zedward856-spec/minideck/README.md

# Minideck

A pocket clamshell cyberdeck. It's fully parametric (Python + [build123d](https://github.com/gumyr/build123d)) and printed on a Bambu printer.

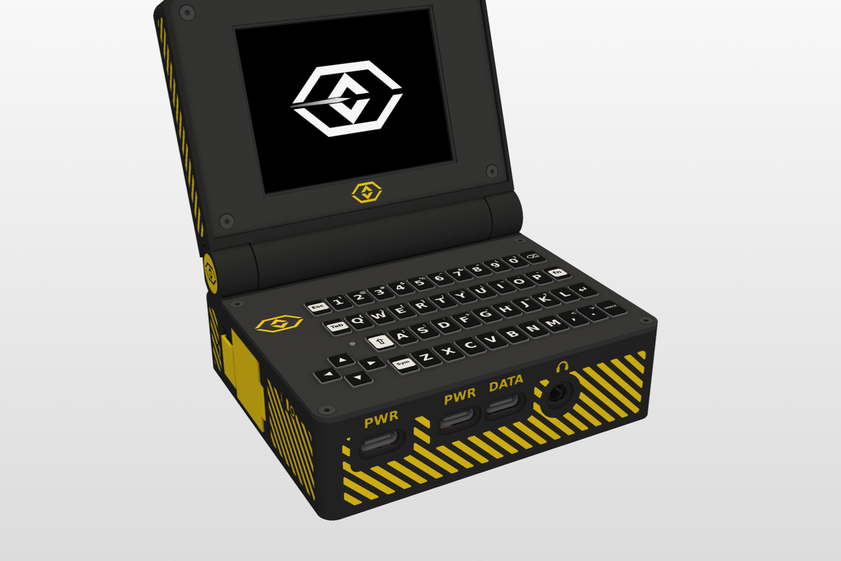
[picture p1: docs/img/palette1_front.png]
Minideck, Cyber yellow


**[Print files →](print/)** · **[Build guide →](BUILD.md)** · [Wiring](WIRING.md) · Promo site: https://zedward856-spec.github.io/minideck-site/ (its own repo: [minideck-site](https://github.com/zedward856-spec/minideck-site)) · [3D viewer / AR](https://zedward856-spec.github.io/minideck-site/viewer/) · [Wiring](https://zedward856-spec.github.io/minideck-site/wiring/) · [Thermal lab](https://zedward856-spec.github.io/minideck-site/thermal/)

Reports: [fit checks](reports/fit_report.md) · [assembly check](reports/assembly_report.md) · [thermal](reports/thermal_report.md) · [printability](reports/printability_report.md) · **[print simulation](docs/print-sim/README.md)** (every part sliced: layers, time, filament)

- **Size:** 93.7 × 81.5 × 39.5 mm (closed).
- **Lid:** opens to 180° on a hidden torque hinge with a hollow axle for the cables.
- **Battery:** one protected 18650 behind a hinged door, held shut by a C-clip lock.
- **Power switch:** a flush slide switch in the left wall; its printed fin sits level with the case so it can't get bumped in a pocket.
- **Power:** Pololu U3V40F5 5 V boost (~2.6 A).

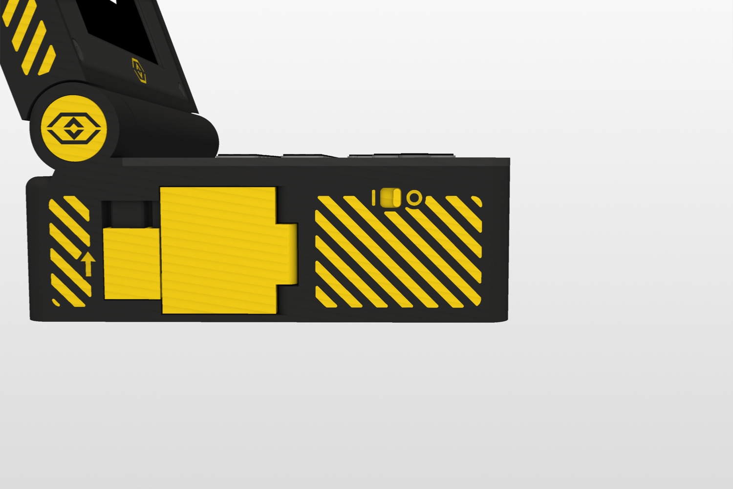
[picture p2: docs/img/left_switch.png]
Left side: battery door and the flush power switch


---

## Colour palettes

Press keys **1–6** in the viewer to switch palettes live. Palette 1 is the one being printed.

| # | Palette | Front | Back |
|---|---|---|---|
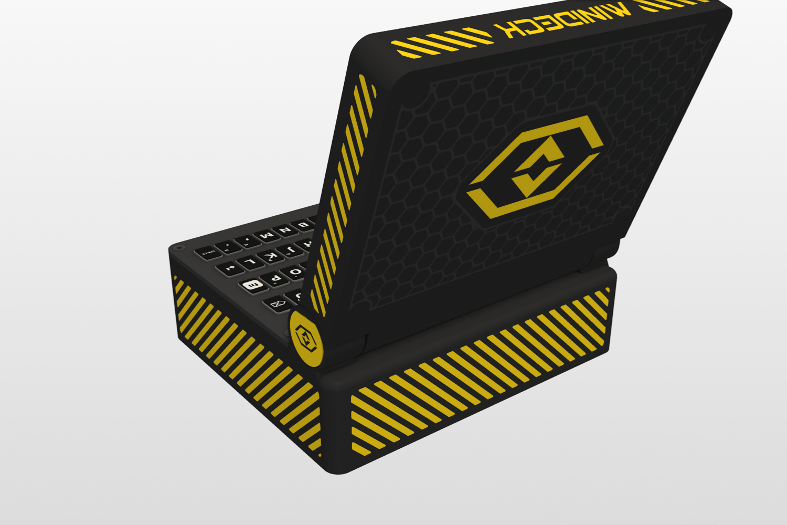
[picture p3: docs/img/palette1_back.png]
| 1 | **Cyber yellow** (print colours) |  |  |
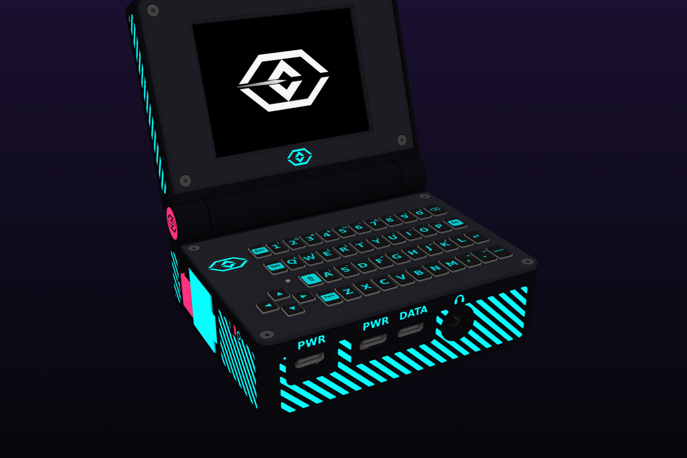
[picture p4: docs/img/palette2_front.png]
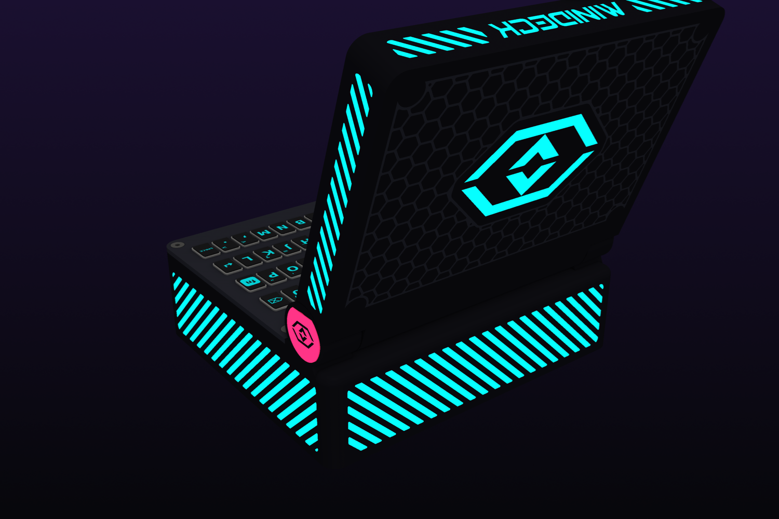
[picture p5: docs/img/palette2_back.png]
| 2 | **Neon night** |  |  |
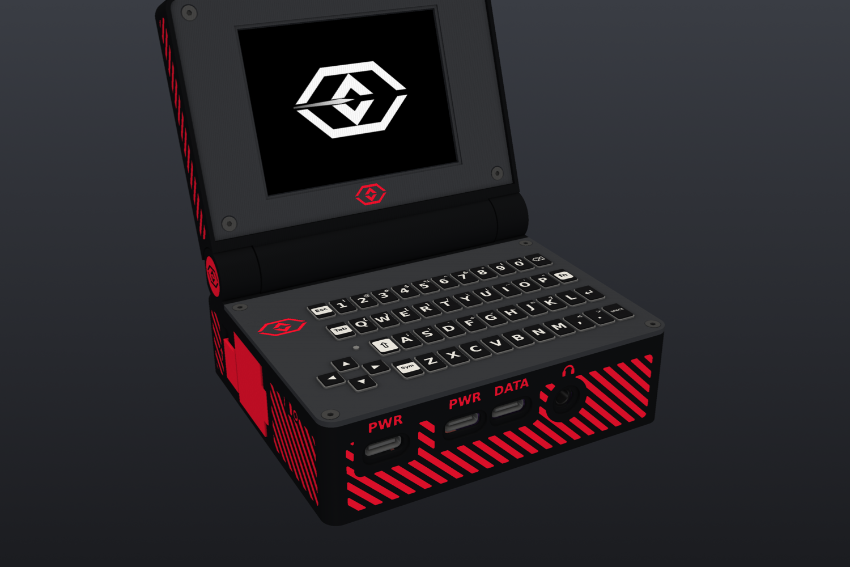
[picture p6: docs/img/palette3_front.png]
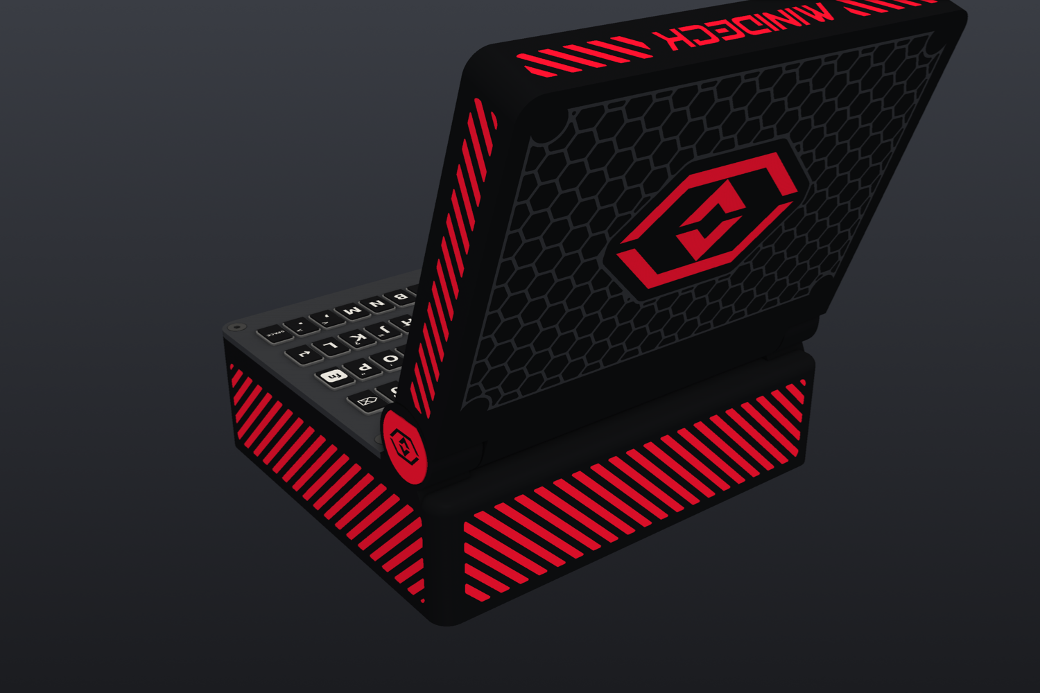
[picture p7: docs/img/palette3_back.png]
| 3 | **Arasaka** |  |  |
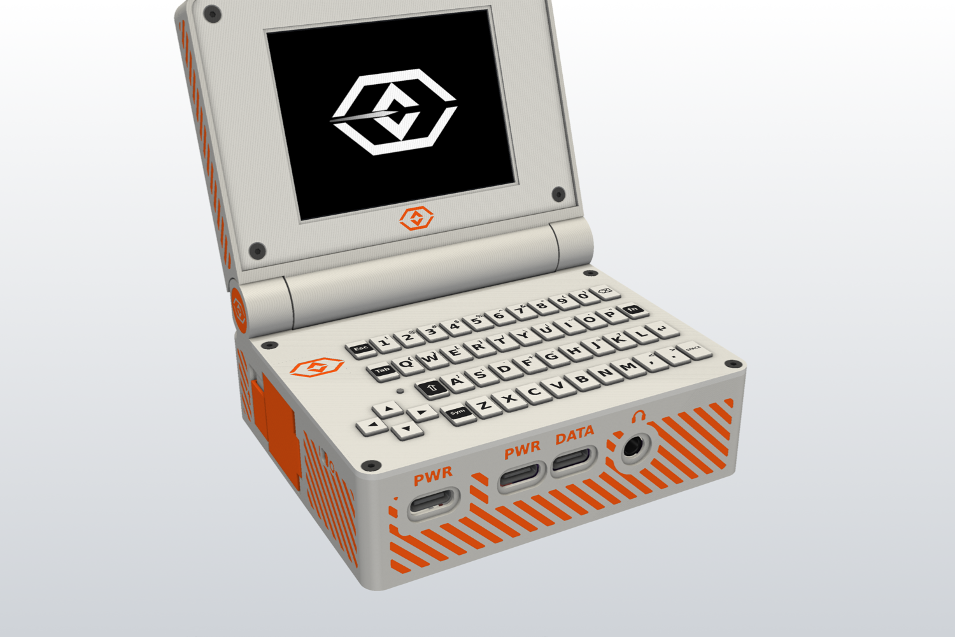
[picture p8: docs/img/palette4_front.png]
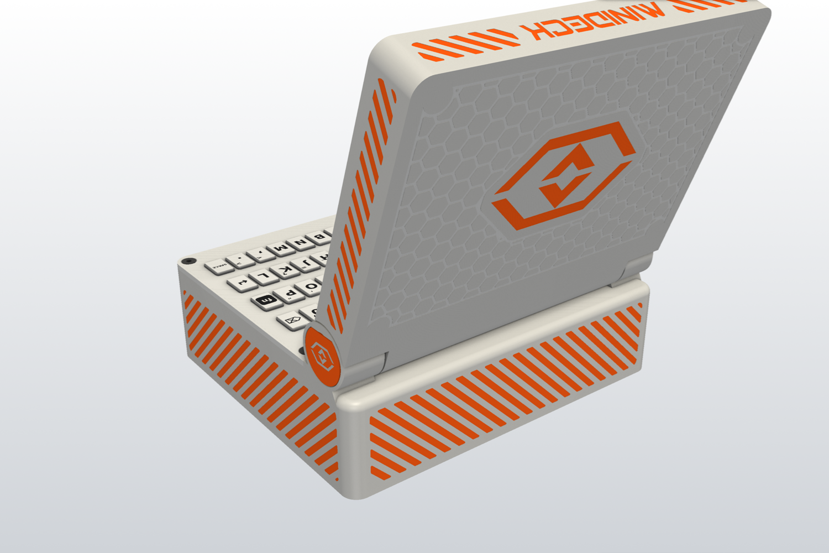
[picture p9: docs/img/palette4_back.png]
| 4 | **Snow** |  |  |
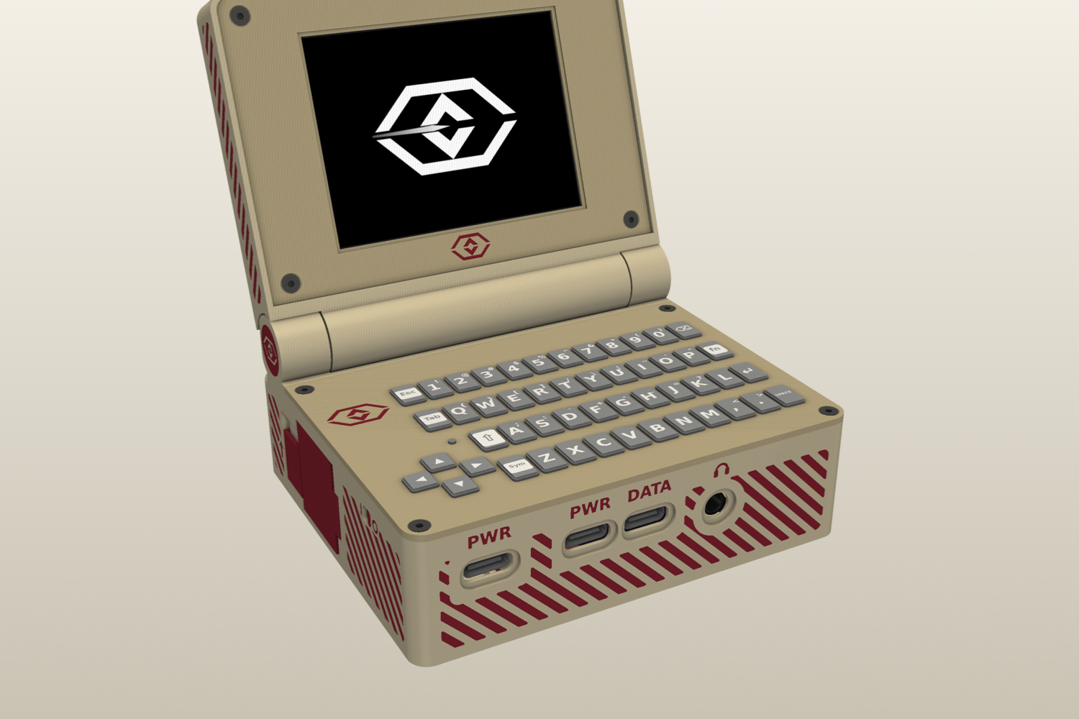
[picture p10: docs/img/palette5_front.png]
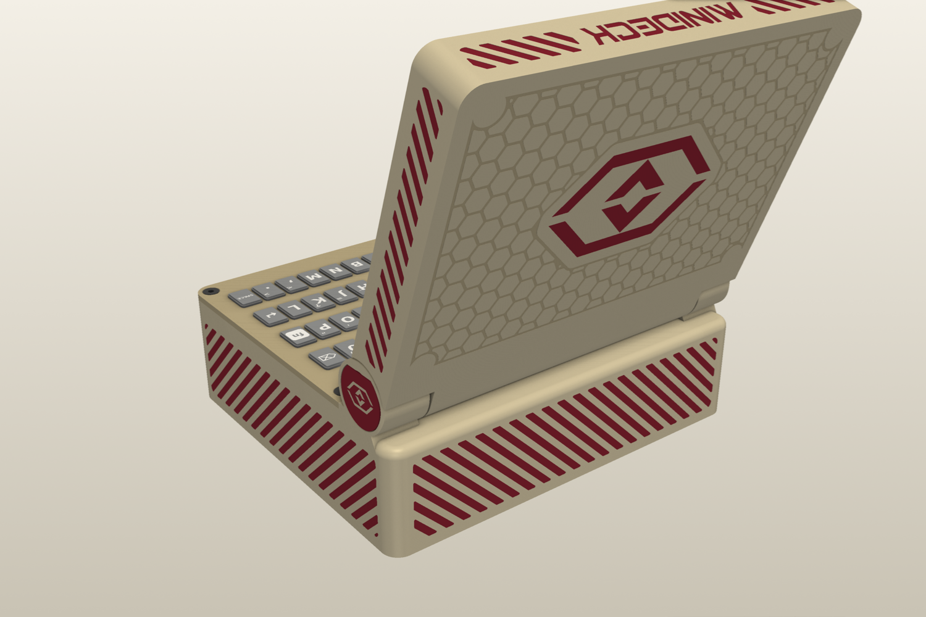
[picture p11: docs/img/palette5_back.png]
| 5 | **Retro beige** |  |  |
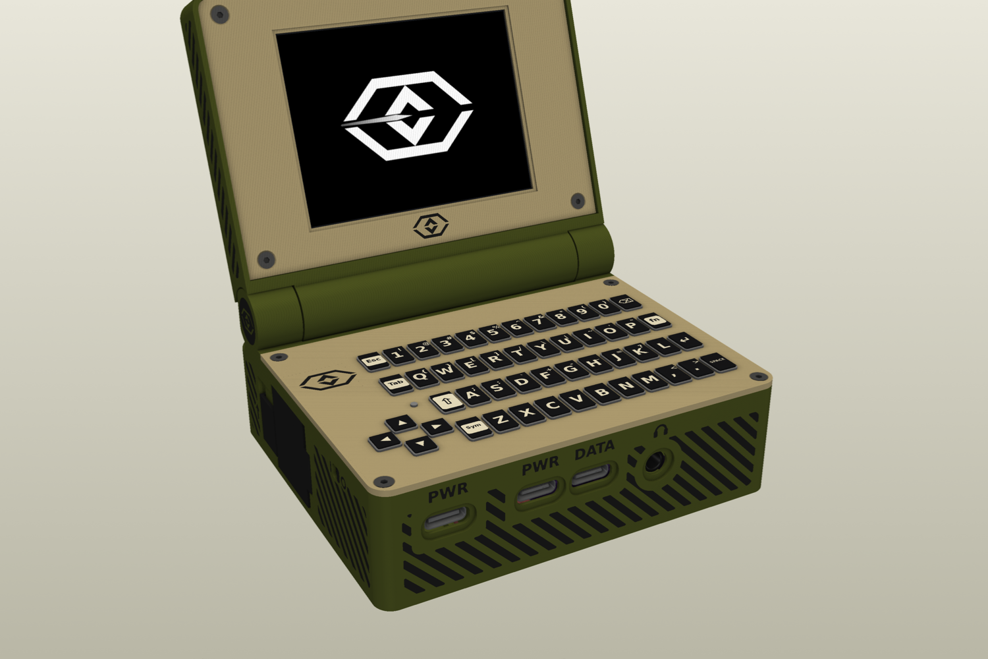
[picture p12: docs/img/palette6_front.png]
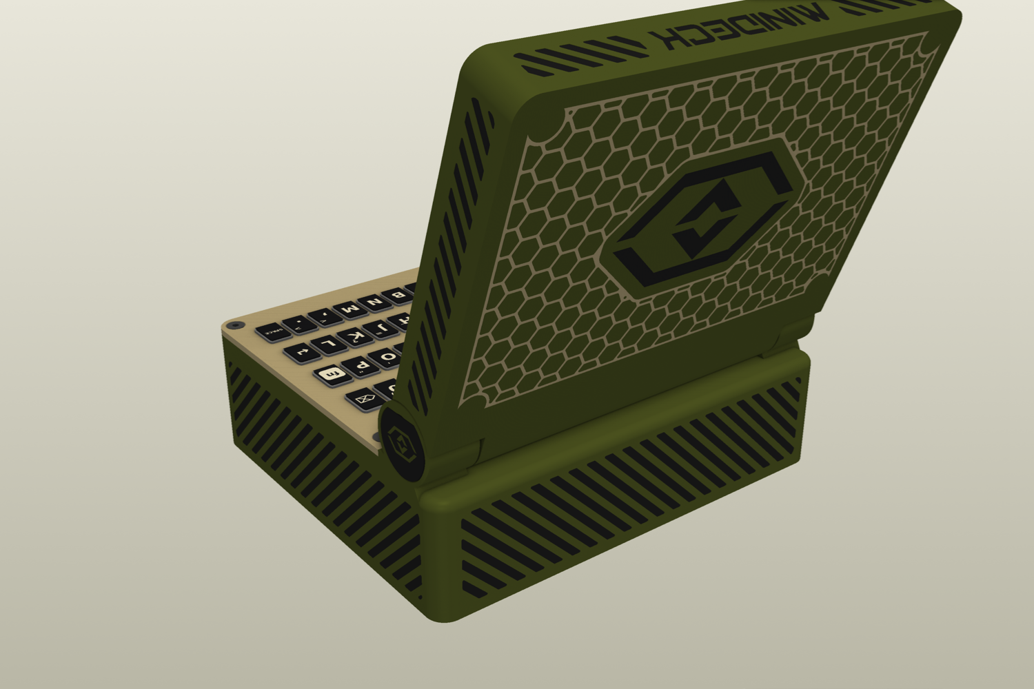
[picture p13: docs/img/palette6_back.png]
| 6 | **Field olive** |  |  |

| # | Body | Plate / bezel | Accent | Keys / legends |
|---|---|---|---|---|
| 1 | `#2D2D2D` charcoal | `#3D3D3D` dark grey | `#F7D116` cyber yellow | black / white |
| 2 | `#0D0D12` | `#22232C` | `#05D9E8` cyan + `#FF2A6D` magenta | black / cyan |
| 3 | `#111214` | `#3B3D42` | `#E0102A` red | black / white |
| 4 | `#E7E6E1` | `#F6F6F3` | `#FF5A10` orange | white / black |
| 5 | `#D6C9A8` | `#BFB08C` | `#7A1F2B` maroon | grey / white |
| 6 | `#4B5320` olive | `#B8A77C` tan | `#1A1A1A` black | black / cream |

The logos, MINIDECK text, side stripes and the NFC mark on the underside are engraved 0.3–0.6 mm deep.

**Underside:** an NFC mark right under the PN532 (board outline, antenna coil, NFC, 13.56 MHz, ISO 14443 A/B, TAP HERE).

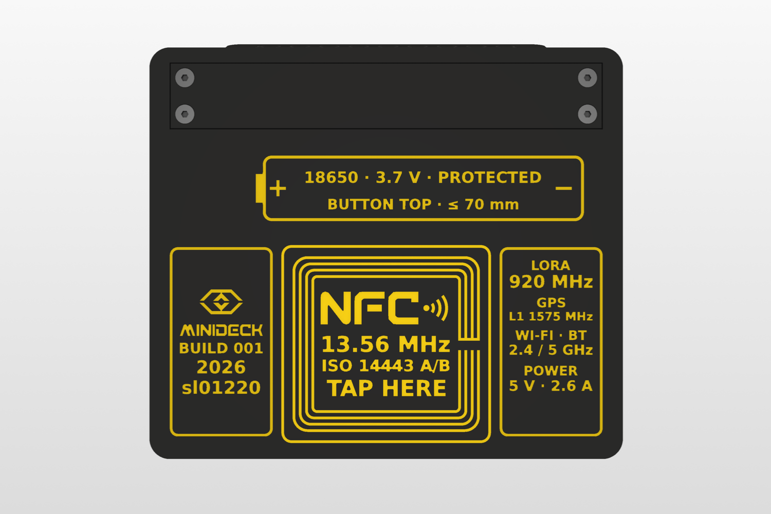
[picture p14: docs/img/underside_nfc.png]
Underside NFC mark

 The renders show them paint-filled: fill them with a paint marker and wipe the surface with IPA. No multi-colour printer needed.

---

## Parts list

### Printed parts

Ready-to-print files are in **[`print/`](print/)**: one folder per filament colour, already in print orientation. Their source files are below, in `out/`.

| File | Part | Colour (palette 1) | Notes |
|---|---|---|---|
| `bottom.stl` | Case bottom: battery chamber, hinge box, ports | Charcoal `#2D2D2D` | Main body; M2 heat-set inserts |
| `keyboard_top.stl` | Keyboard plate | Dark grey `#3D3D3D` | 4 × M2 × 4 screws; 0.12 mm layers recommended (0.42 mm webs) |
| `screen_back.stl` | Lid shell | Charcoal `#2D2D2D` | Lid-back logo, MINIDECK text, stripes |
| `screen_front.stl` | Screen bezel | Dark grey `#3D3D3D` | 4 × M2 screws into lid inserts |
| `box_hatch.stl` | Hinge-box floor hatch | Charcoal `#2D2D2D` | 4 × M2 screws |
| `battery_door.stl` | 18650 battery door | Cyber yellow `#F7D116` | **Print upright, with a brim** |
| `battery_lock_slider.stl` | Battery door C-clip lock | Cyber yellow `#F7D116` | Slides on a rail; no screw |
| `hinge_cap.stl` | Torque hinge end cap | Cyber yellow `#F7D116` | Logo engraved |
| `hinge_axle.stl` | Hollow hinge axle (cable bore) | Cyber yellow `#F7D116` | Logo on the flange |
| `battery_strip_test.stl` | Battery door / lock test strip | any | Optional fit test |

Suggested filament: Bambu PLA Matte Charcoal, PLA Basic Dark Gray and PLA Basic Sunflower Yellow.
`printability_report.md` has the full print audit.

### Electronics

| Part | Role |
|---|---|
| Radxa ZERO 3W | Main computer (mounted upside down, wires soldered to the header pads) |
| EP28060S 2.8″ non-touch IPS panel | Display (in the lid) |
| EHD-40P-V3 HDMI driver board | Display driver (in the lid) |
| M5Stack CardKB + HarukiToreda silicone cover | Keyboard (I²C) |
| PN532 | NFC reader (I²C, chained with the CardKB) |
| PCM5102 I²S DAC | Audio out, 3.5 mm jack |
| Ebyte E22-900T22S | LoRa radio (UART4) |
| GPS module (ATGM336H-class) + 18 × 18 mm ceramic patch | GPS (UART3); patch antenna in the lid |
| NooElec NESDR Nano 2+ | SDR, wired to header pins 27/28 (USB2 HOST2) – no hub |
| Molex 211140 / 146153 FPC antennas | LoRa, Wi-Fi/BT and SDR antennas |
| TP4056 (USB-C) | 18650 charger |
| Pololu U3V40F5 | 5 V boost, ~2.6 A (fed past the charger's protection) |
| Protected high-drain 18650 (button top, ≤ 70 mm) | Battery |

### Hardware

| Qty | Part |
|---|---|
| 12 | M2 × 4 countersunk screws (plate 4, hatch 4, bezel 4) |
| 8 | M2 heat-set inserts, Ø3.5 × 3 mm (hole Ø3.2): 4 hatch, 4 bezel (the plate screws go into printed pilots) |
| 1 | Friction torque hinge (pocket in the left hinge cheek) |
| – | Silicone wire: 22/24 AWG for power, 28–30 AWG for signals; 1.13 mm u.FL coax for the antennas |

Every wire, pin and splice is in **[WIRING.md](WIRING.md)**. The same wiring as Obsidian canvases (open the folder as a vault, or drop the files into one): [every wire](wiring/minideck-wiring-all.canvas) (47) · [power only](wiring/minideck-wiring-power.canvas) (25).

---

## Thermal

A 3D thermal simulation of the base (`cad/thermal_sim.py`: every part on a 1 mm grid, heat from the SoC, SDR, boost, charger and
cell, conduction inside, convection + radiation outside) compares the current sealed design with vents, PETG, an aluminium
heat path, a micro blower and software limits. **[Interactive thermal lab →](https://zedward856-spec.github.io/minideck-site/thermal/)**:
pick a load and a cooling option, slice through the deck, hover for temperatures, or see everything above a threshold in 3D.
Full table: [thermal_report.md](reports/thermal_report.md).

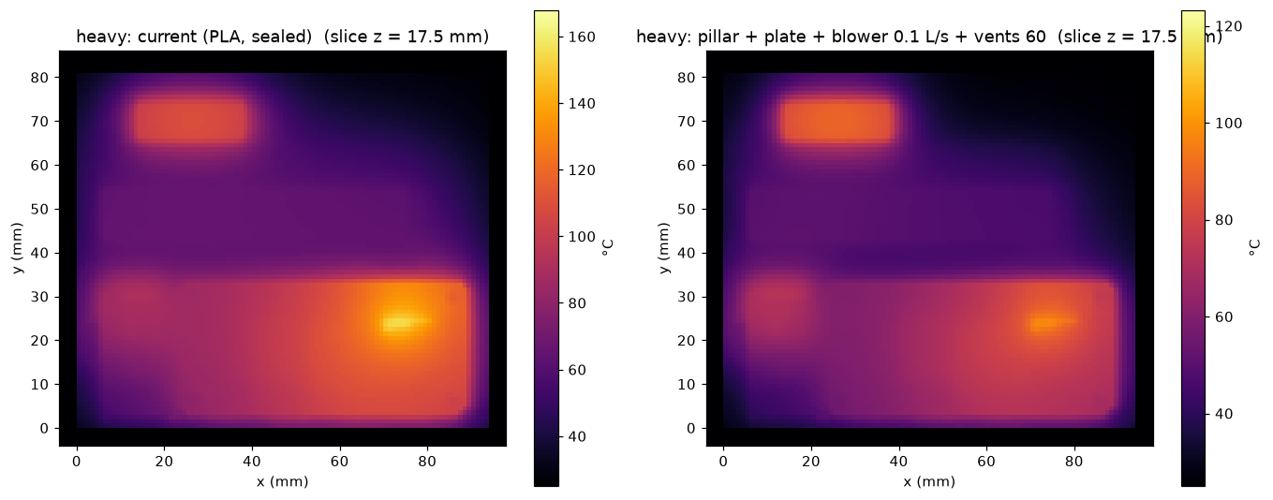
[picture p15: previews/thermal_compare.png]
Thermal: heavy load, current vs best option


| Heavy use (SDR + Wi-Fi + CPU) | SoC | Battery | SDR |
|---|---|---|---|
| current (PLA, sealed) | 168 °C | 68 °C | 114 °C |
| vents 150 mm² | 163 | 65 | 110 |
| Al pillar SoC → Al floor plate | 129 | 67 | 113 |
| micro blower 0.2 L/s + vents | 131 | 46 | 84 |
| pillar + plate + blower + vents | **105** | **53** | **94** |
| SDR switched off | 166 | 59 | 38 |
| CPU capped at 1.2 W | 119 | 65 | 112 |

Typical use, sealed: SoC ~81 °C, battery ~40 °C. Vents barely help (the deck is only ~15 mm tall inside); the aluminium path is
the biggest win for the CPU, a blower for the battery and SDR. Sustained heavy load is shown un-throttled: the real SoC slows
itself down around 85–95 °C. Estimates for comparing options, not lab measurements.

## Repository layout

```
README.md  BUILD.md  WIRING.md    start here: overview, build guide, every wire
print/      the print files, one folder per filament colour
wiring/     Obsidian canvases of the wiring (every wire / power only)
reports/    fit checks, assembly simulation, thermal simulation, printability
cad/        the parametric CAD + check / simulation / export scripts (Python, build123d)
app/        the offline Android viewer app (com.zedward.minideck)
models/     source models, fonts, logo, component models
out/        raw CAD output (STL, STEP, meshes in place)
docs/img/   README renders        previews/   check / thermal preview images
```

Scripts run from anywhere (they switch to the repo root themselves), e.g. `python3 cad/base.py`.

| Path | What |
|---|---|
| `cad/params.py` | Every dimension and option (logos, stripes, text, inserts, radios) |
| `cad/layout.py` | Places the parts from the reference layout `models/minideck.stl` |
| `cad/base.py`, `cad/lid.py`, `cad/battery_test.py` | Case bottom, plate, hatch, hinge / lid shell and bezel / battery chamber, door and lock |
| `cad/stripes.py`, `cad/logo.py`, `cad/fills.py` | Hazard stripes, Optic logo engraving, paint-fill preview meshes |
| `cad/marks.py`, `cad/nfc_mark.py` | Engraved labels: PWR / PWR / DATA + headphones over the ports, &#124; / O by the power switch, open arrow by the battery lock, underside battery outline + ID and radio plates, NFC mark, lid hex texture (each clipped so ≥ 0.45 mm of wall stays) |
| `cad/wiring.py` | Wiring plan + 3D wire routes (`WIRING.md`) |
| `cad/keycaps.py`, `cad/screws.py` | Viewer-only silicone keycaps and screws |
| `cad/check.py` | Fit / clearance requirements (`reports/fit_report.md`) |
| `cad/assembly_check.py` | Simulates the whole build part by part: can every part get in? (`reports/assembly_report.md`) |
| `cad/thermal_sim.py`, `cad/thermal_export.py` | 3D thermal simulation (`reports/thermal_report.md`) and its export for the interactive thermal lab |
| `cad/printability.py` | Print audit → `reports/printability_report.md` |
| `cad/viewer.py` | Interactive 3D viewer |
| `print/` | **The print files**, one folder per colour (`python3 cad/export_print.py` rebuilds it) |
| `out/` | Raw CAD output: STLs, STEP assemblies, `parts_in_place/` meshes for the viewer |
| `models/` | Source models, Corpta font, logo SVG, Radxa downloads and schematic; `models/components/` real part models (sources in [BUILD.md](BUILD.md#component-models)), `models/coloured/` their real-colour versions |
| `docs/img/` | README renders |
| `app/` | Offline Android viewer: `app/build.sh install` bundles the site's model and installs it (see [app/README.md](app/README.md)) |
| `cad/print_sim.py` | Slices every print file with PrusaSlicer and renders the layers, times and filament → `docs/print-sim/` |
| `cad/site_wiring.py` | Data for the site's wiring page (pin map, every wire, notes, canvases) |
| `wiring/` | `minideck-wiring-all.canvas` (47 wires), `minideck-wiring-power.canvas` (25), made by `cad/wiring_canvas.py` |

## Promo site

Live at https://zedward856-spec.github.io/minideck-site/ (repo `minideck-site`). Re-export the web model with `python3 cad/site_export.py && python3 cad/plan_explode.py` (writes into `../minideck-site/assets/`; the second plans the collision-free teardown).

## Build and view

```bash
pip install build123d trimesh manifold3d shapely pyvista pillow
python3 cad/battery_test.py && python3 cad/base.py && python3 cad/lid.py && python3 cad/wiring.py && python3 cad/fills.py && python3 cad/check.py
python3 cad/viewer.py            # 1-6 palettes · g stripe fill · scroll the part list · sliders for lid angle / transparency
```

Re-render the README images (product shots with no UI):

```bash
MINIDECK_CLEAN=1 MINIDECK_PALETTE=1 python3 cad/viewer.py --shot docs/img/palette1_front.png
MINIDECK_CLEAN=1 MINIDECK_PALETTE=1 MINIDECK_CAM="[(190,230,140),(47,42,25),(0,0,1)]" python3 cad/viewer.py --shot docs/img/palette1_back.png
```

---

© zedward. The Corpta font is a demo licence, the Radxa models and schematic are © Radxa, and the logo is the author's own.
