zedward856-spec/minideck/docs/img/palettes_grid.png

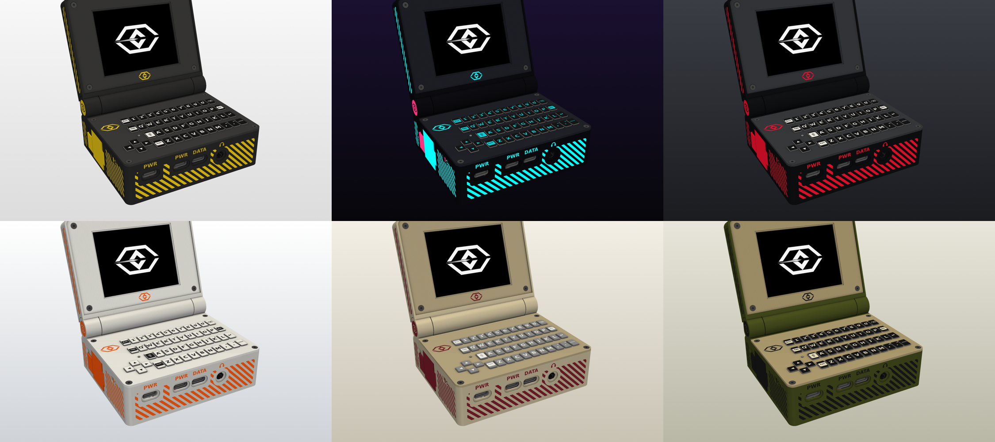
docs/img/palettes_grid.png
