zedward856-spec/minideck/models/nzxt_reference.jpg

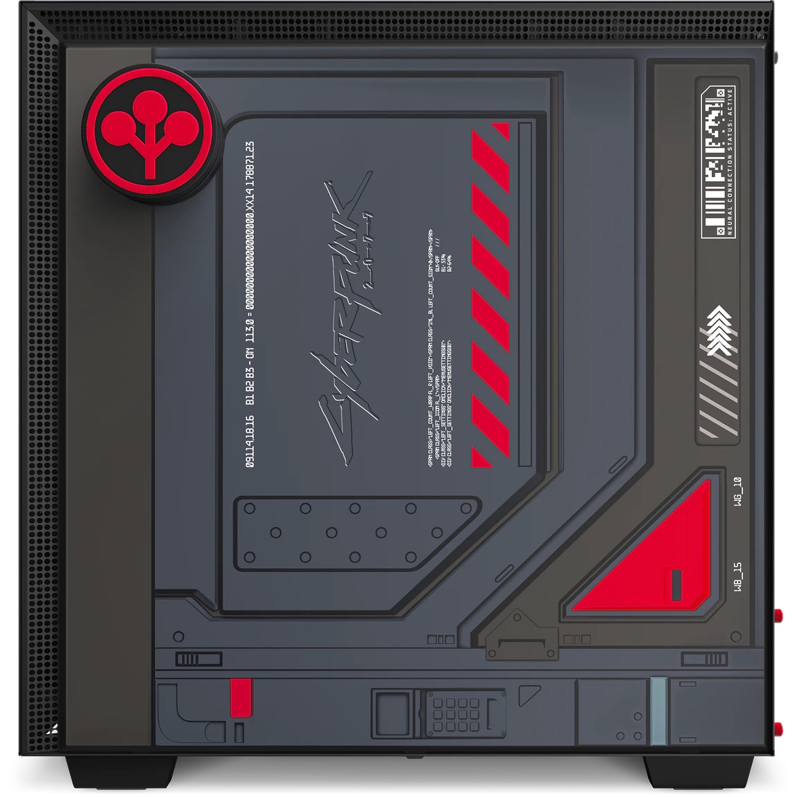
models/nzxt_reference.jpg
