zedward856-spec/minideck/models/optic-loading.gif

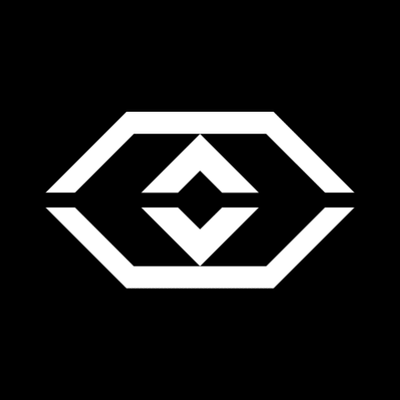
models/optic-loading.gif
