zedward856-spec/minideck/previews/1_front.png

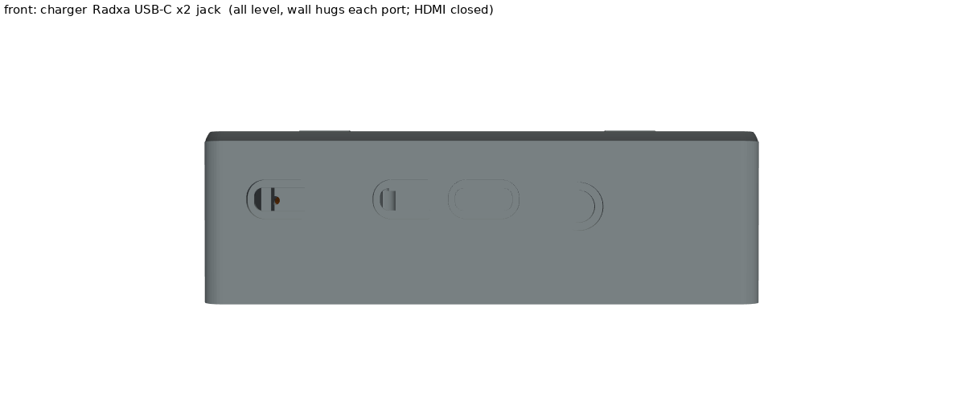
previews/1_front.png
