zedward856-spec/minideck/previews/2_back.png

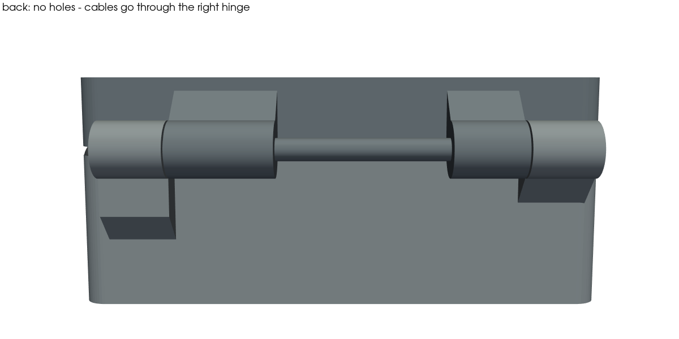
previews/2_back.png
