zedward856-spec/minideck/previews/4_open.png

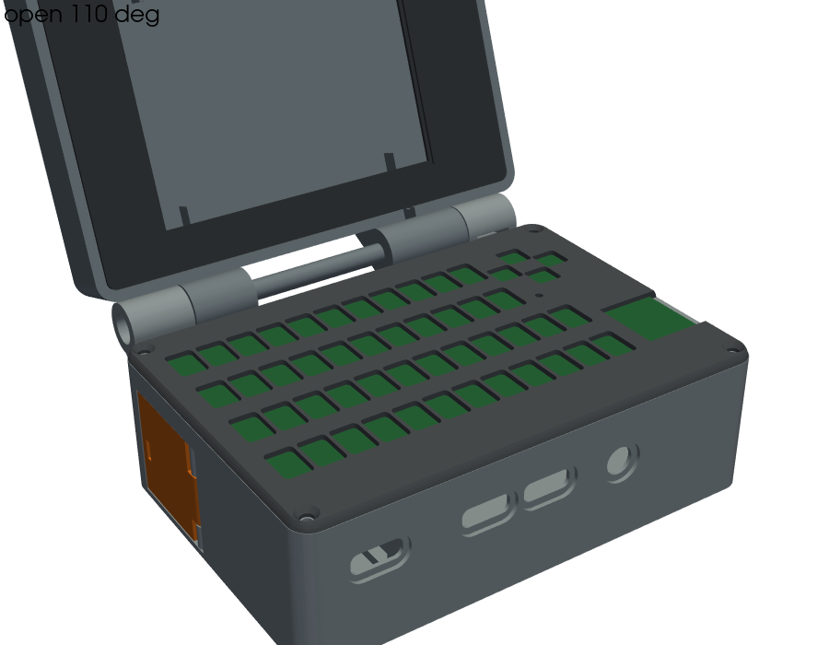
previews/4_open.png
