zedward856-spec/minideck/previews/battery_door_lock.png

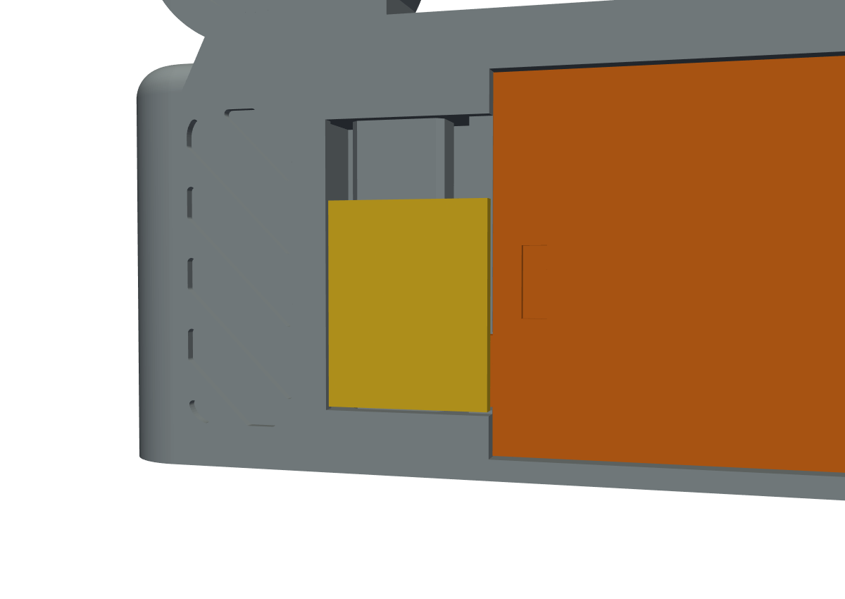
previews/battery_door_lock.png
