zedward856-spec/minideck/previews/bezel_seam.png

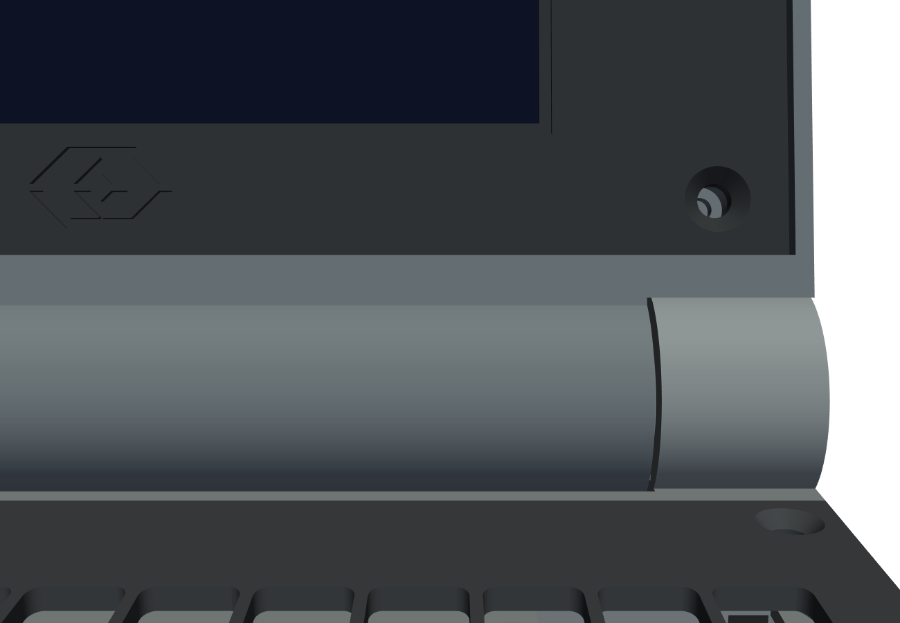
previews/bezel_seam.png
