zedward856-spec/minideck/previews/bezel_text.png

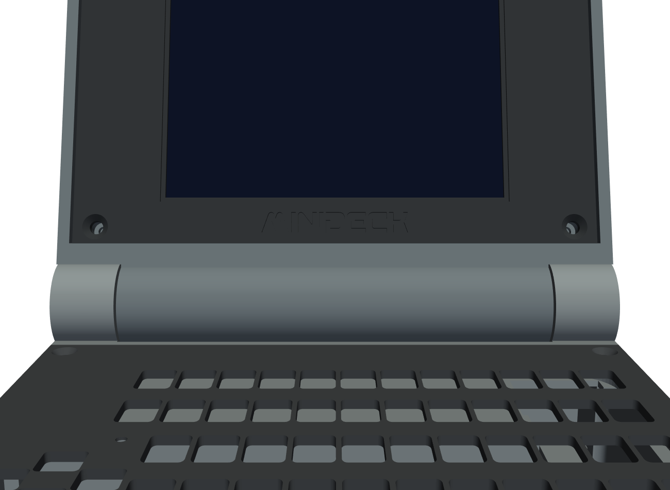
previews/bezel_text.png
