zedward856-spec/minideck/previews/box_closed_back.png

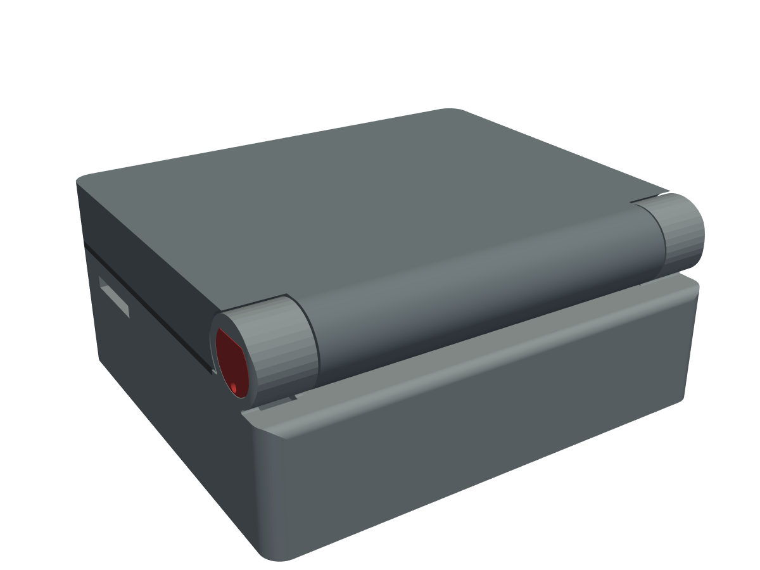
previews/box_closed_back.png
