zedward856-spec/minideck/previews/box_closed_side.png

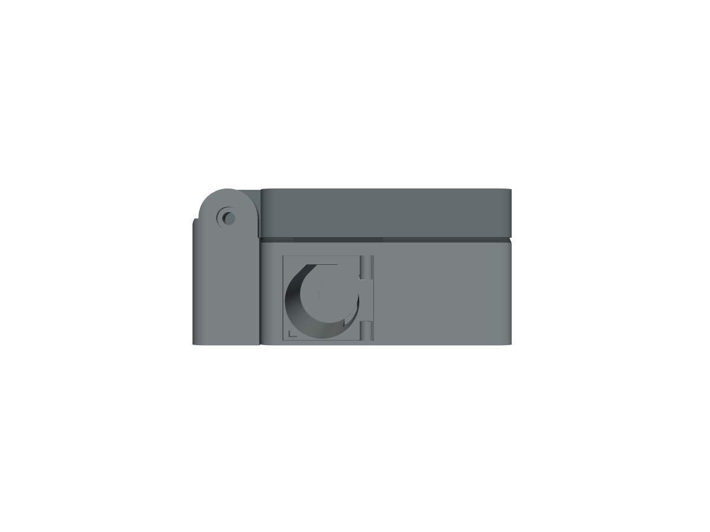
previews/box_closed_side.png
