zedward856-spec/minideck/previews/box_corner_left.png

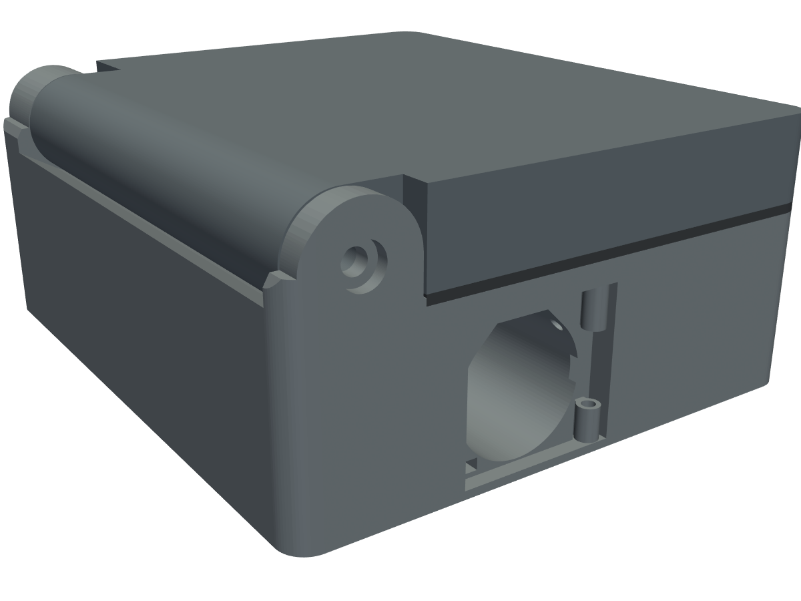
previews/box_corner_left.png
