zedward856-spec/minideck/previews/box_open_110.png

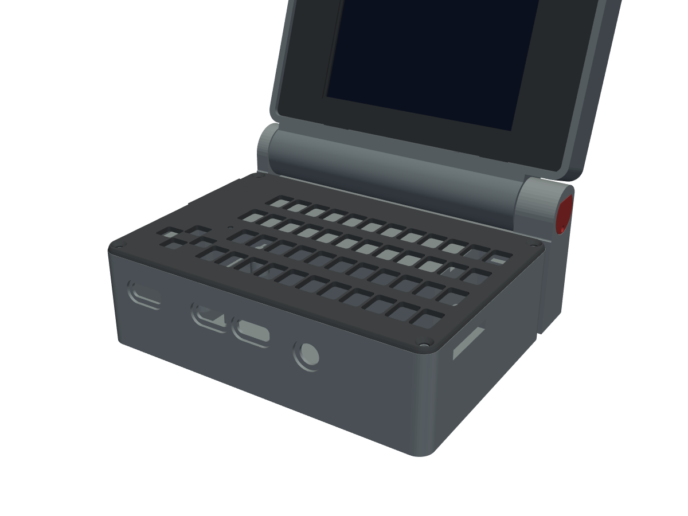
previews/box_open_110.png
