zedward856-spec/minideck/previews/box_open_150_side.png

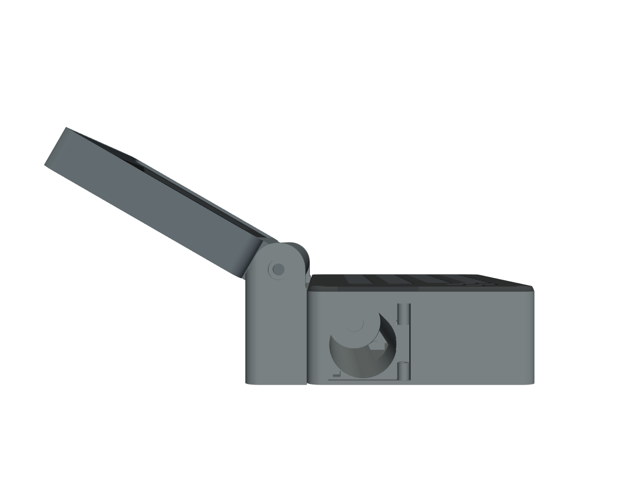
previews/box_open_150_side.png
