zedward856-spec/minideck/previews/box_section_cable.png

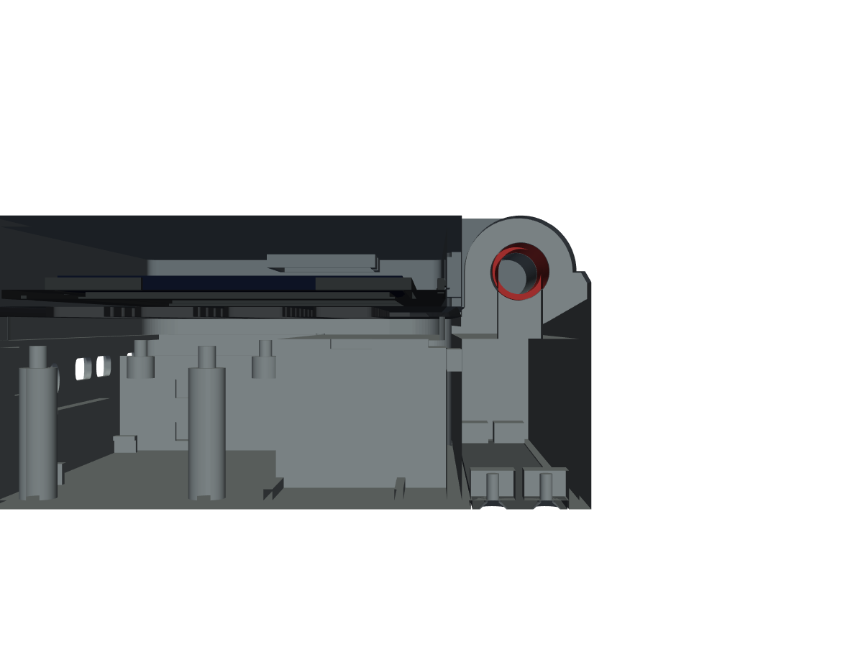
previews/box_section_cable.png
