zedward856-spec/minideck/previews/cheek_back_L.png

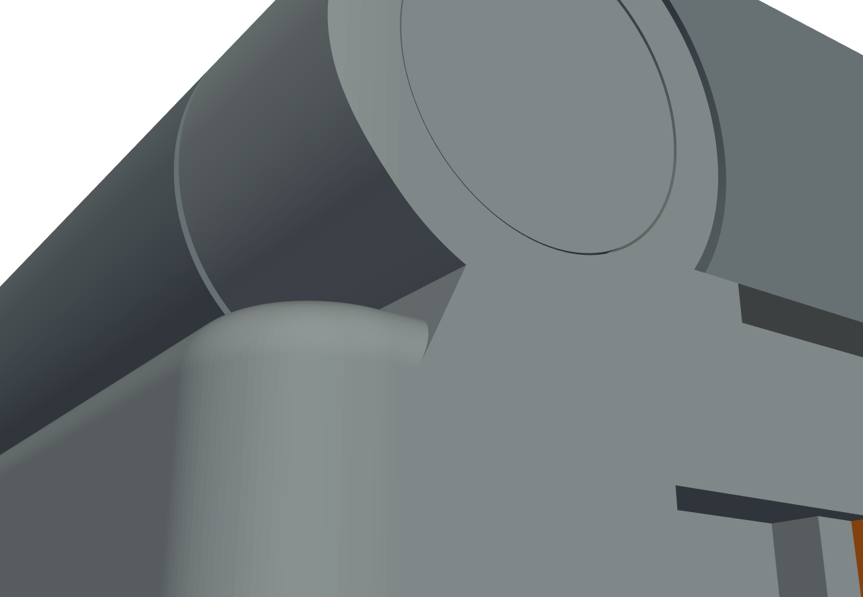
previews/cheek_back_L.png
