zedward856-spec/minideck/previews/cheek_back_R.png

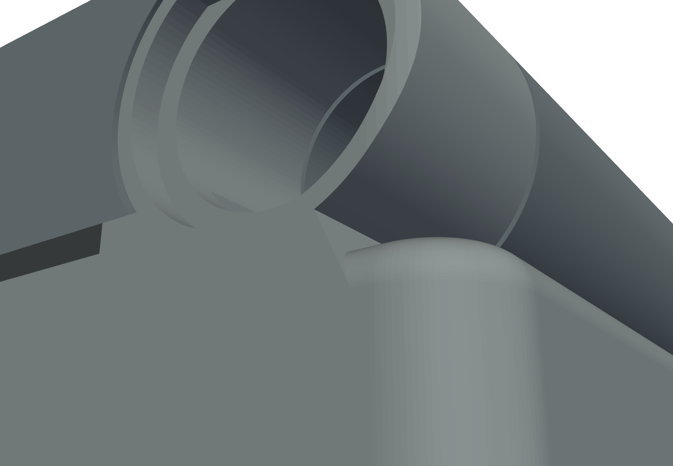
previews/cheek_back_R.png
