zedward856-spec/minideck/previews/corner_L.png

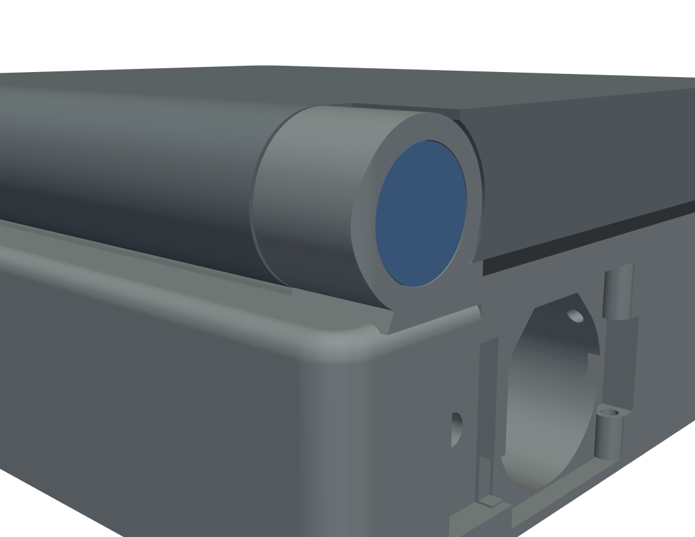
previews/corner_L.png
