zedward856-spec/minideck/previews/corner_R.png

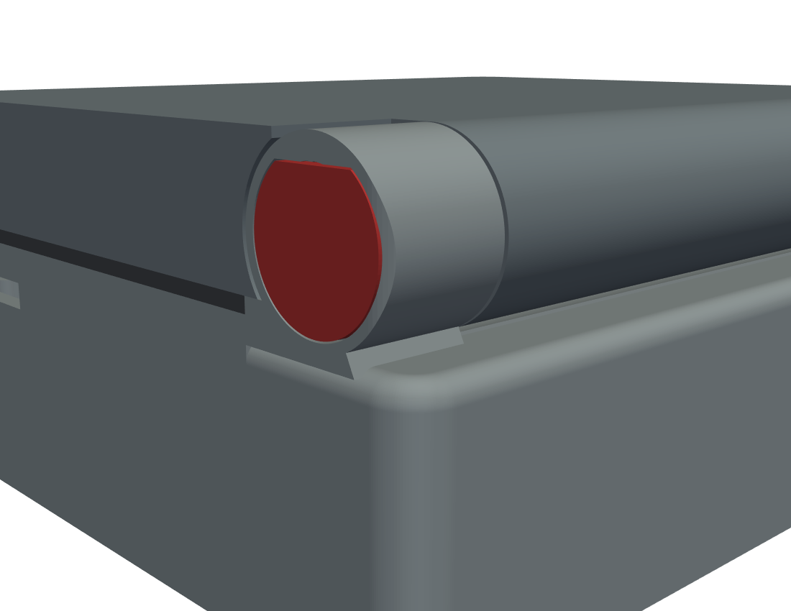
previews/corner_R.png
