zedward856-spec/minideck/previews/fill/back_0.png

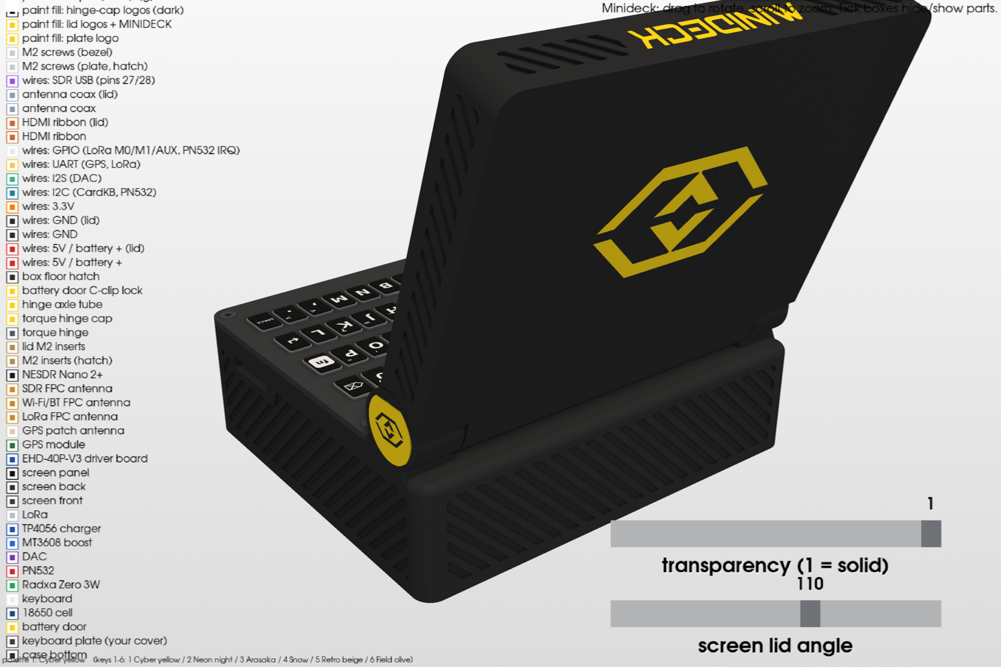
previews/fill/back_0.png
