zedward856-spec/minideck/previews/fill/front_0.png

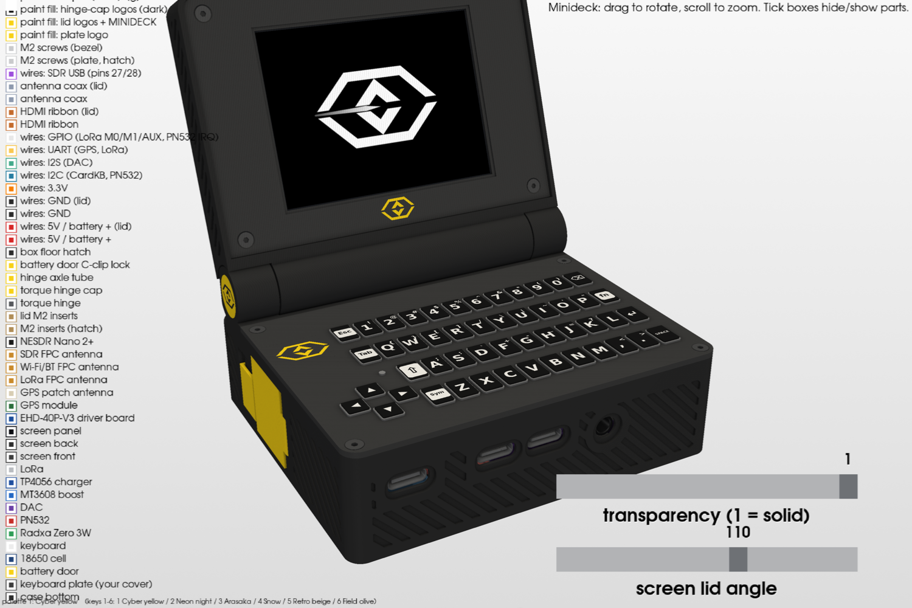
previews/fill/front_0.png
