zedward856-spec/minideck/previews/fill_compare.png

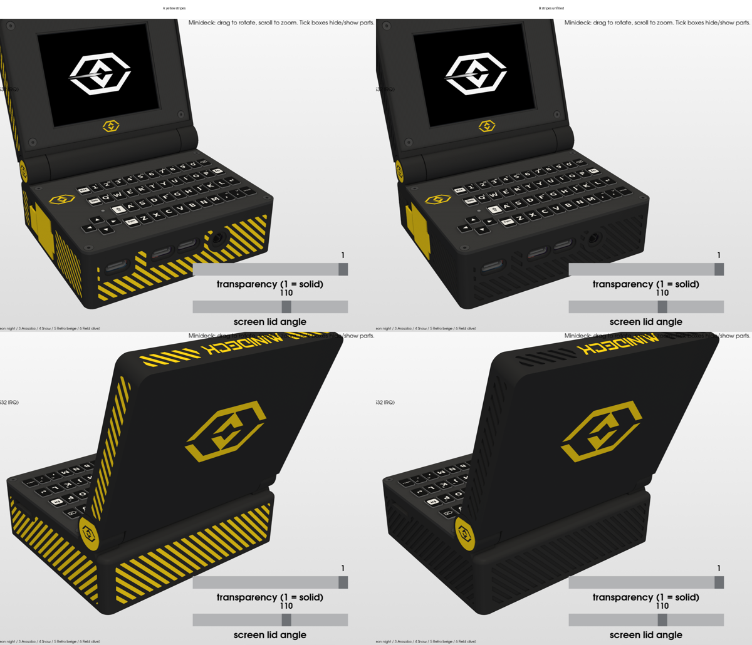
previews/fill_compare.png
