zedward856-spec/minideck/previews/gps_module_bay.png

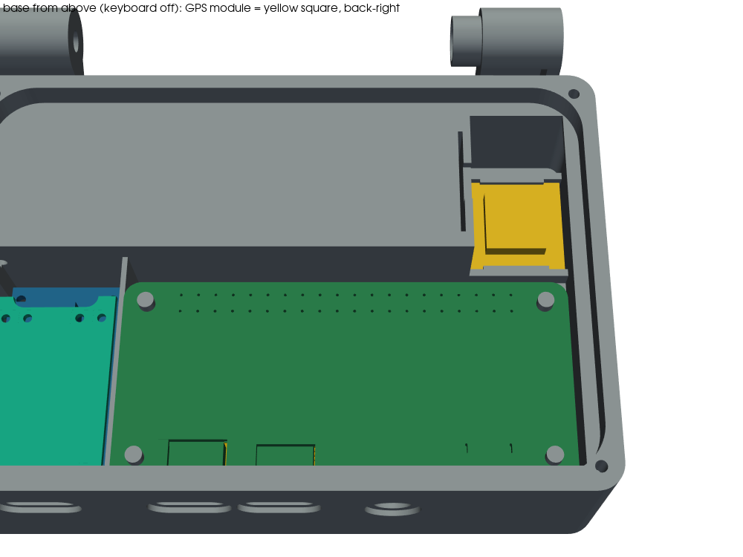
previews/gps_module_bay.png
