zedward856-spec/minideck/previews/gps_patch_lid.png

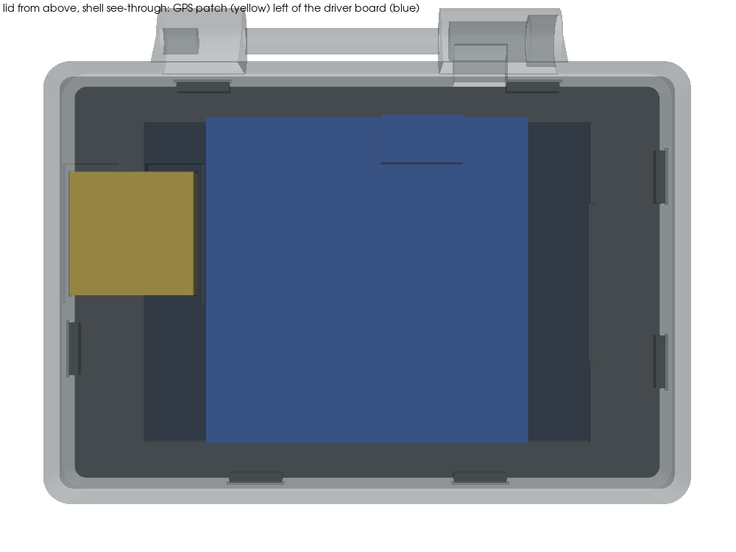
previews/gps_patch_lid.png
