zedward856-spec/minideck/previews/hinge_left_outside.png

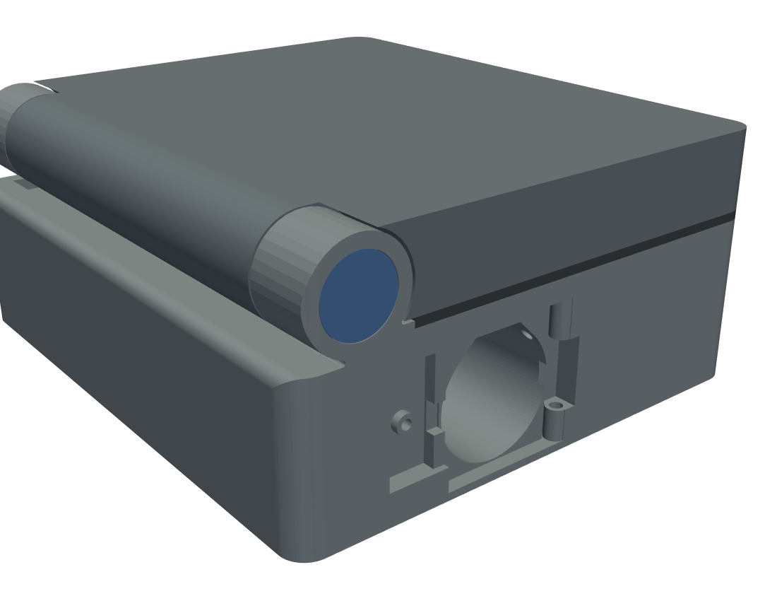
previews/hinge_left_outside.png
