zedward856-spec/minideck/previews/hinge_section.png

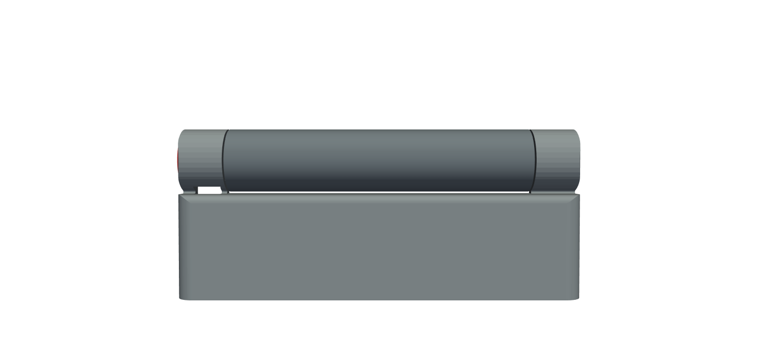
previews/hinge_section.png
