zedward856-spec/minideck/previews/keyboard_top_no_grove.png

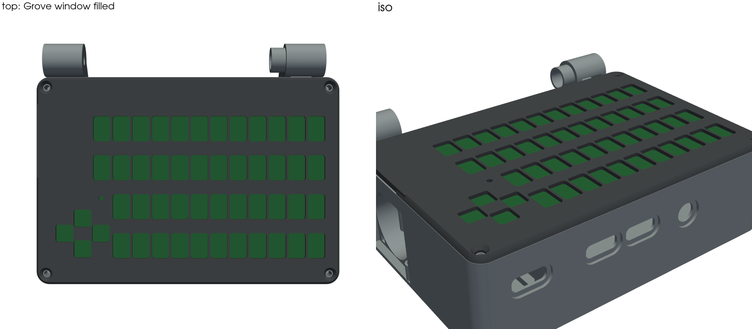
previews/keyboard_top_no_grove.png
