zedward856-spec/minideck/previews/keyboard_turned.png

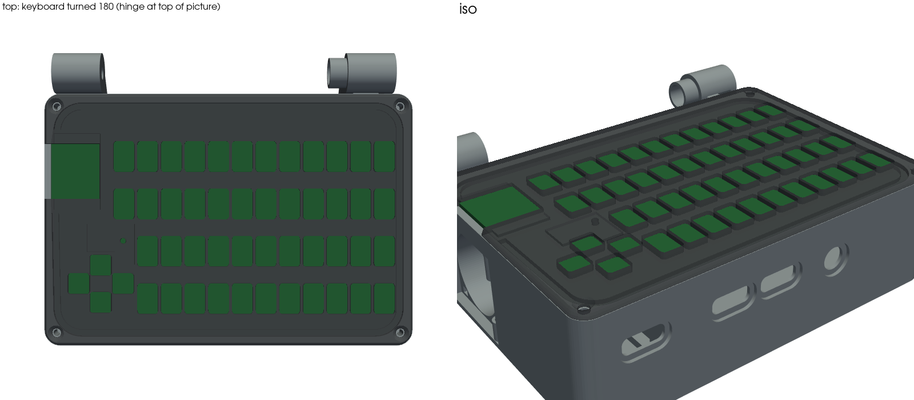
previews/keyboard_turned.png
