zedward856-spec/minideck/previews/left_hinge_side_fixed.png

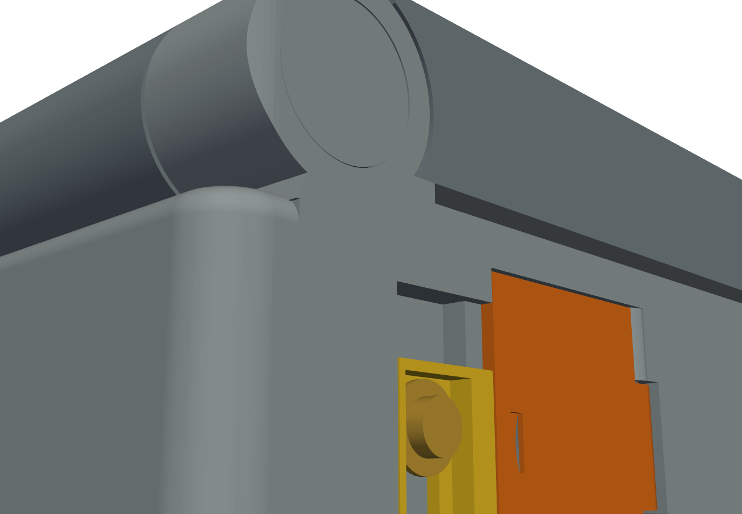
previews/left_hinge_side_fixed.png
