zedward856-spec/minideck/previews/lid_180_flat.png

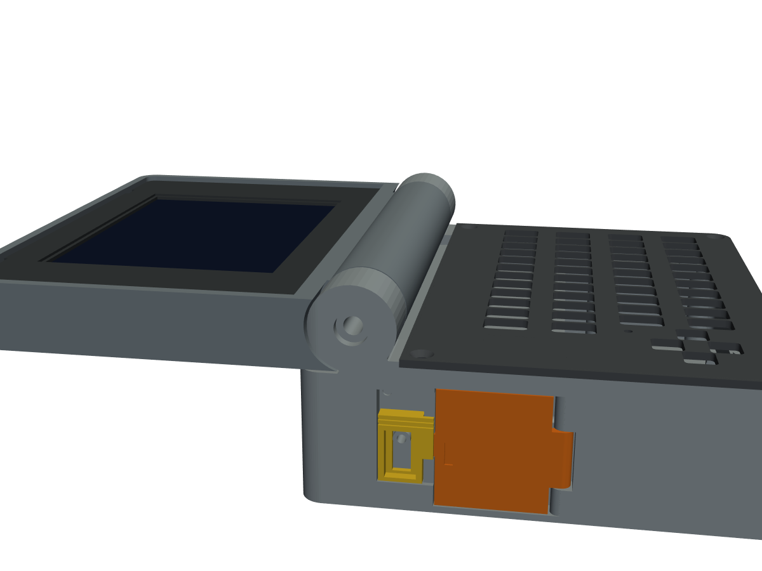
previews/lid_180_flat.png
