zedward856-spec/minideck/previews/lid_180_side.png

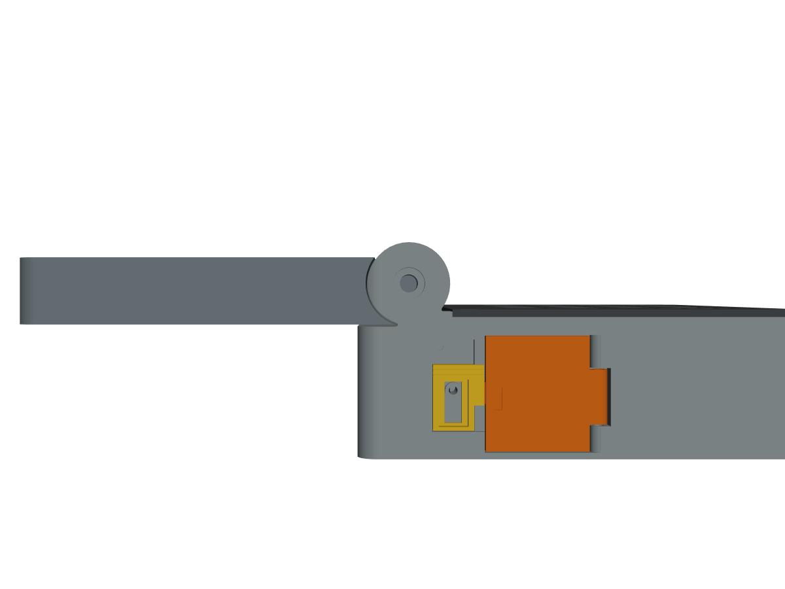
previews/lid_180_side.png
