zedward856-spec/minideck/previews/lid_text_front.png

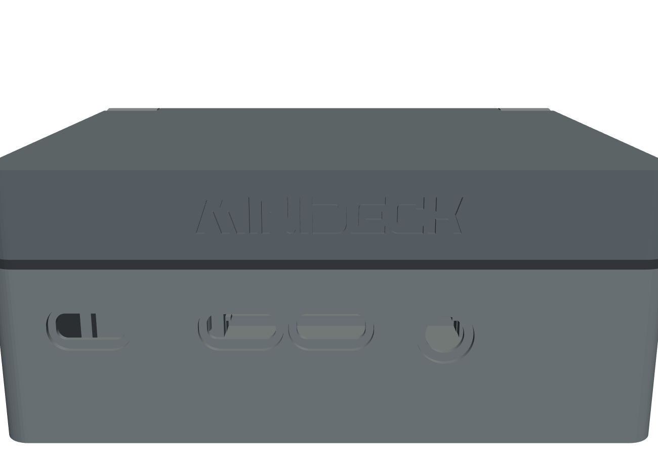
previews/lid_text_front.png
