zedward856-spec/minideck/previews/lid_text_top.png

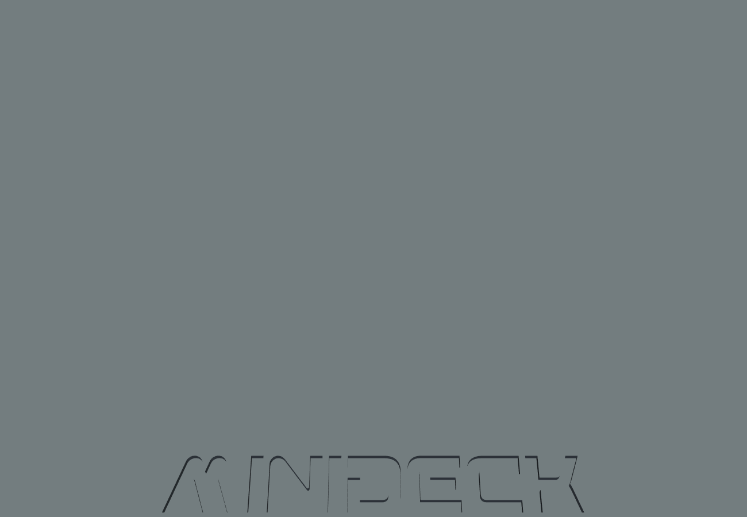
previews/lid_text_top.png
