zedward856-spec/minideck/previews/lock_clip_section.png

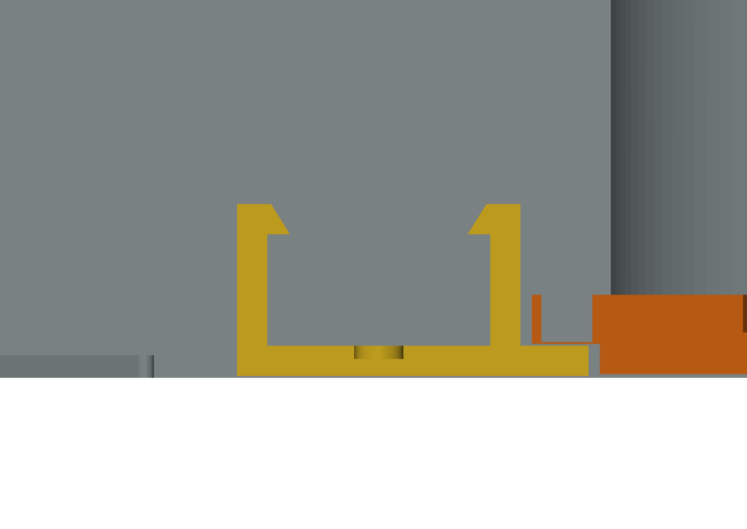
previews/lock_clip_section.png
