zedward856-spec/minideck/previews/marks_left.png

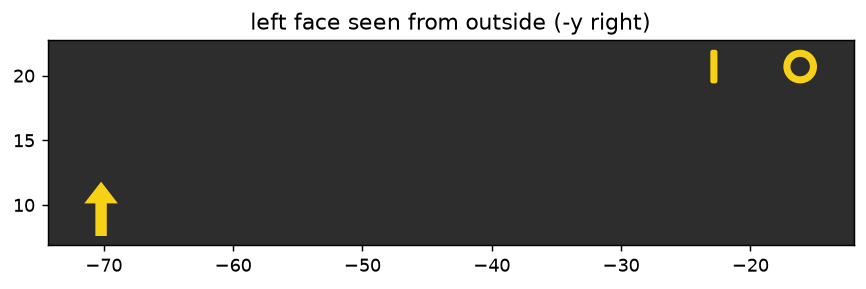
previews/marks_left.png
