zedward856-spec/minideck/previews/marks_lid.png

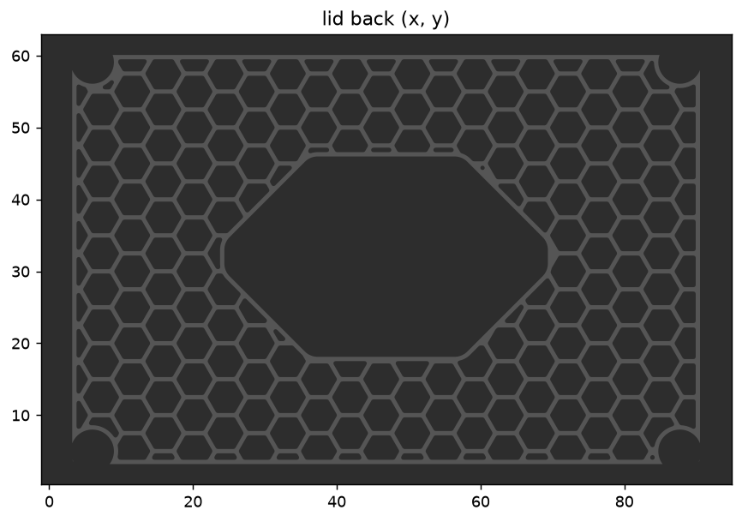
previews/marks_lid.png
