zedward856-spec/minideck/previews/marks_under.png

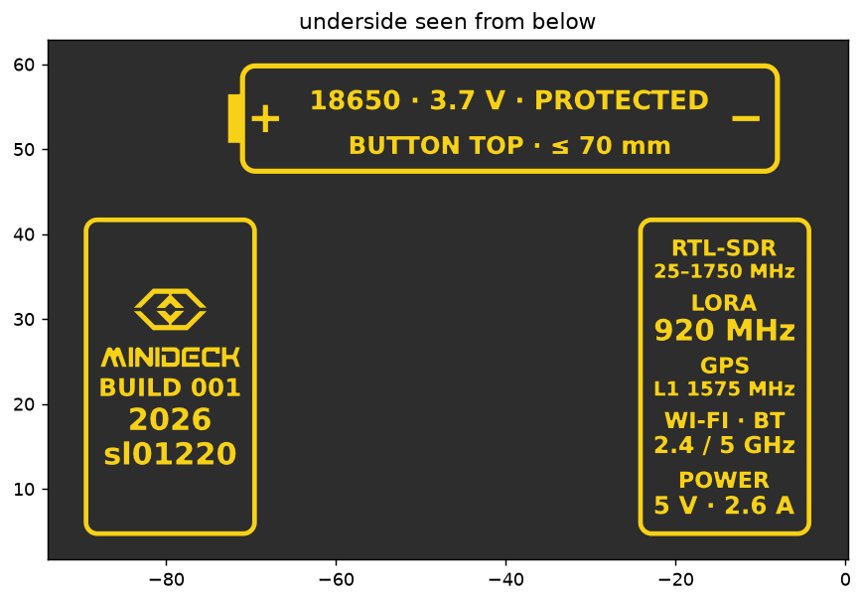
previews/marks_under.png
