zedward856-spec/minideck/previews/nfc_mark.png

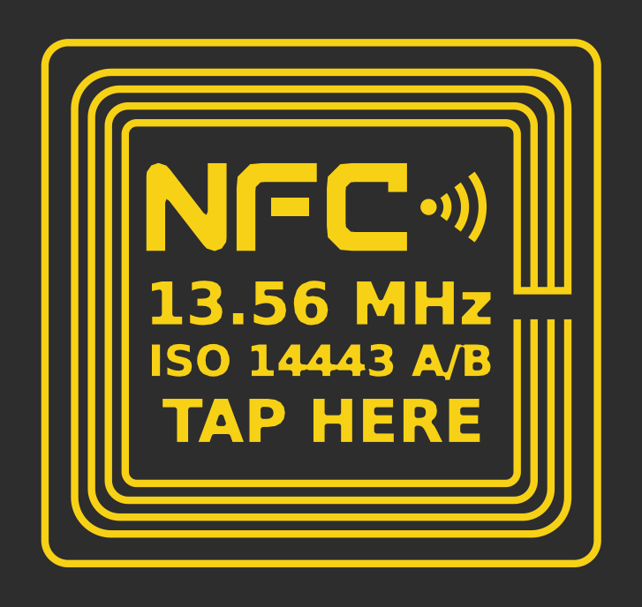
previews/nfc_mark.png
