zedward856-spec/minideck/previews/palettes.png

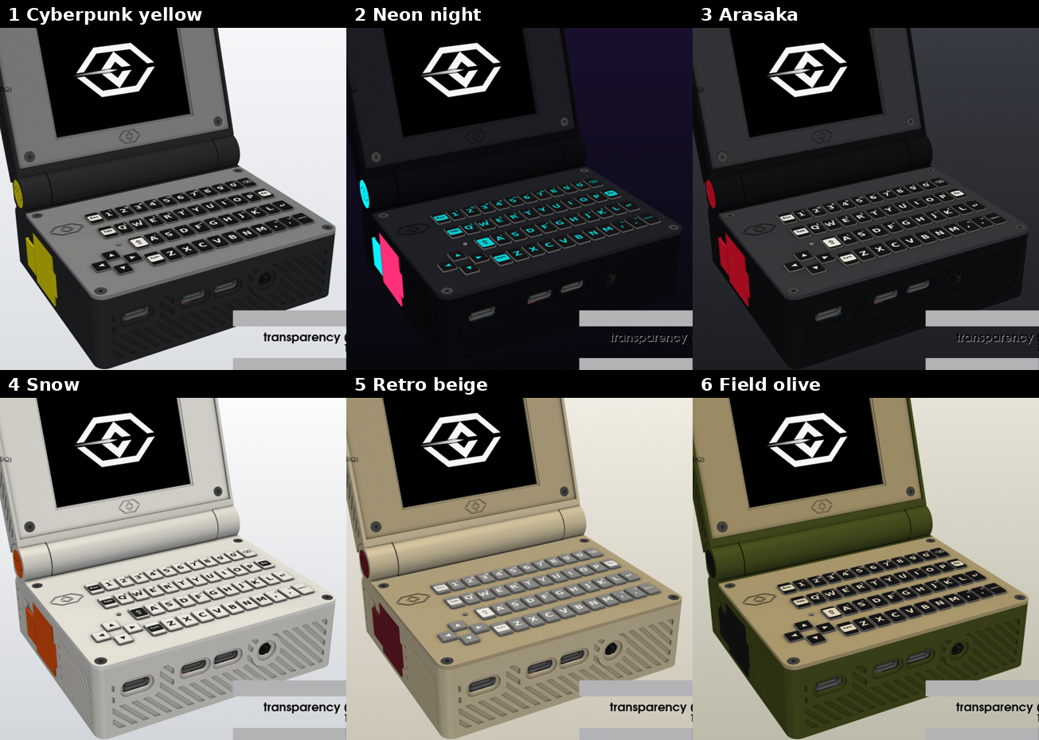
previews/palettes.png
