zedward856-spec/minideck/previews/radios_in_box.png

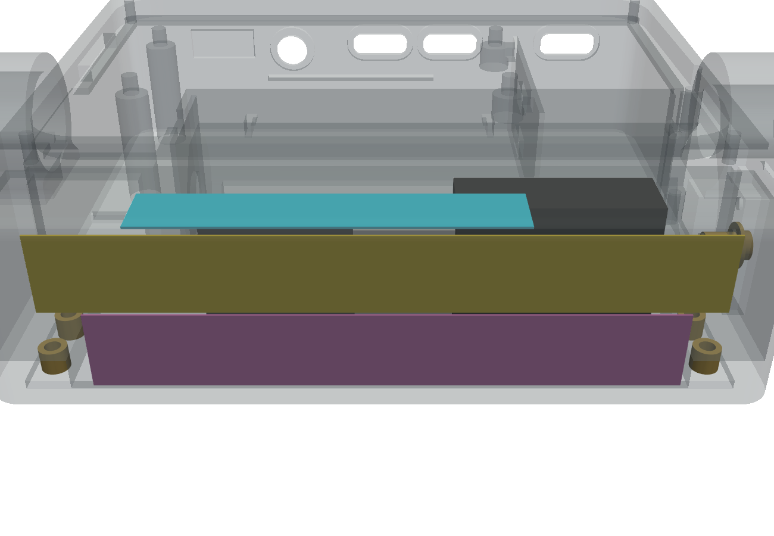
previews/radios_in_box.png
