zedward856-spec/minideck/previews/screen_bezel_screws.png

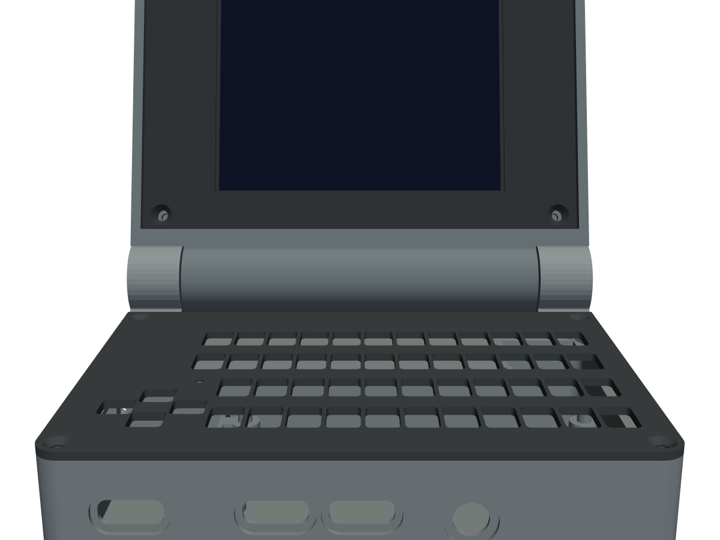
previews/screen_bezel_screws.png
