zedward856-spec/minideck/previews/stripes_back_right.png

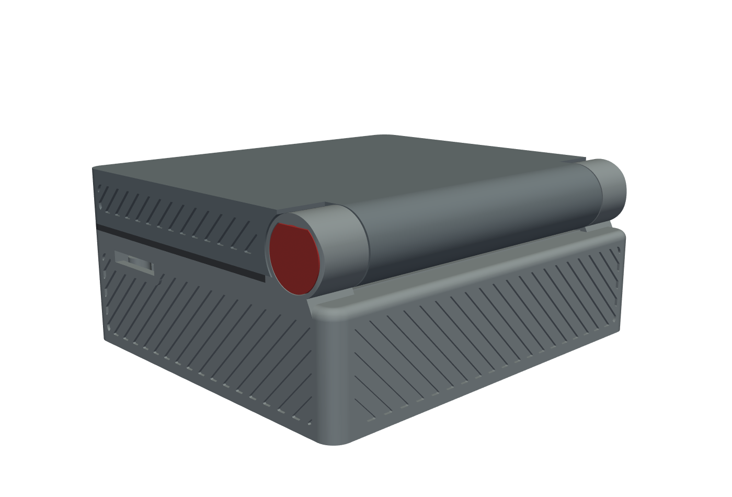
previews/stripes_back_right.png
