zedward856-spec/minideck/previews/stripes_front.png

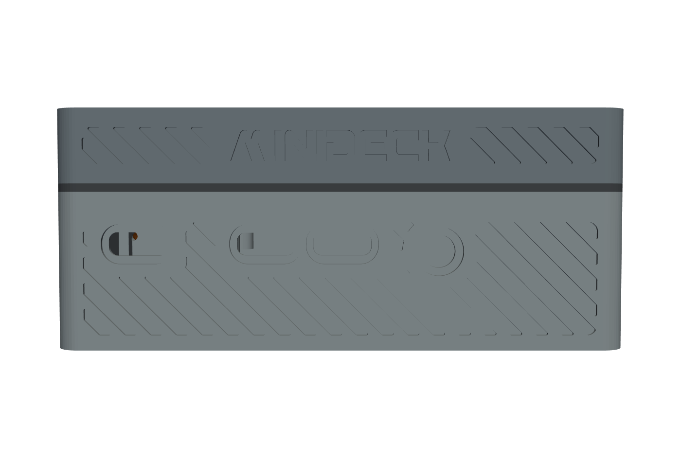
previews/stripes_front.png
