zedward856-spec/minideck/previews/stripes_front_left.png

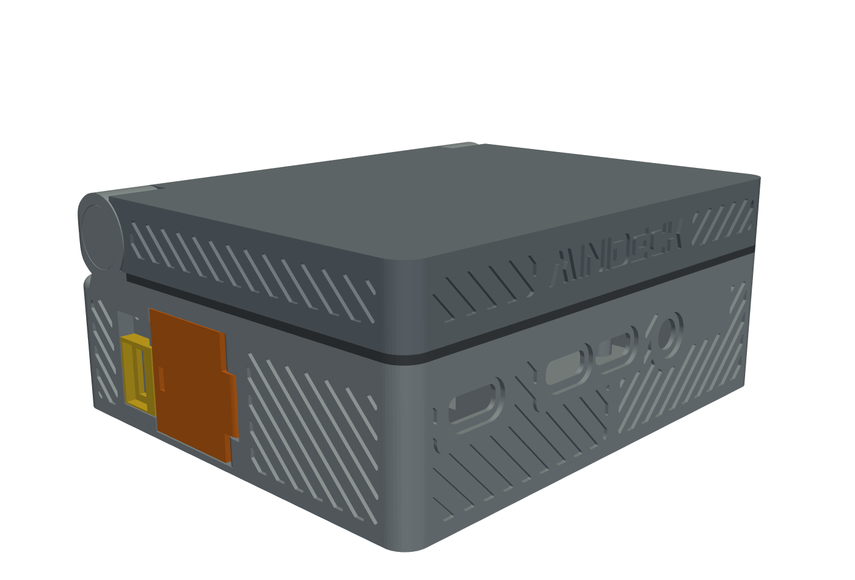
previews/stripes_front_left.png
