zedward856-spec/minideck/previews/stripes_left.png

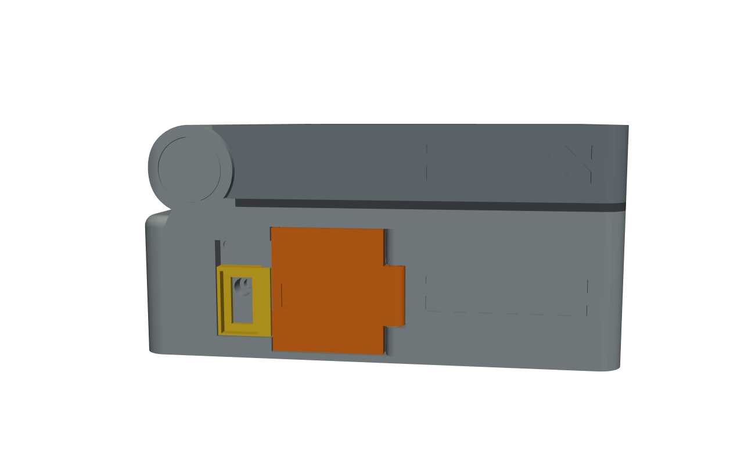
previews/stripes_left.png
