zedward856-spec/minideck/previews/stripes_right.png

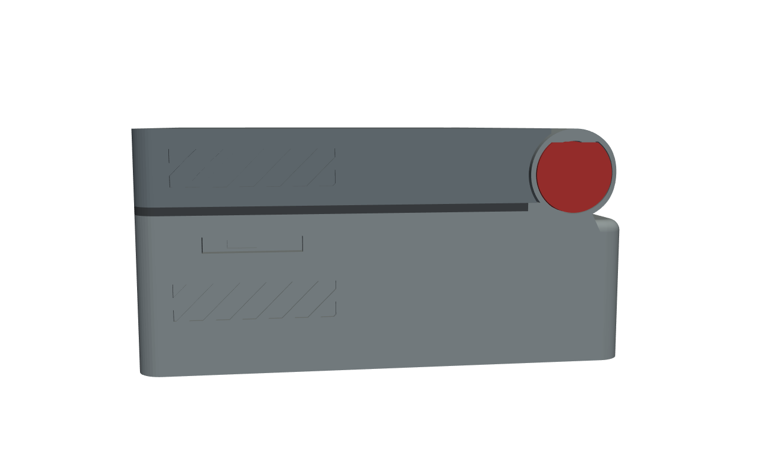
previews/stripes_right.png
