zedward856-spec/minideck/previews/thermal_best.png

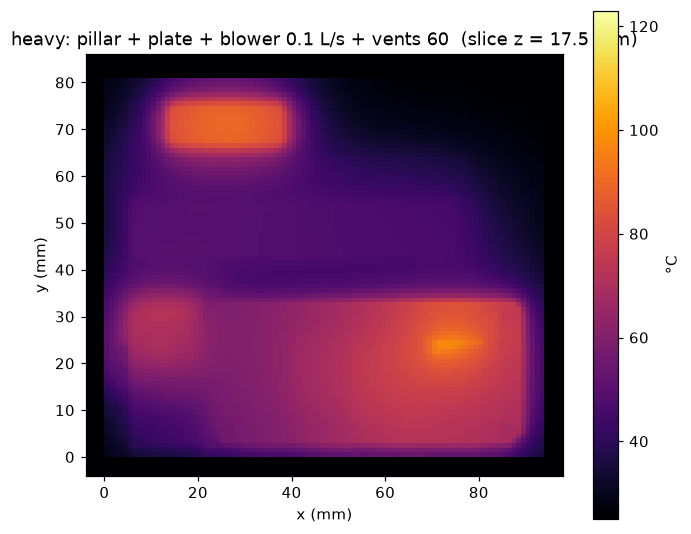
previews/thermal_best.png
