zedward856-spec/minideck/previews/thermal_current.png

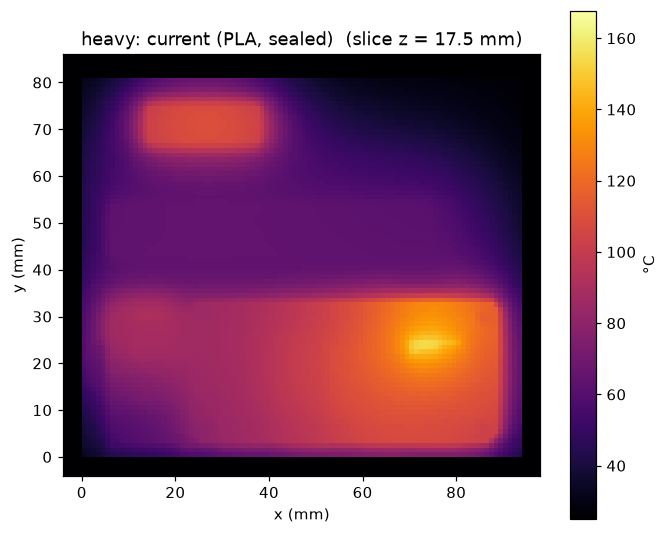
previews/thermal_current.png
