zedward856-spec/minideck/previews/yellow_options.png

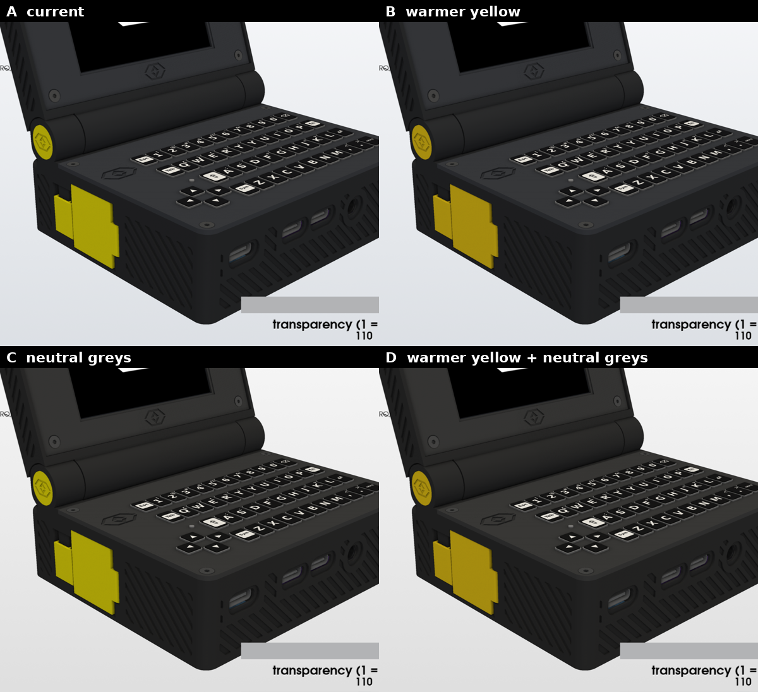
previews/yellow_options.png
