zedward856-spec/minideck/previews/your_screenshot_grid.png

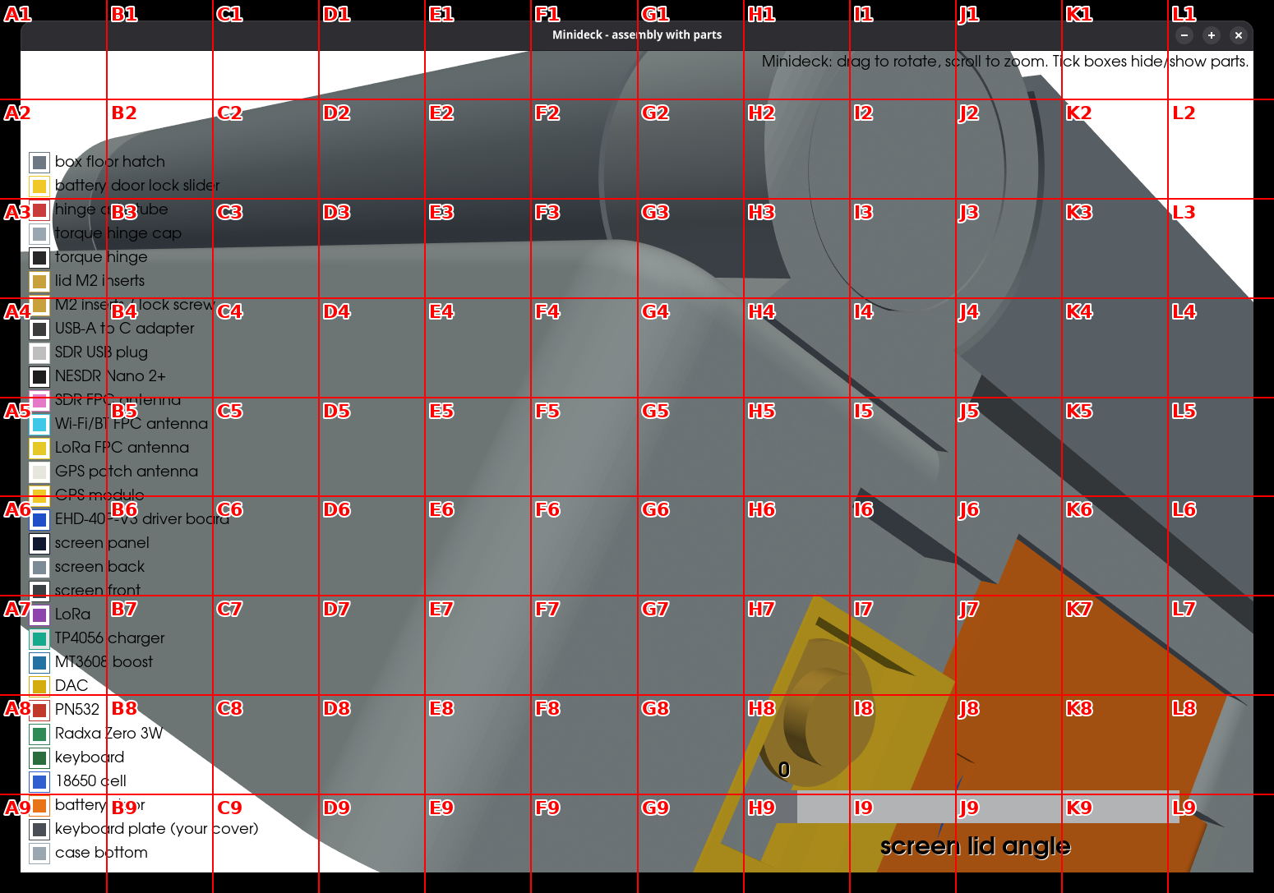
previews/your_screenshot_grid.png
