zedward856-spec/minideck/site/assets/legends.png

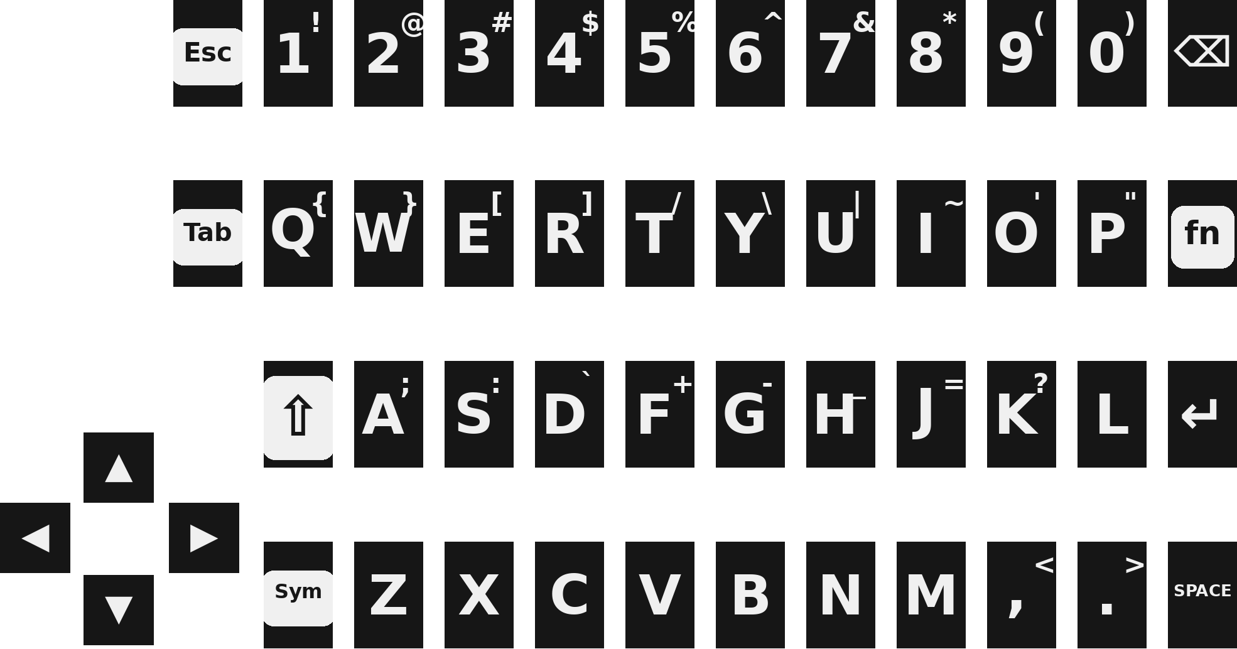
site/assets/legends.png
