zedward856-spec/minideck/site/assets/og.png

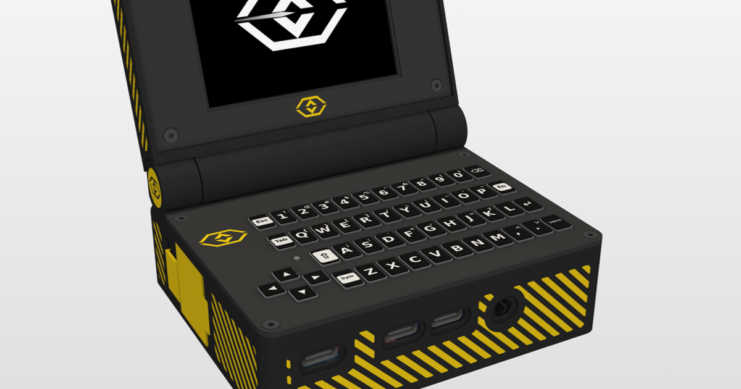
site/assets/og.png
