zedward856-spec/minideck/out/assembly_with_parts.3mf

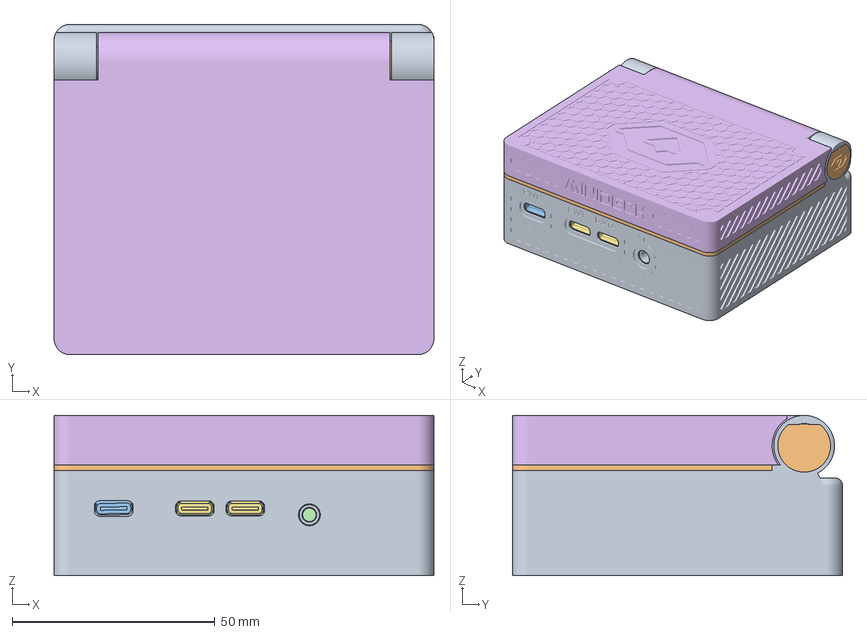
[picture p68: CAD file, 2026-10-05]
out/assembly_with_parts.3mf
93.7 x 81.5 x 39.5 mm
bottom
keyboard_top
battery_door
gps_module
keyboard
radxa
pn532
dac
mt3608
tp4056
lora
screen_front
screen_back
screen_panel
driver_board
gps_patch_antenna
m2_hardware
antenna_lora
antenna_sdr
antenna_wifi
sdr_dongle
lid_inserts
torque_hinge
hinge_cap
hinge_axle
box_hatch
door_lock
