zedward856-spec/minideck/out/lid_assembly.step

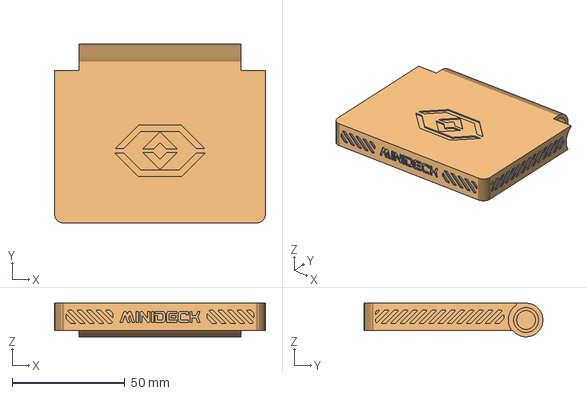
[picture p69: CAD file, 2026-10-04]
out/lid_assembly.step
93.7 x 79.5 x 15.0 mm
