zedward856-spec/minideck/out/battery_test_assembly.step

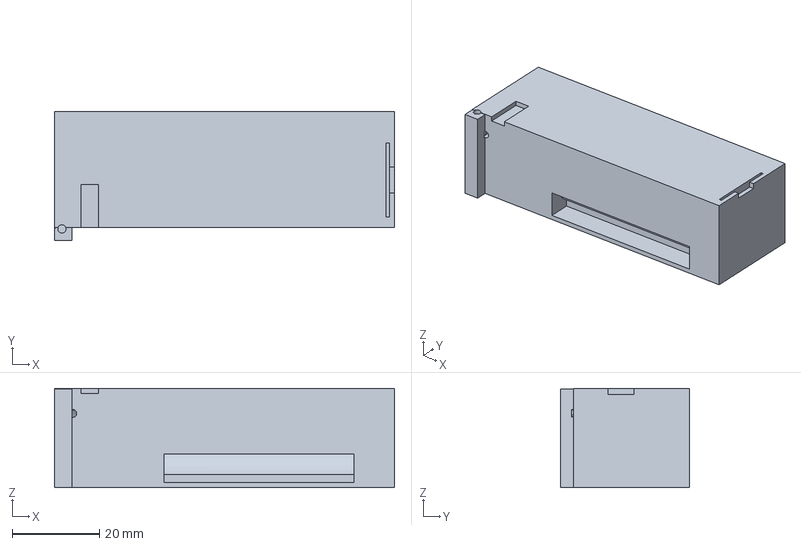
[picture p70: CAD file, 2026-10-04]
out/battery_test_assembly.step
77.9 x 29.6 x 22.7 mm
