zedward856-spec/minideck/models/components/ebyte_e22_900t22s/E22-xxxT22S(3D).step

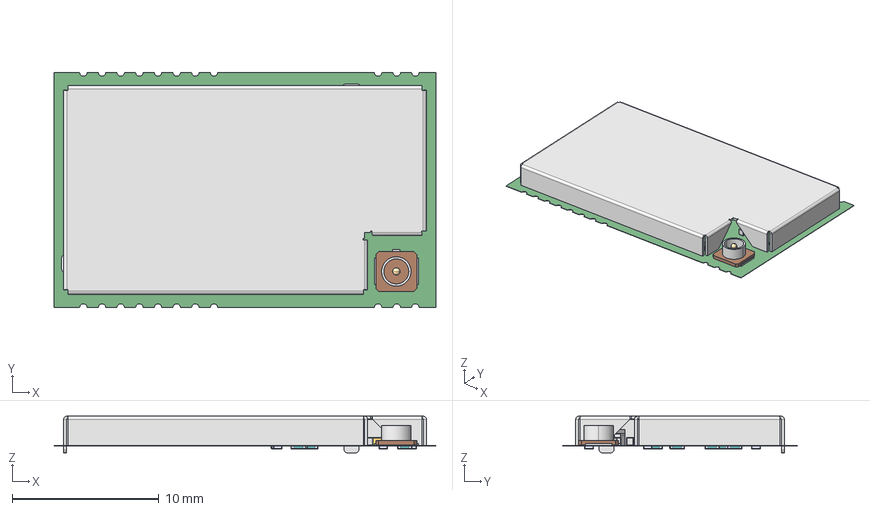
[picture p71: CAD file, 2026-10-03]
models/components/ebyte_e22_900t22s/E22-xxxT22S(3D).step
26.0 x 16.0 x 2.50 mm
Board
CAPC1005X56N_EIA_0402 x 35
User_Library-RESC0603X___ x 7
R0402 x 7
User_Library-SOT23-5_SOT23-5_Connector_Default x 10
User_Library-SOT23-5_SOT23-5_Body_Default x 2
User_Library-GeyerElectronics_KX7
User_Library-Chip_InductorINDC1005X60N x 8
INDC2012X105N_EIA_0805
CAPC1608X92N_EIA_0603 x 2
ANT-IPEX-1
PBZ-43
