zedward856-spec/minideck/models/components/gps_patch_antenna_18x18/DSGP184B_Web.STEP

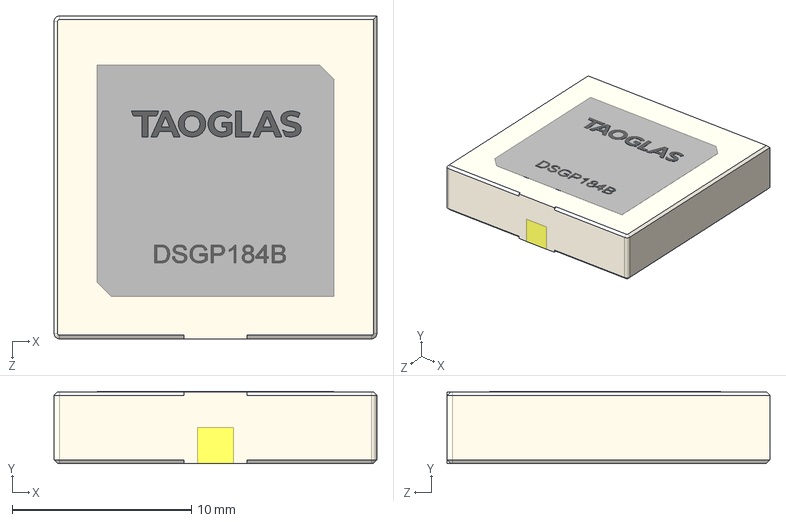
[picture p72: CAD file, 2026-10-03]
models/components/gps_patch_antenna_18x18/DSGP184B_Web.STEP
18.0 x 4.04 x 18.0 mm
