zedward856-spec/minideck/models/components/heatset_insert_m2/cnckitchen_M2_Short.step

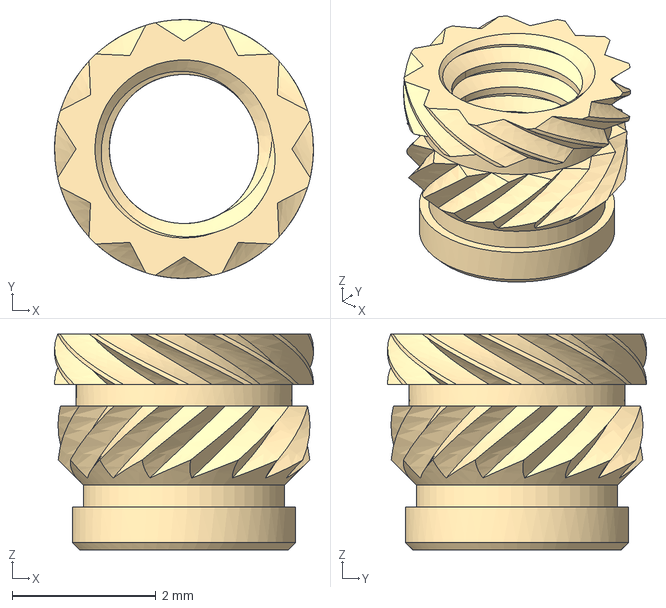
[picture p73: CAD file, 2026-10-03]
models/components/heatset_insert_m2/cnckitchen_M2_Short.step
3.60 x 3.60 x 3.00 mm
