zedward856-spec/minideck/models/components/lcd_2p8_hdmi/eg_TFT_2.8_240x320_MIT.step

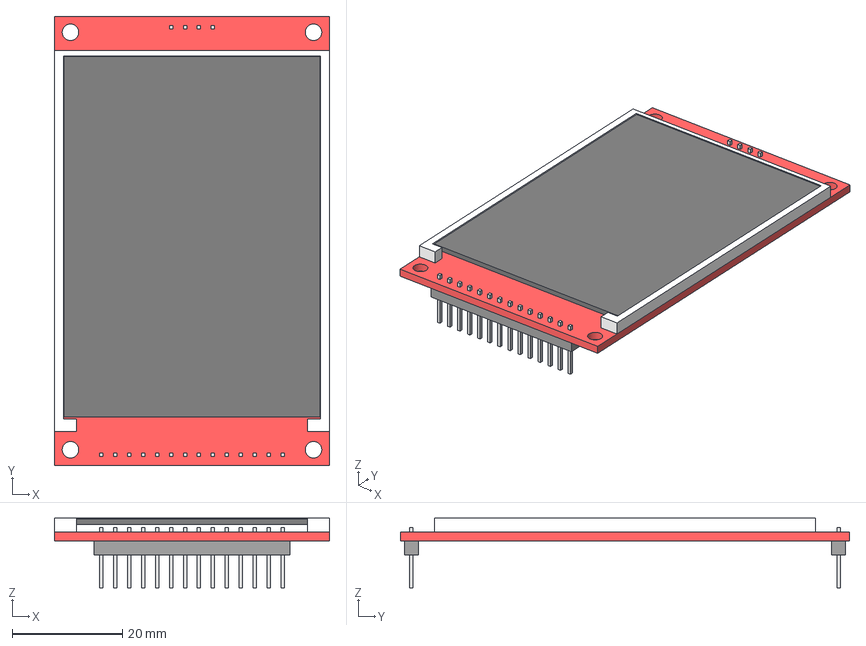
[picture p74: CAD file, 2026-10-03]
models/components/lcd_2p8_hdmi/eg_TFT_2.8_240x320_MIT.step
50.0 x 81.7 x 12.7 mm
LCD
PCB
Pins Top
Pins Bottom
Frame
