zedward856-spec/minideck/models/components/m5stack_cardkb/printables_793686_cardkb.step

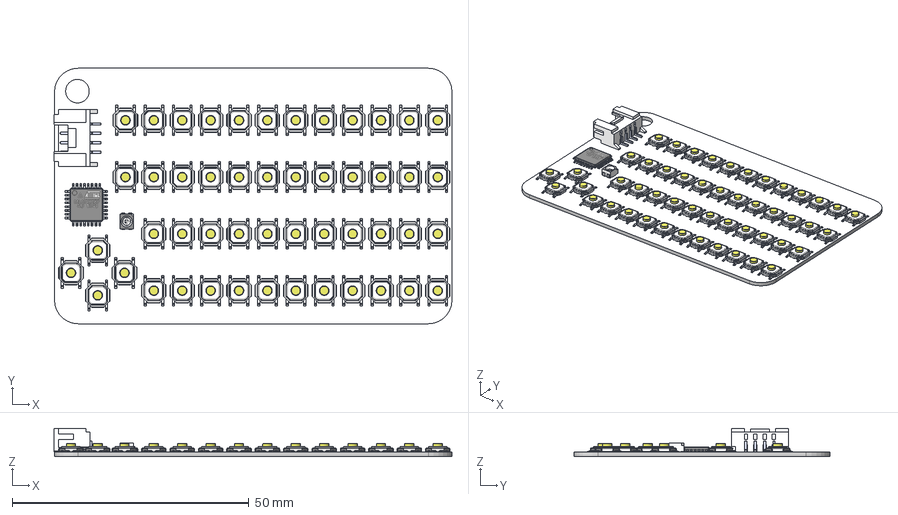
[picture p75: CAD file, 2026-10-03]
models/components/m5stack_cardkb/printables_793686_cardkb.step
84.1 x 54.0 x 6.00 mm
ATmega_AP214
LED-3528-rgb
Grove Connector (flat)
smd-button-1-8mm-height v1 (4) x 46
smd-button-1-8mm-height v1
smd-button-1-8mm-height v1 (1)
smd-button-1-8mm-height v1 (2)
smd-button-1-8mm-height v1 (3)
PCB
