zedward856-spec/minideck/models/components/mt3608_boost/mt3608_WillyCcV19_NO-LICENCE_reference-only.step

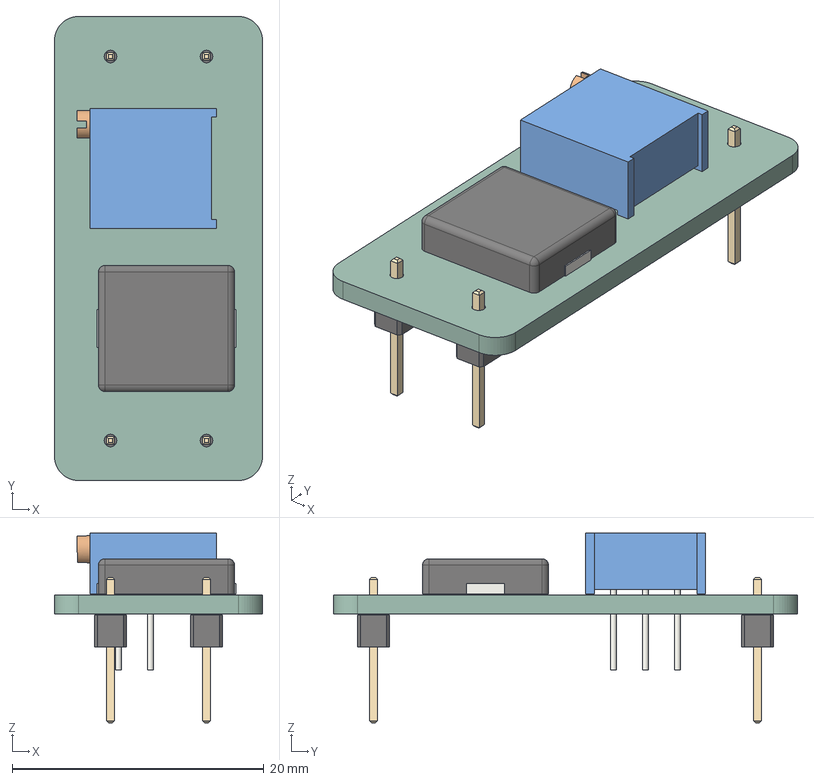
[picture p76: CAD file, 2026-10-03]
models/components/mt3608_boost/mt3608_WillyCcV19_NO-LICENCE_reference-only.step
16.5 x 36.8 x 15.1 mm
Potentiometer_Bourns_3296P_Horizontal
L_APV_APH1030
PinHeader_1x01_P254mm_Vertical x 4
MT3608_PCB
