zedward856-spec/minideck/models/components/pcm5102a/printables_1765314_pcm5102a.stl

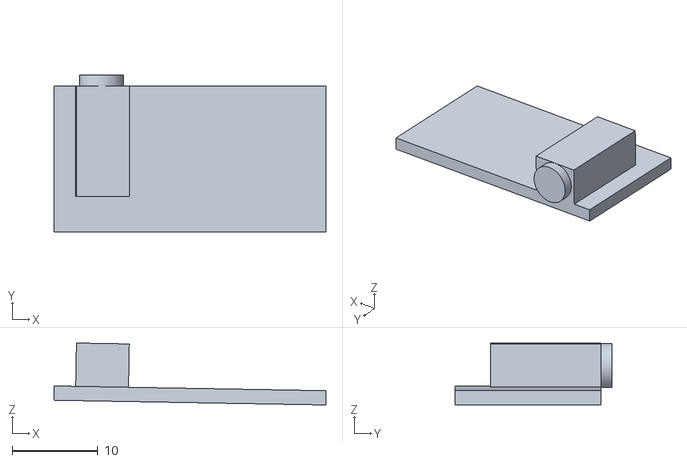
[picture p77: CAD file, 2026-10-03]
models/components/pcm5102a/printables_1765314_pcm5102a.stl
31.8 x 18.4 x 7.24
