zedward856-spec/minideck/models/components/pn532_elechouse/3D_NFC_EASY_SHIELD_V4.1_2025-12-13.step

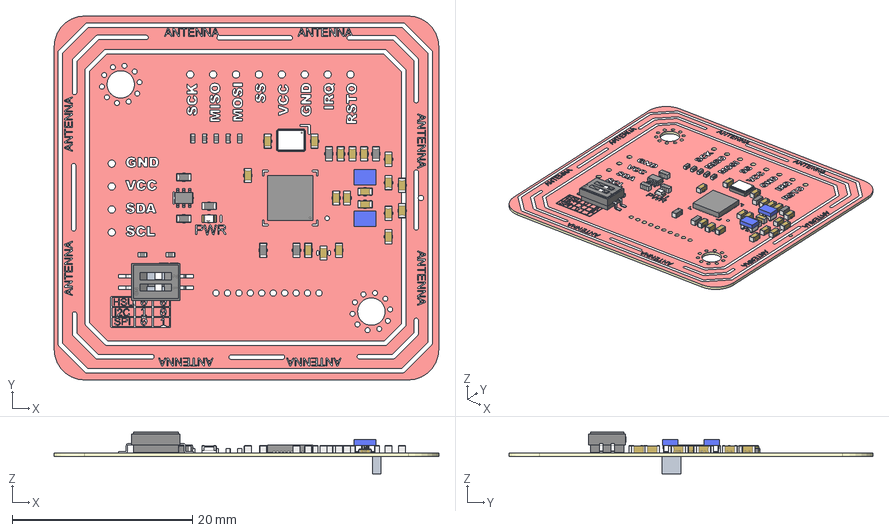
[picture p78: CAD file, 2026-10-03]
models/components/pn532_elechouse/3D_NFC_EASY_SHIELD_V4.1_2025-12-13.step
42.7 x 40.4 x 4.61 mm
Board~KiIk
TopCopper~KiIk
BottomCopper~KiIk
TopSilkscreen~KiIk
BottomSilkscreen~KiIk
TopFpcStiffener~KiIk
BottomFpcStiffener~KiIk
CE认证~default_model~KiIk
焊接跳线2~default_model~KiIk x 2
