zedward856-spec/minideck/models/components/tp4056_usbc/tp4056_usbc_printables415657_CC0.stl

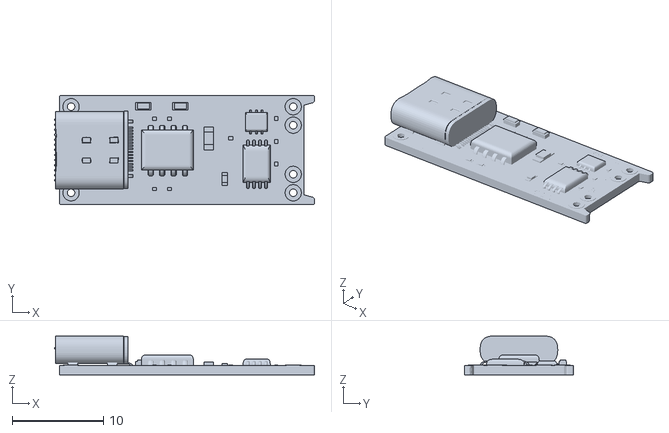
[picture p79: CAD file, 2026-10-03]
models/components/tp4056_usbc/tp4056_usbc_printables415657_CC0.stl
28.5 x 12.0 x 4.28
