zedward856-spec/minideck/models/radxa_zero3w_official_placed.stl

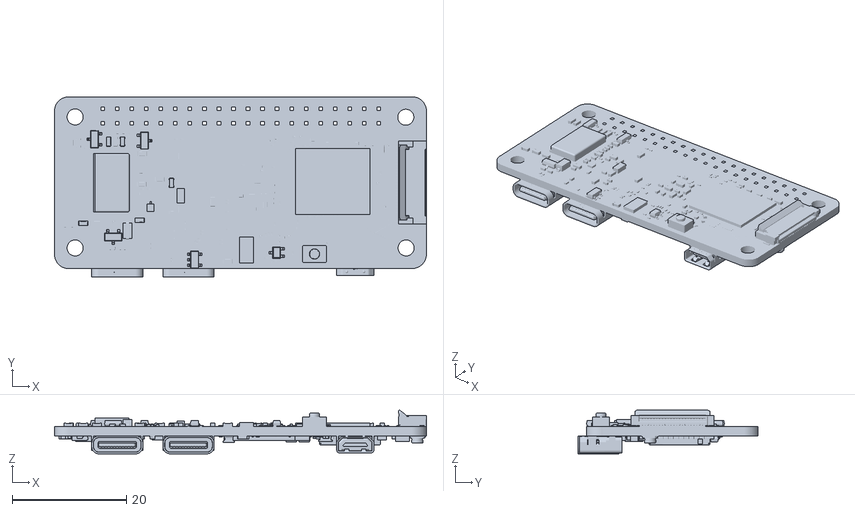
[picture p80: CAD file, 2026-10-03]
models/radxa_zero3w_official_placed.stl
65.0 x 31.5 x 7.64
