zedward856-spec/minideck/out/box_hatch.stl

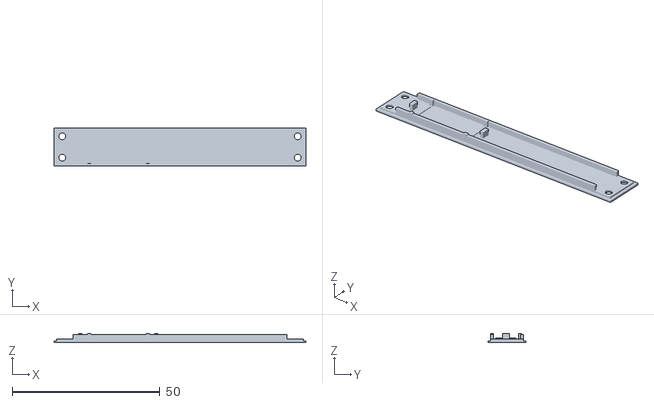
[picture p81: CAD file, 2026-10-05]
out/box_hatch.stl
85.3 x 12.8 x 3.20
