zedward856-spec/minideck/out/parts_in_place/power_switch.stl

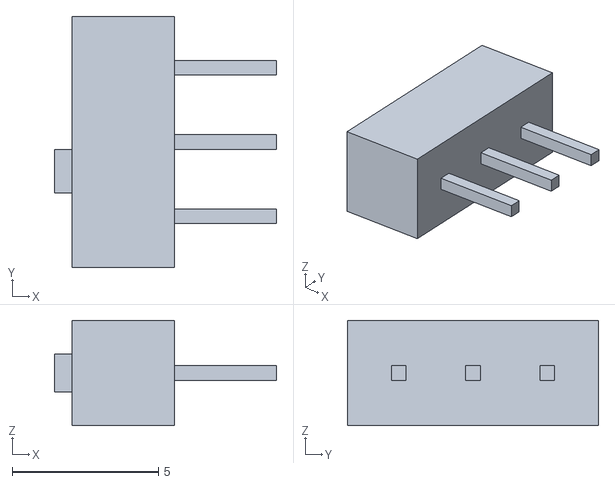
[picture p82: CAD file, 2026-10-05]
out/parts_in_place/power_switch.stl
7.60 x 8.60 x 3.60
