zedward856-spec/minideck/print/dark-grey/keyboard_plate.stl

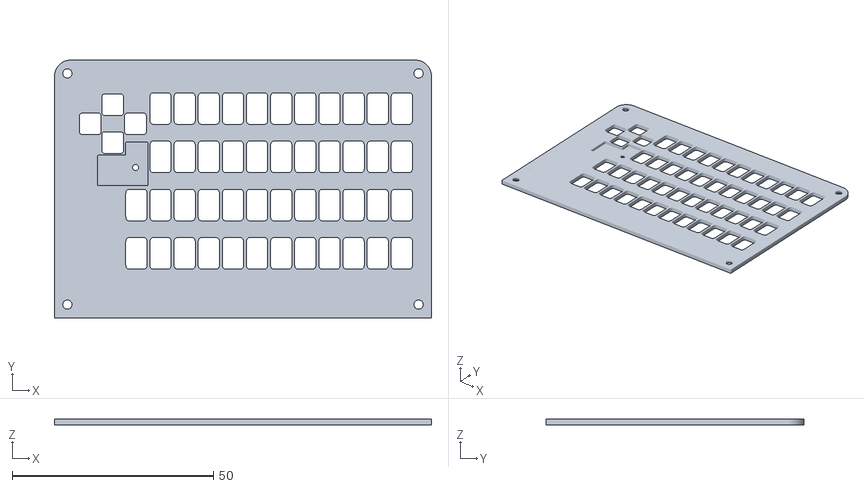
[picture p83: CAD file, 2026-10-04]
print/dark-grey/keyboard_plate.stl
93.7 x 64.1 x 1.38
