zedward856-spec/minideck/print/tests/battery_door_fit_test.stl

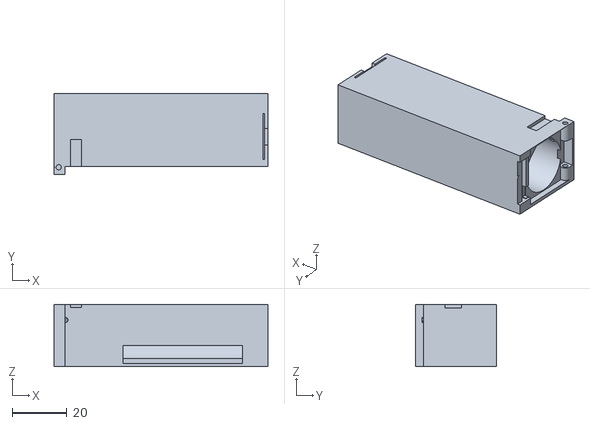
[picture p84: CAD file, 2026-10-04]
print/tests/battery_door_fit_test.stl
77.9 x 29.6 x 22.7
