zedward856-spec/minideck/print/yellow/switch_knob.stl

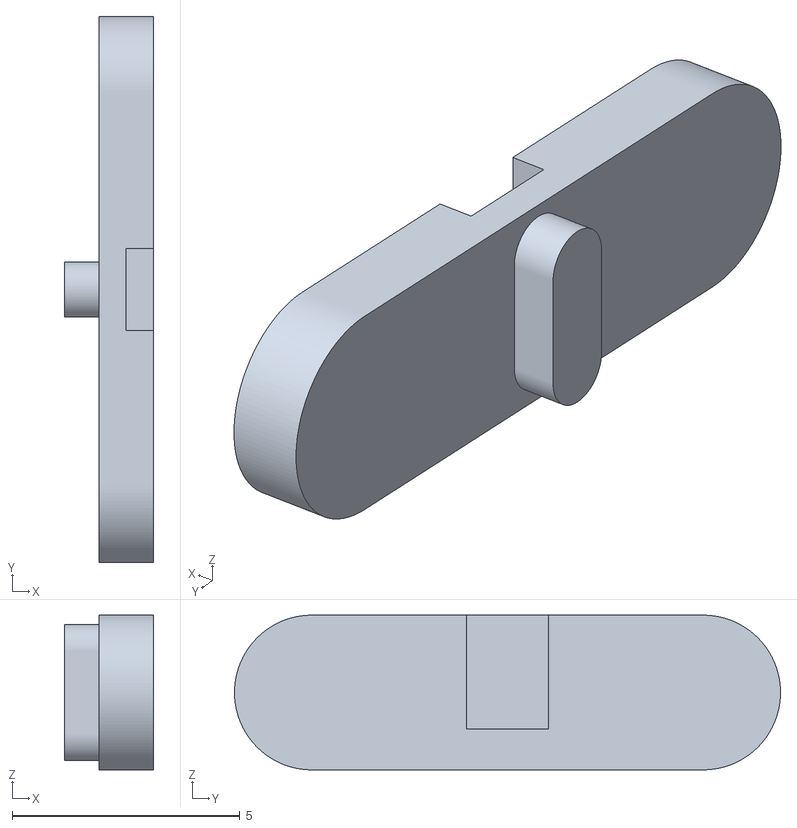
[picture p85: CAD file, 2026-10-05]
print/yellow/switch_knob.stl
1.95 x 12.0 x 3.40
