zedward856-spec/minideck/models/components/lcd_2p8_hdmi/waveshare_2.8inch_HDMI_LCD_H.stp

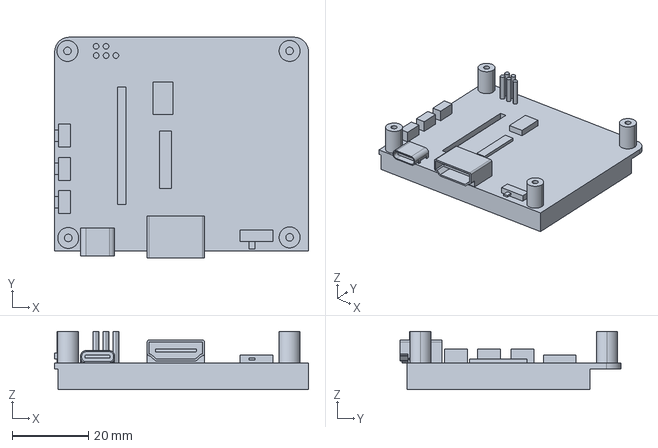
[picture p86: CAD file, 2026-10-03]
models/components/lcd_2p8_hdmi/waveshare_2.8inch_HDMI_LCD_H.stp
66.5 x 57.8 x 15.2 mm
