zedward856-spec/minideck/models/components/tp4056_usbc/tp4056_usbc_printables553096_CC-BY-SA.stl

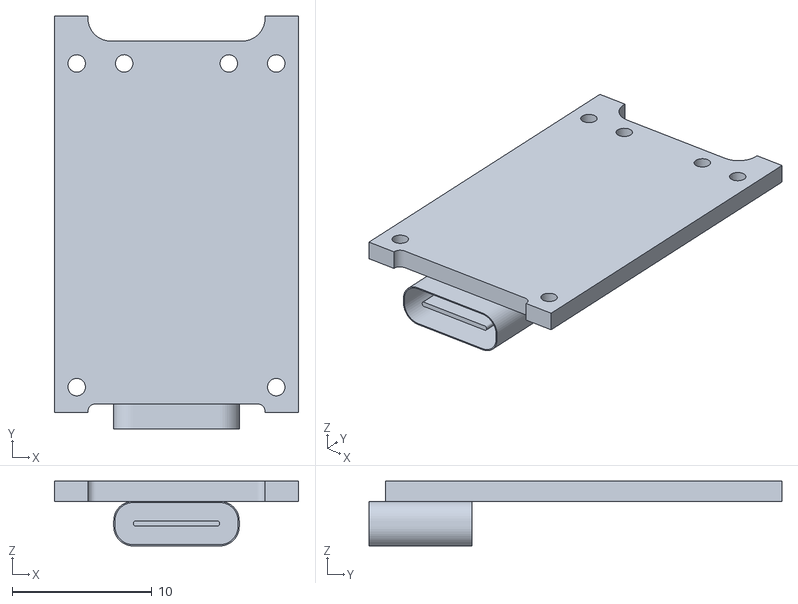
[picture p87: CAD file, 2026-10-03]
models/components/tp4056_usbc/tp4056_usbc_printables553096_CC-BY-SA.stl
17.5 x 29.6 x 4.65
