zedward856-spec/minideck/models/Keyboard Cover.stl

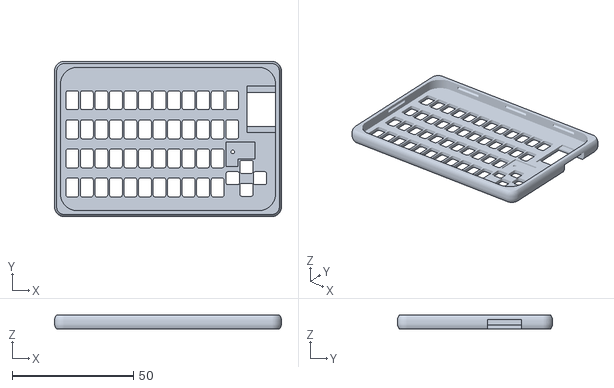
[picture p88: CAD file, 2026-10-03]
models/Keyboard Cover.stl
93.7 x 64.1 x 5.99
