zedward856-spec/minideck/out/parts_in_place/fill_marks_base.stl

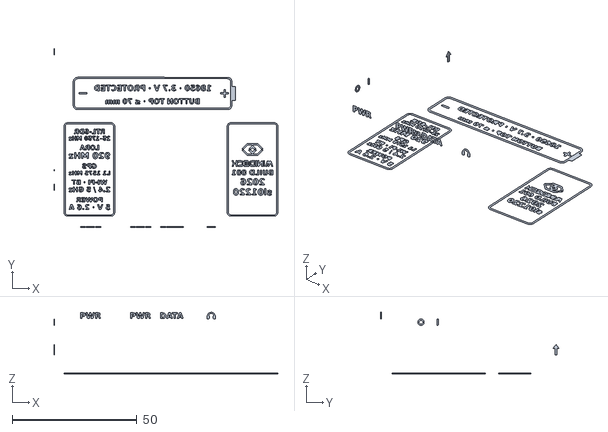
[picture p89: CAD file, 2026-10-05]
out/parts_in_place/fill_marks_base.stl
89.7 x 71.5 x 24.7
