zedward856-spec/minideck/print/charcoal/case_bottom.stl

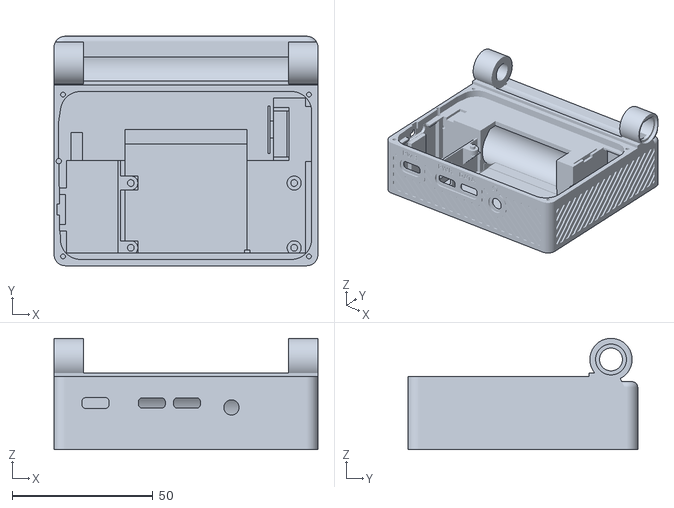
[picture p90: CAD file, 2026-10-05]
print/charcoal/case_bottom.stl
93.7 x 81.5 x 39.5
