zedward856-spec/minideck/print/dark-grey/screen_bezel.stl

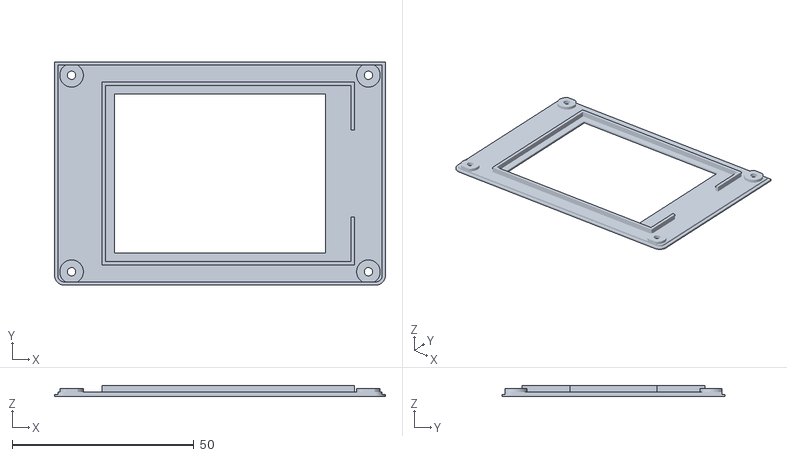
[picture p91: CAD file, 2026-10-04]
print/dark-grey/screen_bezel.stl
91.1 x 61.5 x 3.00
