zedward856-spec/minideck/print/yellow/hinge_axle.stl

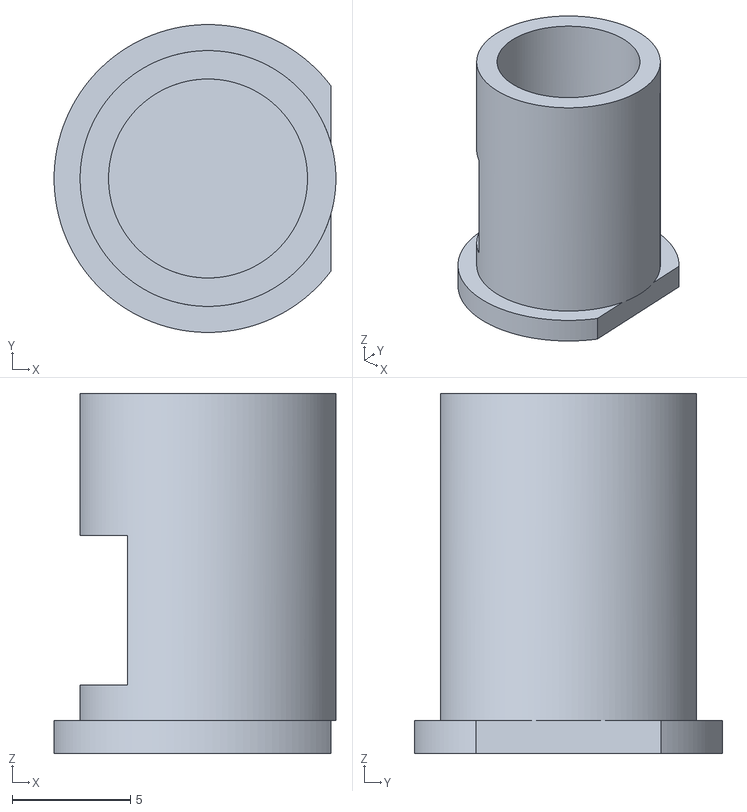
[picture p92: CAD file, 2026-10-04]
print/yellow/hinge_axle.stl
11.9 x 13.0 x 15.2
