zedward856-spec/minideck/models/components/m5stack_cardkb/printables_789261_cardkb.stl

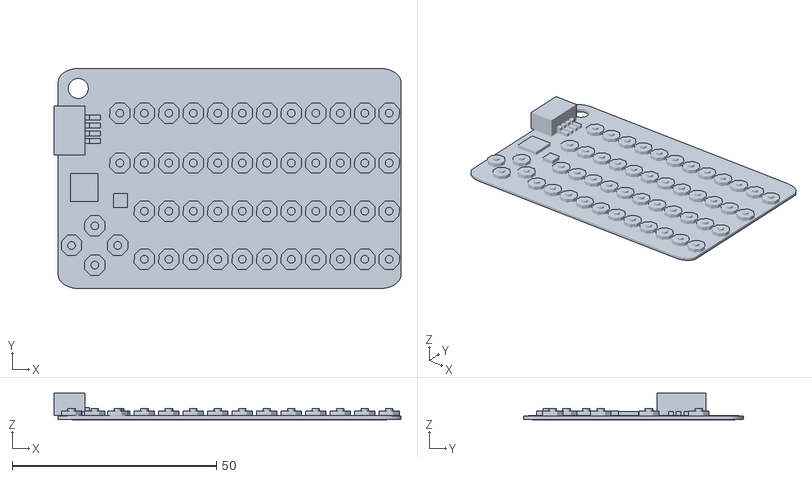
[picture p93: CAD file, 2026-10-03]
models/components/m5stack_cardkb/printables_789261_cardkb.stl
85.0 x 54.0 x 6.50
