zedward856-spec/minideck/models/minideck.stl

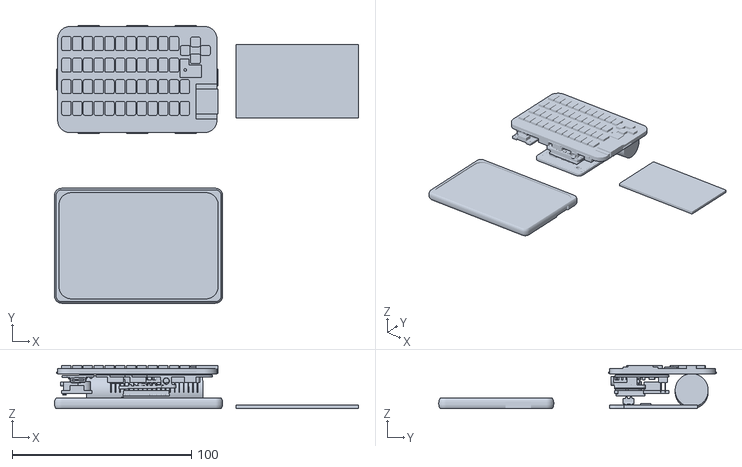
[picture p94: CAD file, 2026-10-03]
models/minideck.stl
169.5 x 154.7 x 24.2
