zedward856-spec/minideck/print/charcoal/lid_shell.stl

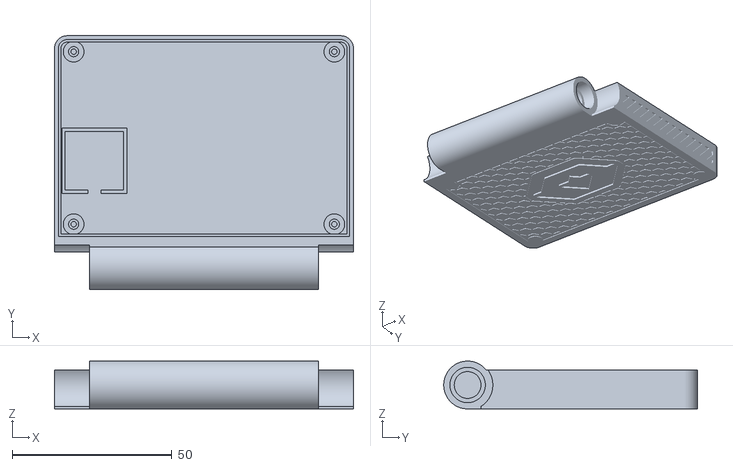
[picture p95: CAD file, 2026-10-04]
print/charcoal/lid_shell.stl
93.7 x 79.5 x 15.0
