zedward856-spec/minideck/print/yellow/torque_hinge_cap.stl

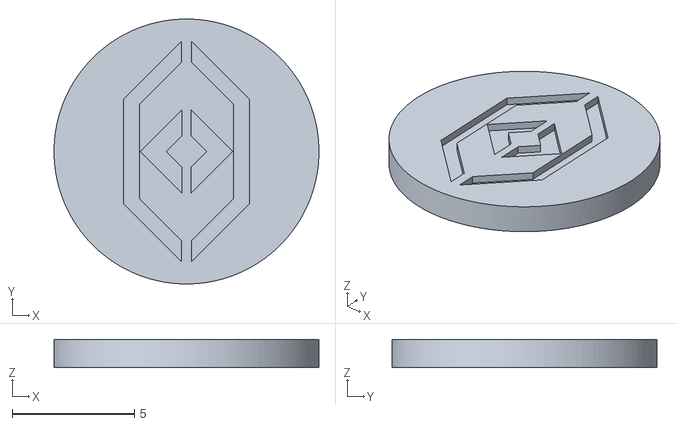
[picture p96: CAD file, 2026-10-04]
print/yellow/torque_hinge_cap.stl
10.9 x 10.8 x 1.15
