zedward856-spec/minideck/models/keyboard.stl

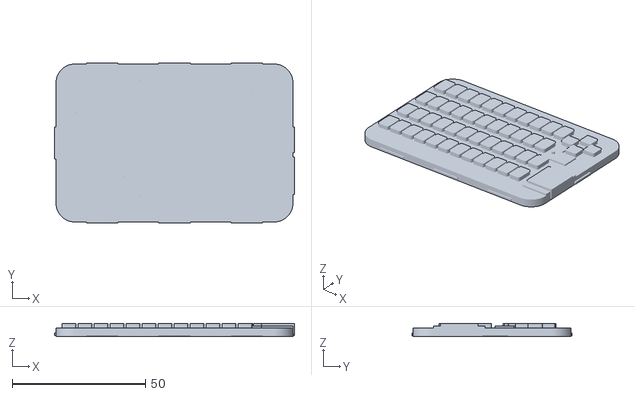
[picture p97: CAD file, 2026-10-03]
models/keyboard.stl
90.0 x 60.0 x 5.00
