zedward856-spec/minideck/print/yellow/battery_lock_clip.stl

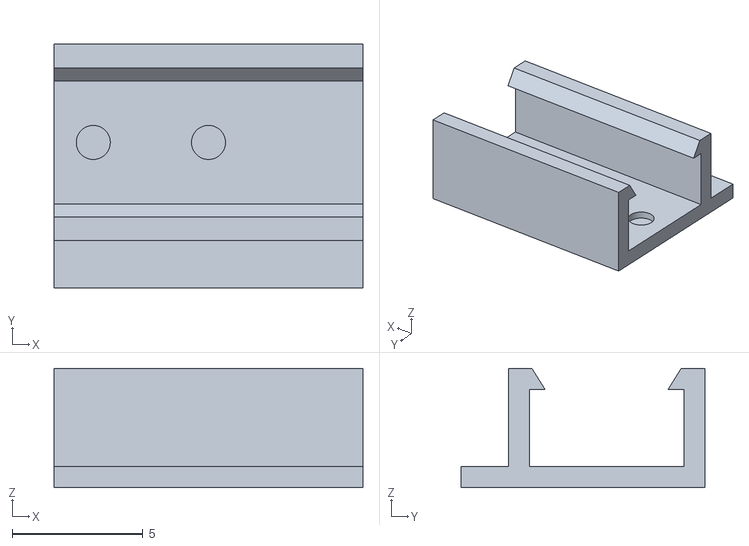
[picture p98: CAD file, 2026-10-03]
print/yellow/battery_lock_clip.stl
11.8 x 9.30 x 4.55
