zedward856-spec/minideck/print/yellow/battery_door.stl

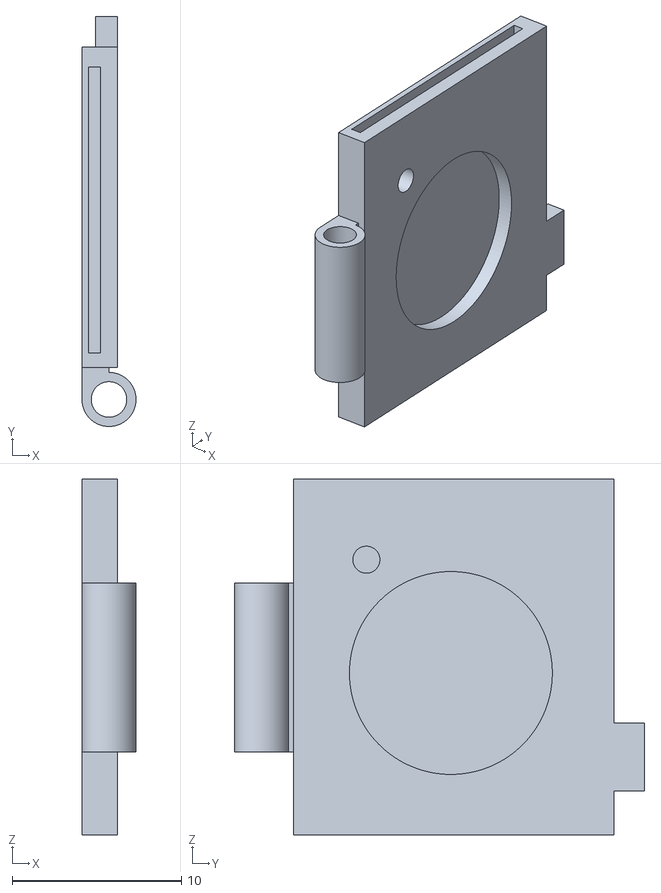
[picture p99: CAD file, 2026-10-03]
print/yellow/battery_door.stl
3.20 x 24.2 x 21.0
