zedward856-spec/minideck/out/parts_in_place/wires_base_i2s.stl

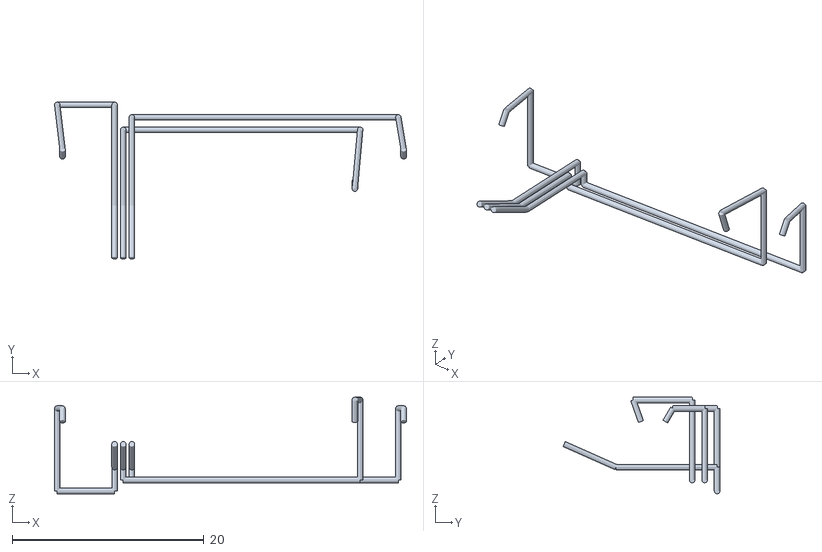
[picture p100: CAD file, 2026-10-05]
out/parts_in_place/wires_base_i2s.stl
36.7 x 16.4 x 10.1
