zedward856-spec/minideck/out/parts_in_place/fill_stripes_base.stl

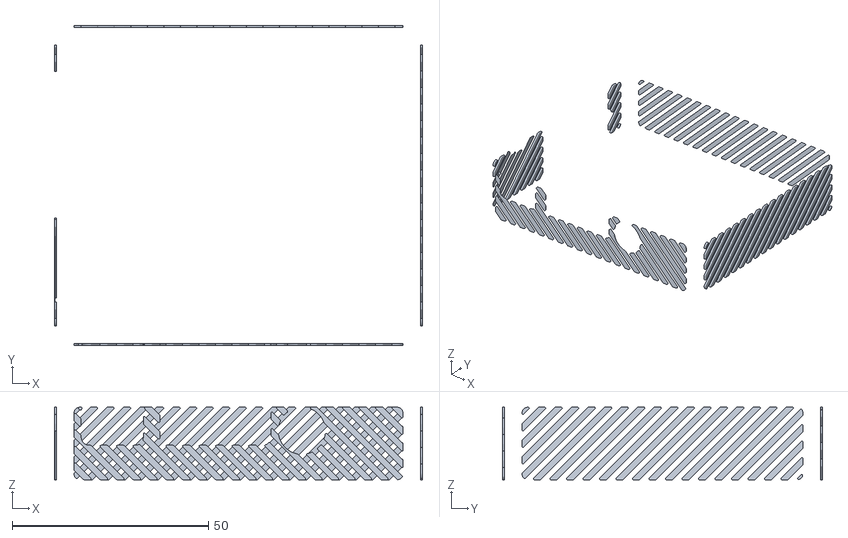
[picture p101: CAD file, 2026-10-05]
out/parts_in_place/fill_stripes_base.stl
93.7 x 81.4 x 18.5
