zedward856-spec/minideck/out/parts_in_place/wires_base_pwr.stl

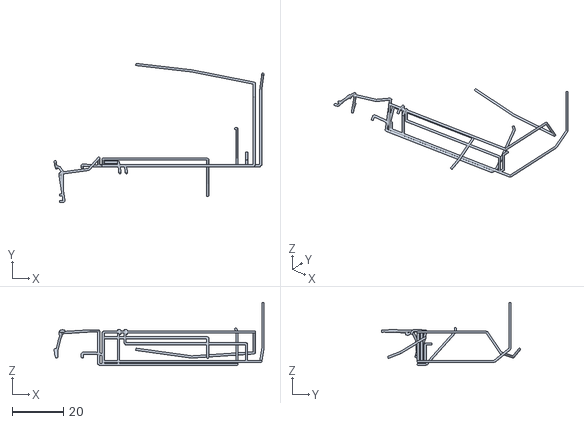
[picture p102: CAD file, 2026-10-05]
out/parts_in_place/wires_base_pwr.stl
81.7 x 54.2 x 24.6
