zedward856-spec/minideck/out/parts_in_place/wires_base_uart.stl

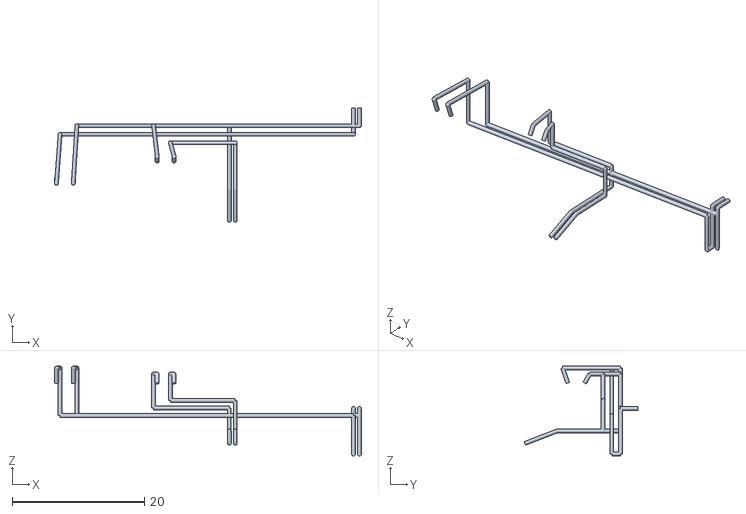
[picture p103: CAD file, 2026-10-05]
out/parts_in_place/wires_base_uart.stl
46.4 x 17.2 x 13.6
