zedward856-spec/minideck/out/parts_in_place/wires_base_gpio.stl

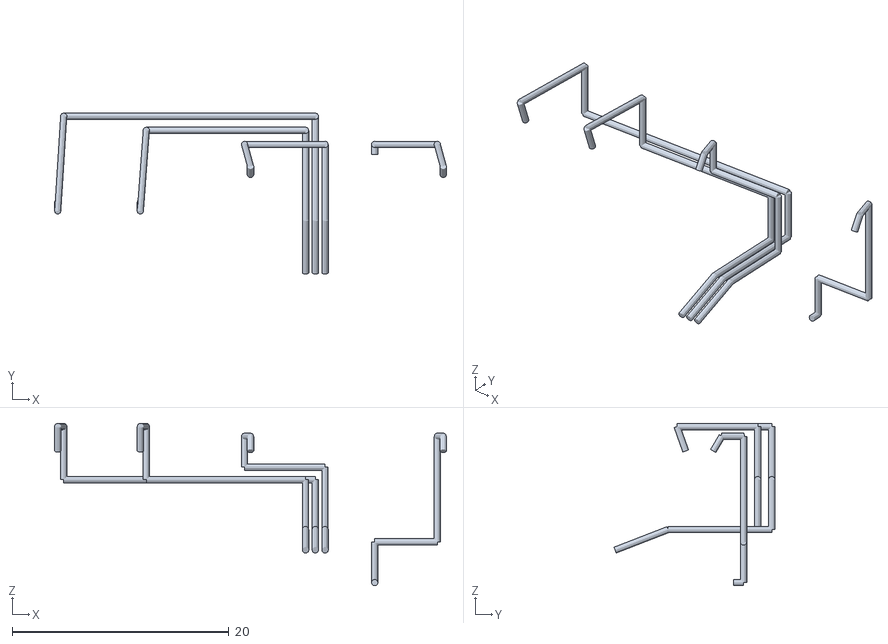
[picture p104: CAD file, 2026-10-05]
out/parts_in_place/wires_base_gpio.stl
36.2 x 14.9 x 15.0
