zedward856-spec/minideck/out/parts_in_place/wires_base_usb.stl

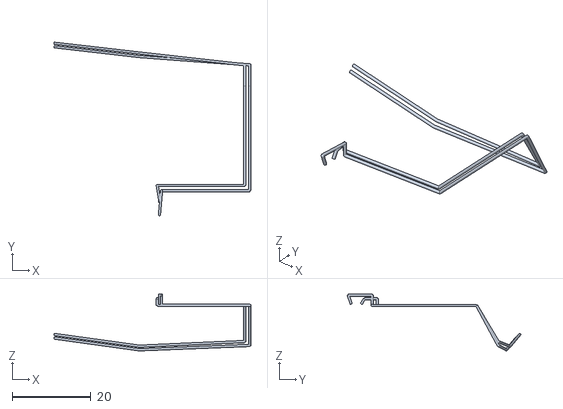
[picture p105: CAD file, 2026-10-05]
out/parts_in_place/wires_base_usb.stl
50.2 x 44.2 x 14.5
