zedward856-spec/minideck/out/parts_in_place/wires_base_v33.stl

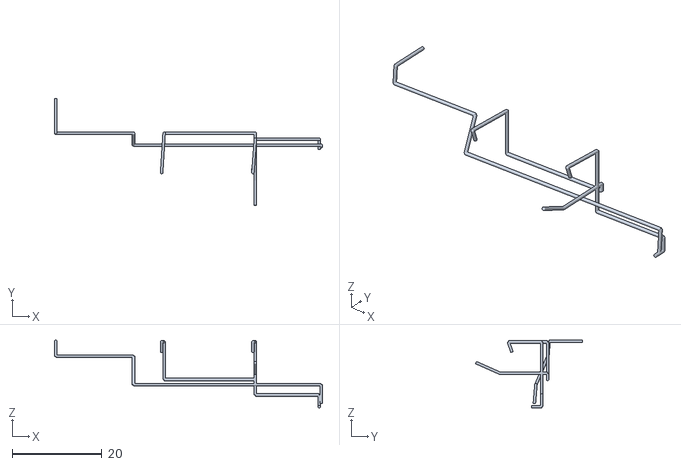
[picture p106: CAD file, 2026-10-05]
out/parts_in_place/wires_base_v33.stl
59.7 x 23.8 x 15.1
