zedward856-spec/minideck/out/parts_in_place/wires_base_coax.stl

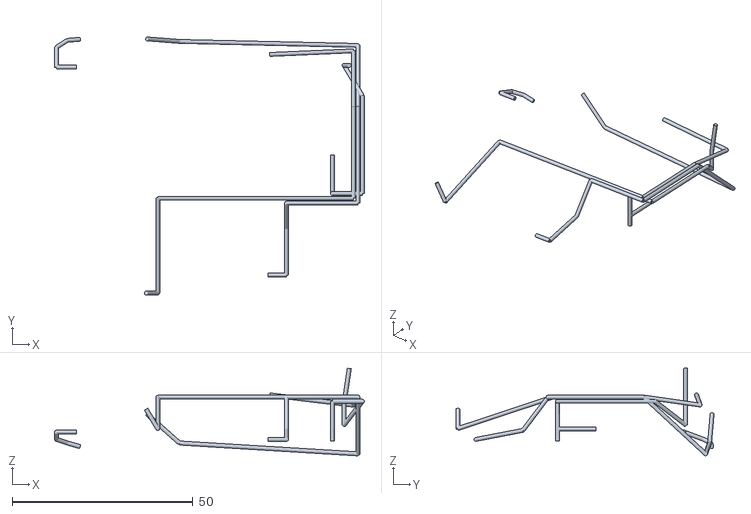
[picture p107: CAD file, 2026-10-05]
out/parts_in_place/wires_base_coax.stl
85.7 x 71.4 x 24.3
