zedward856-spec/minideck/out/sd_guide.stl

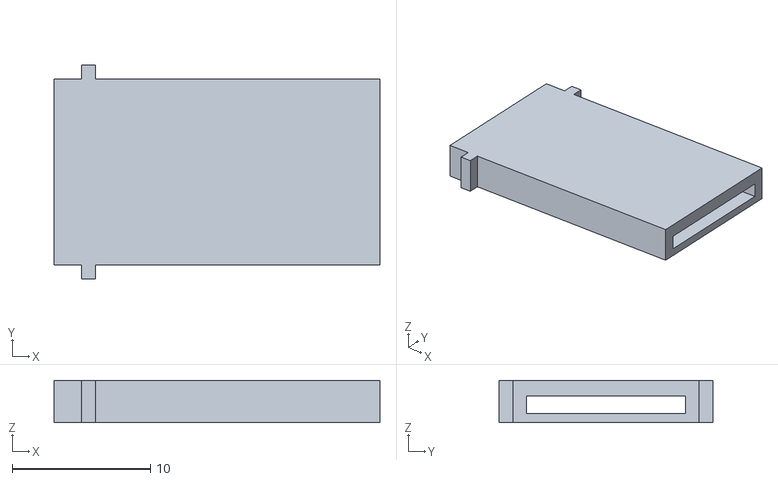
[picture p108: CAD file, 2026-10-03]
out/sd_guide.stl
23.6 x 15.5 x 3.05
