zedward856-spec/minideck/out/parts_in_place/sdr_dongle.stl

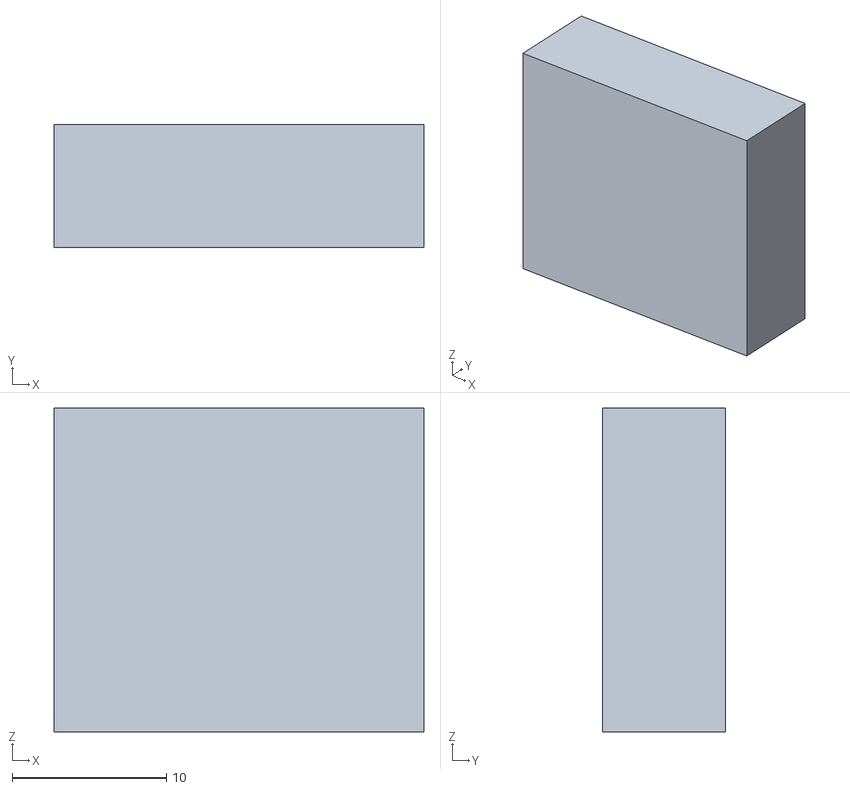
[picture p109: CAD file, 2026-10-05]
out/parts_in_place/sdr_dongle.stl
24.0 x 8.00 x 21.0
