zedward856-spec/minideck/out/parts_in_place/wires_base_gnd.stl

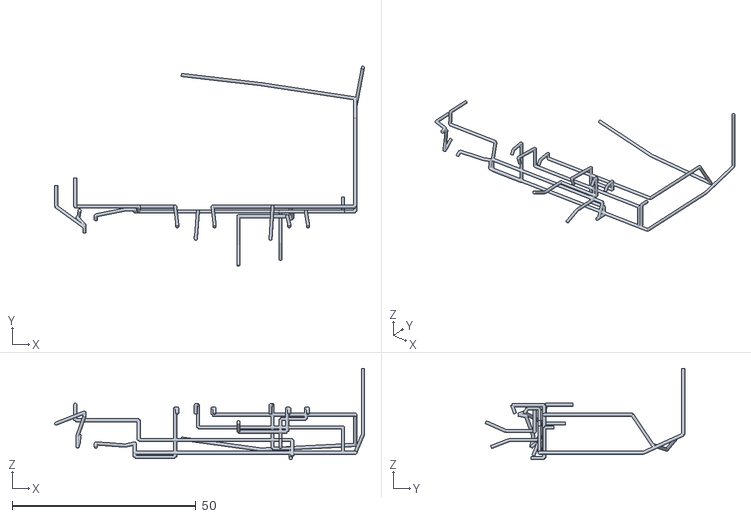
[picture p110: CAD file, 2026-10-05]
out/parts_in_place/wires_base_gnd.stl
84.4 x 54.4 x 24.9
