zedward856-spec/minideck/out/parts_in_place/wires_base_i2c.stl

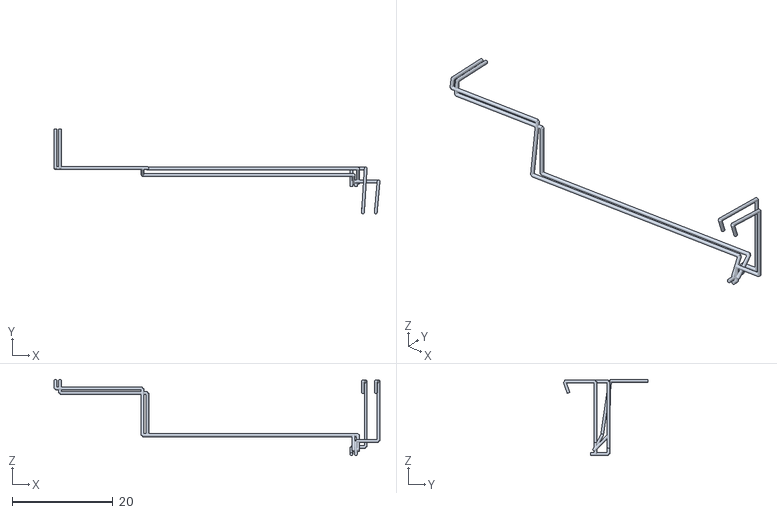
[picture p111: CAD file, 2026-10-05]
out/parts_in_place/wires_base_i2c.stl
64.6 x 16.8 x 15.1
