zedward856-spec/minideck/out/parts_in_place/fill_logos_lid.stl

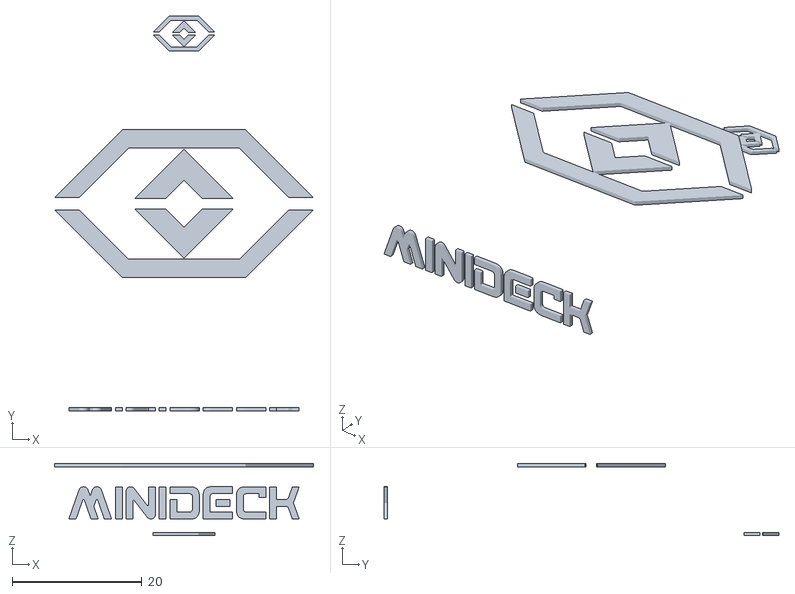
[picture p112: CAD file, 2026-10-05]
out/parts_in_place/fill_logos_lid.stl
40.0 x 61.0 x 11.1
