zedward856-spec/minideck/out/parts_in_place/fill_texture_lid.stl

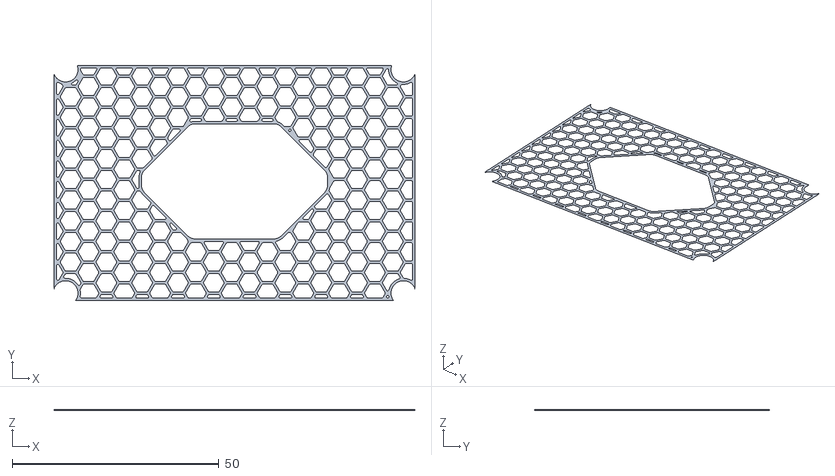
[picture p113: CAD file, 2026-10-04]
out/parts_in_place/fill_texture_lid.stl
87.3 x 56.9 x 0.21
