zedward856-spec/minideck/out/parts_in_place/fill_stripes_lid.stl

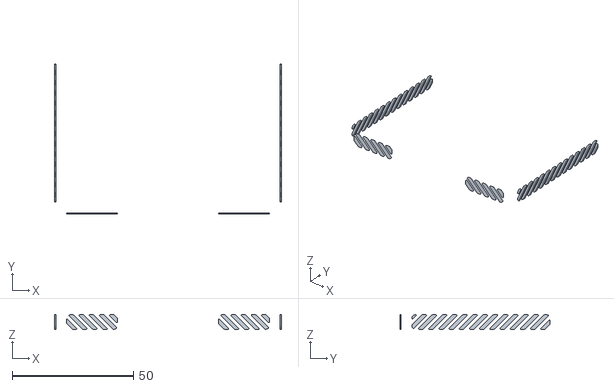
[picture p114: CAD file, 2026-10-04]
out/parts_in_place/fill_stripes_lid.stl
93.7 x 62.1 x 6.00
