zedward856-spec/minideck/out/parts_in_place/fill_caps_base.stl

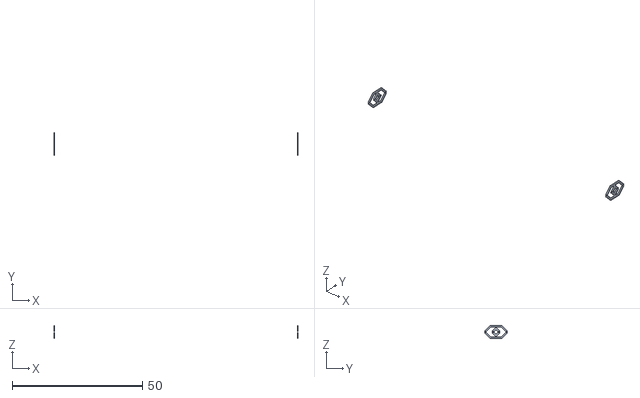
[picture p115: CAD file, 2026-10-04]
out/parts_in_place/fill_caps_base.stl
93.6 x 9.00 x 5.14
