zedward856-spec/minideck/out/parts_in_place/fill_logos_base.stl

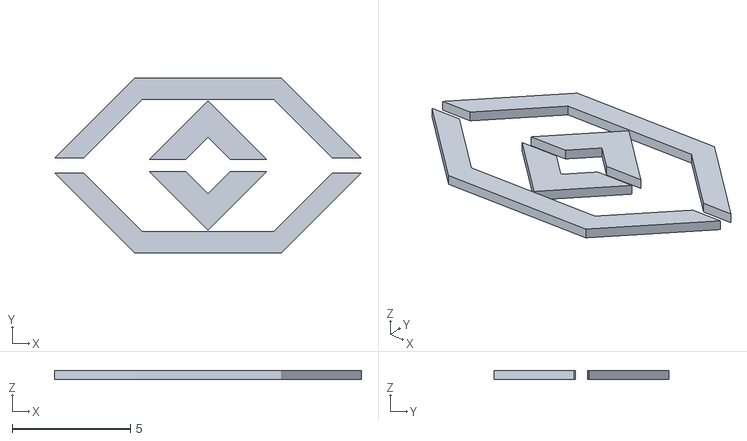
[picture p116: CAD file, 2026-10-04]
out/parts_in_place/fill_logos_base.stl
13.0 x 7.43 x 0.36
