zedward856-spec/minideck/out/parts_in_place/fill_nfc_base.stl

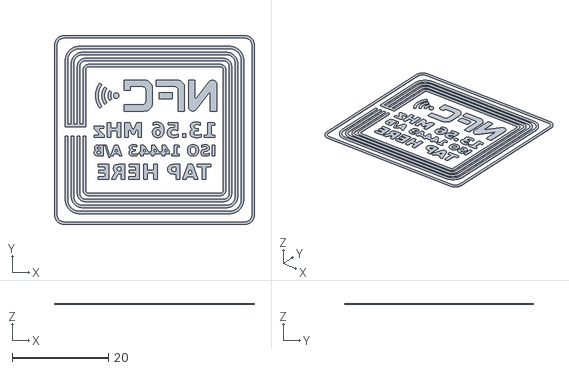
[picture p117: CAD file, 2026-10-04]
out/parts_in_place/fill_nfc_base.stl
41.5 x 39.2 x 0.26
