zedward856-spec/minideck/out/parts_in_place/mt3608.stl

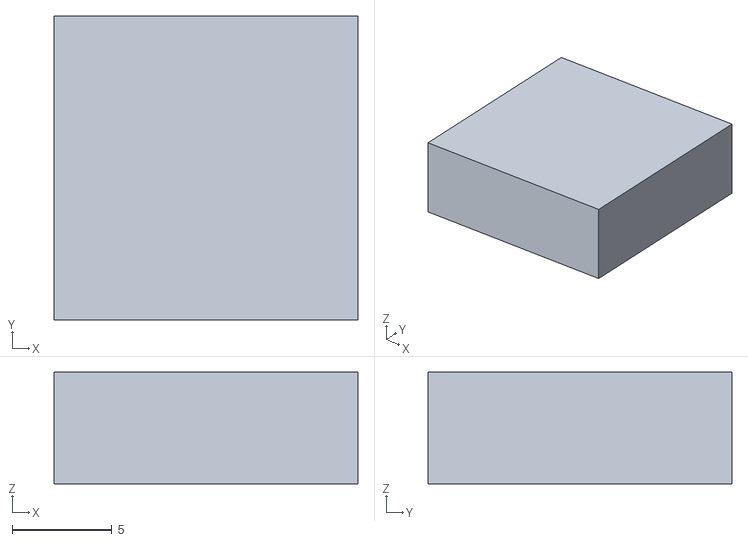
[picture p118: CAD file, 2026-10-04]
out/parts_in_place/mt3608.stl
15.2 x 15.2 x 5.60
