zedward856-spec/minideck/out/parts_in_place/gps_module.stl

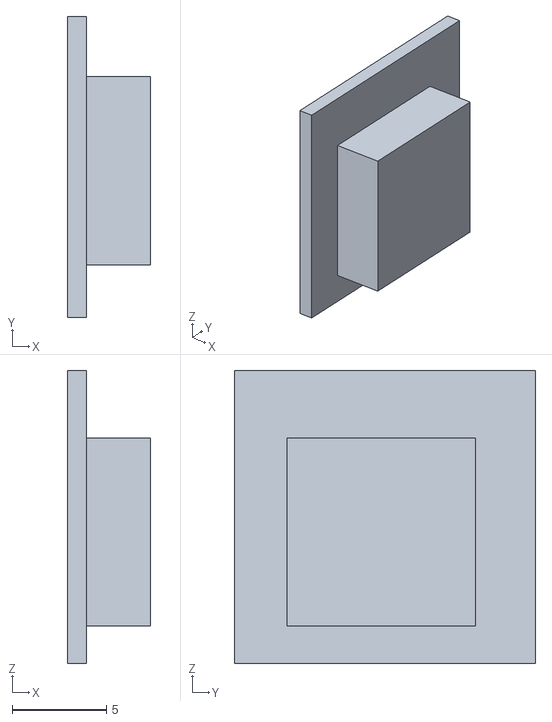
[picture p119: CAD file, 2026-10-04]
out/parts_in_place/gps_module.stl
4.40 x 16.0 x 15.6
