zedward856-spec/minideck/out/parts_in_place/pn532.stl

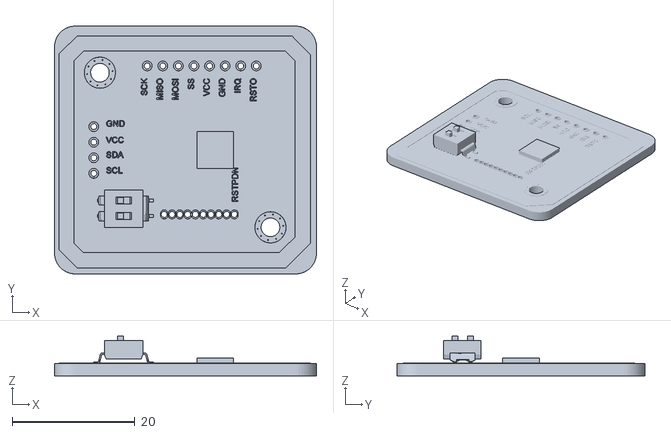
[picture p120: CAD file, 2026-10-04]
out/parts_in_place/pn532.stl
42.7 x 40.4 x 6.45
