zedward856-spec/minideck/out/parts_in_place/tp4056.stl

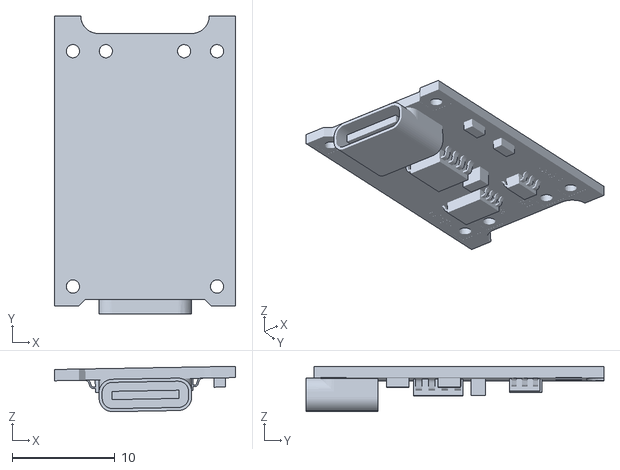
[picture p121: CAD file, 2026-10-03]
out/parts_in_place/tp4056.stl
17.6 x 28.9 x 4.41
