zedward856-spec/minideck/out/parts_in_place/lid_inserts.stl

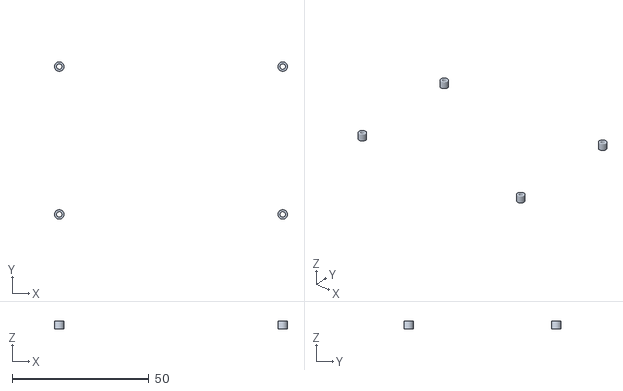
[picture p122: CAD file, 2026-10-03]
out/parts_in_place/lid_inserts.stl
85.2 x 57.6 x 3.00
