zedward856-spec/minideck/out/parts_in_place/lora.stl

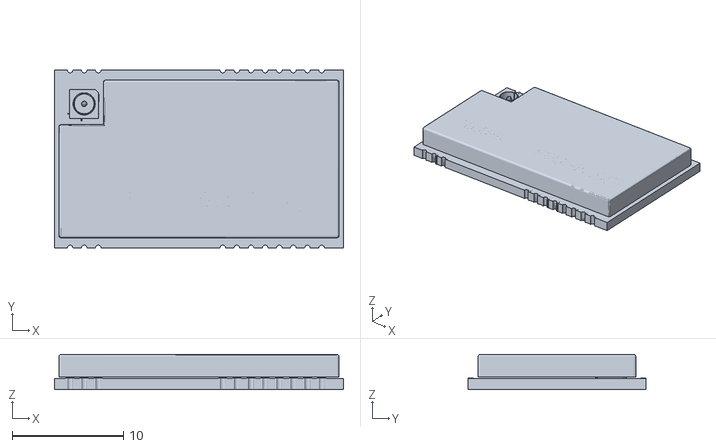
[picture p123: CAD file, 2026-10-03]
out/parts_in_place/lora.stl
26.0 x 16.0 x 3.17
