zedward856-spec/minideck/out/parts_in_place/dac.stl

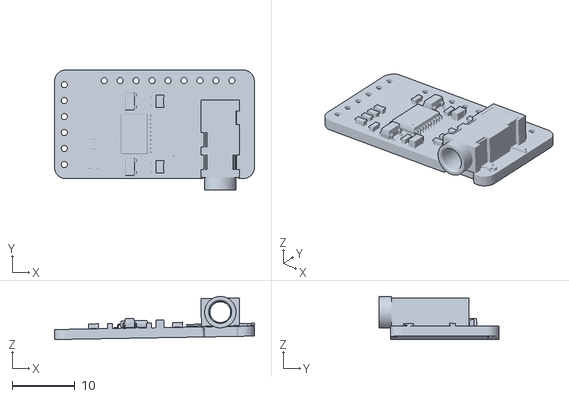
[picture p124: CAD file, 2026-10-03]
out/parts_in_place/dac.stl
31.8 x 19.1 x 6.86
