zedward856-spec/minideck/out/parts_in_place/antenna_wifi.stl

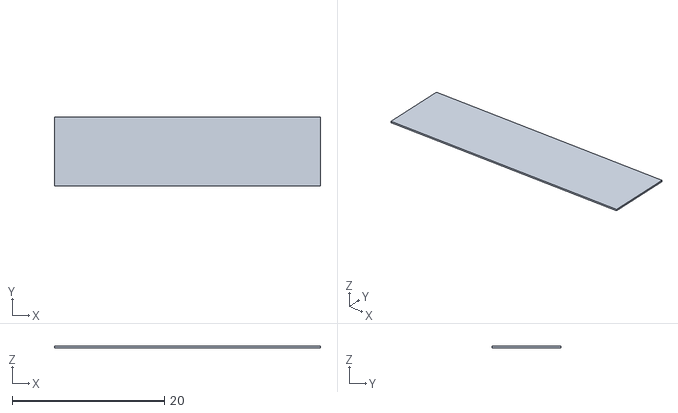
[picture p125: CAD file, 2026-10-03]
out/parts_in_place/antenna_wifi.stl
34.9 x 9.00 x 0.2
