zedward856-spec/minideck/out/parts_in_place/antenna_lora.stl

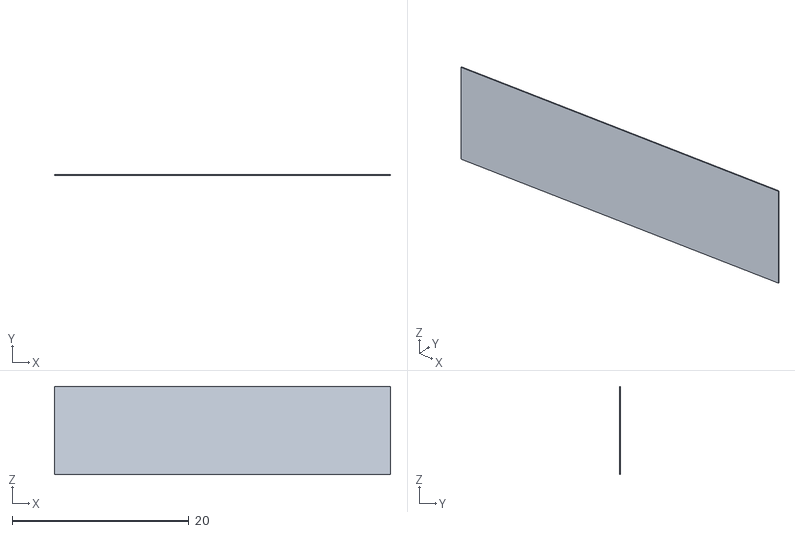
[picture p126: CAD file, 2026-10-03]
out/parts_in_place/antenna_lora.stl
38.0 x 0.1 x 10.0
