zedward856-spec/minideck/out/parts_in_place/torque_hinge.stl

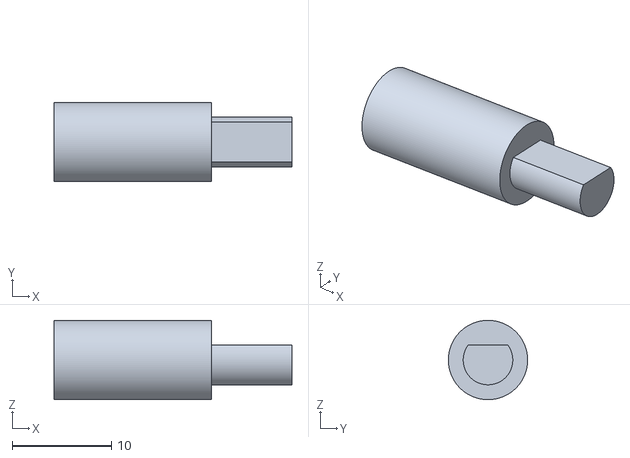
[picture p127: CAD file, 2026-10-03]
out/parts_in_place/torque_hinge.stl
24.0 x 8.00 x 8.00
