zedward856-spec/minideck/out/parts_in_place/sdr_adapter.stl

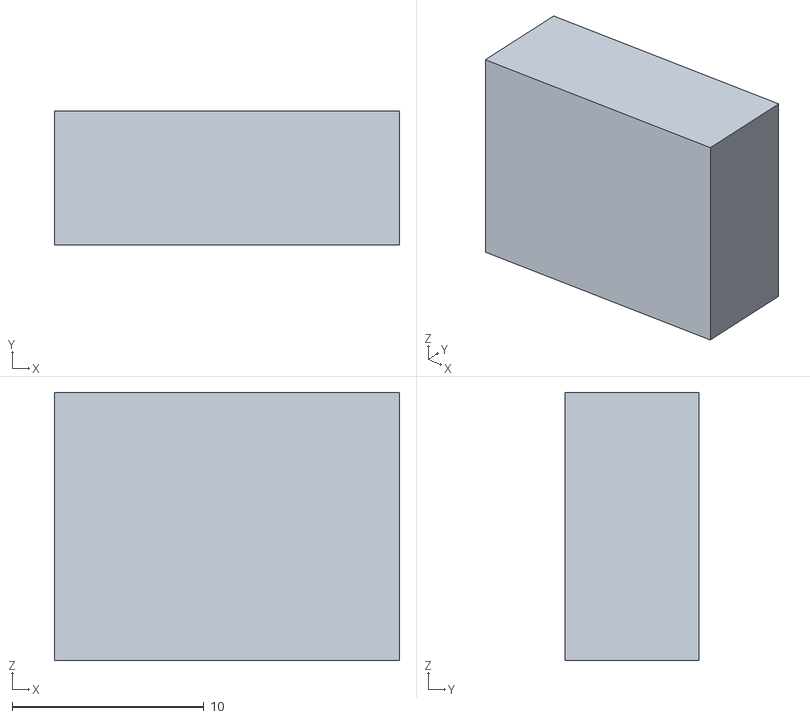
[picture p128: CAD file, 2026-10-03]
out/parts_in_place/sdr_adapter.stl
18.0 x 7.00 x 14.0
