zedward856-spec/minideck/out/parts_in_place/wires_base_hdmi.stl

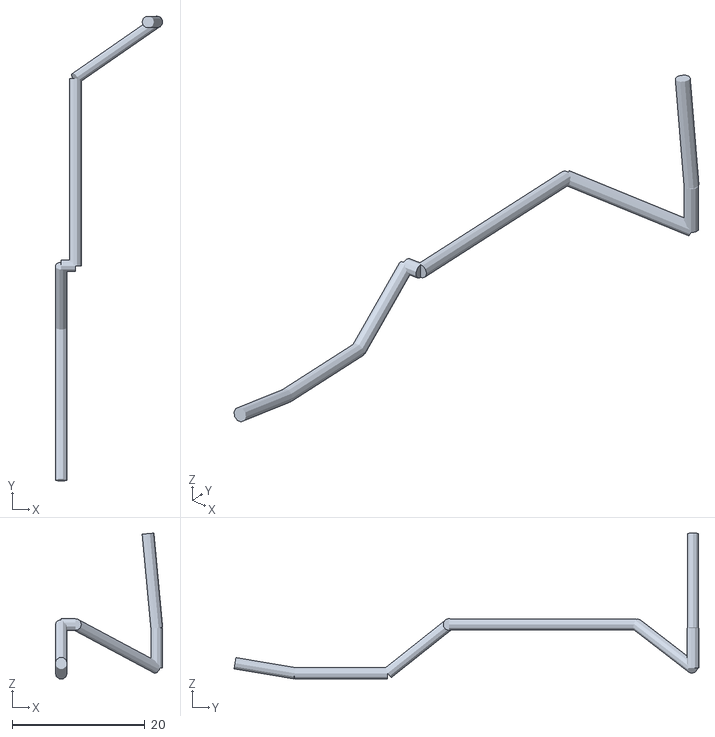
[picture p129: CAD file, 2026-10-03]
out/parts_in_place/wires_base_hdmi.stl
16.2 x 70.0 x 22.0
