zedward856-spec/minideck/out/parts_in_place/m2_hardware.stl

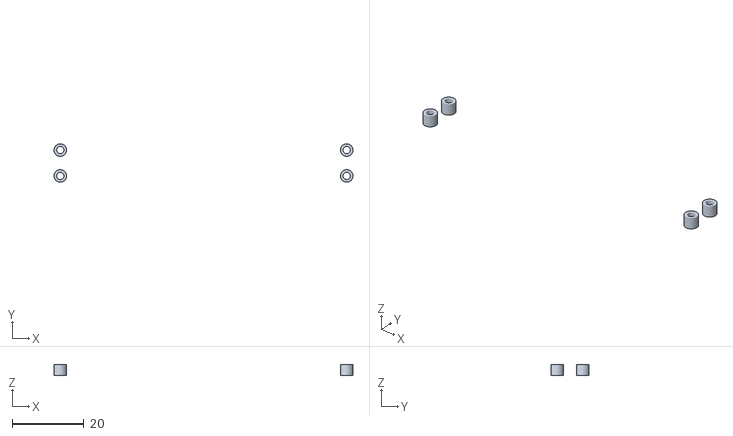
[picture p130: CAD file, 2026-10-03]
out/parts_in_place/m2_hardware.stl
83.2 x 10.7 x 3.00
