zedward856-spec/minideck/out/parts_in_place/wires_lid_pwr.stl

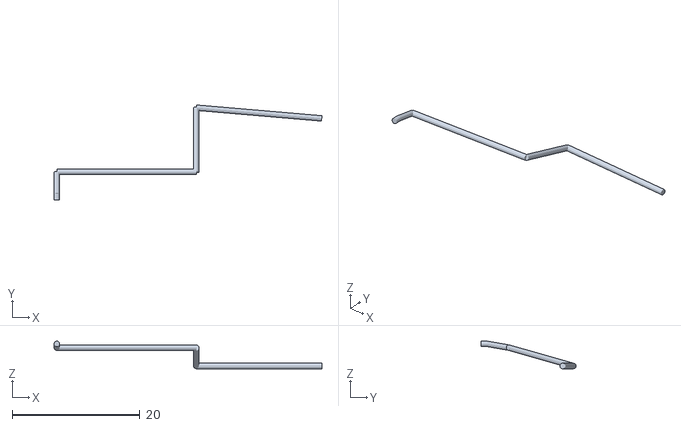
[picture p131: CAD file, 2026-10-03]
out/parts_in_place/wires_lid_pwr.stl
42.0 x 14.9 x 4.35
