zedward856-spec/minideck/out/parts_in_place/wires_lid_hdmi.stl

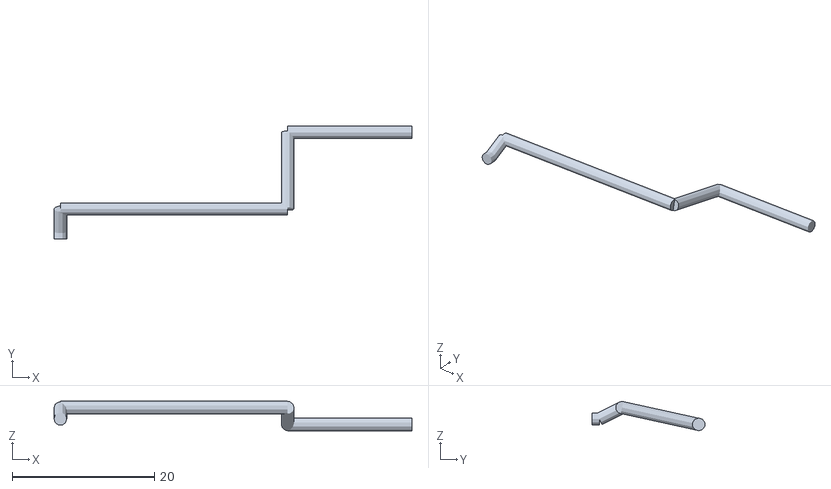
[picture p132: CAD file, 2026-10-03]
out/parts_in_place/wires_lid_hdmi.stl
50.4 x 15.8 x 4.17
