zedward856-spec/minideck/out/parts_in_place/driver_board.stl

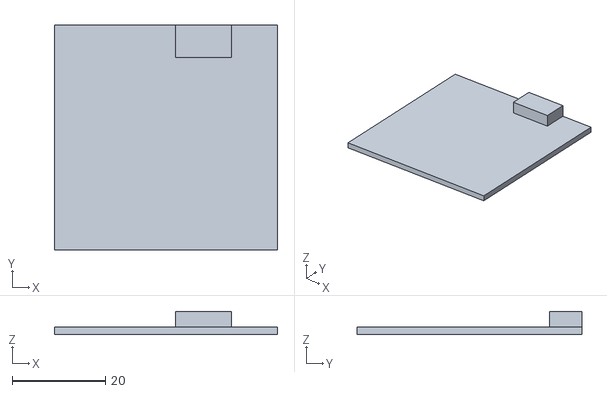
[picture p133: CAD file, 2026-10-03]
out/parts_in_place/driver_board.stl
47.9 x 48.5 x 5.00
