zedward856-spec/minideck/out/parts_in_place/sdr_usb.stl

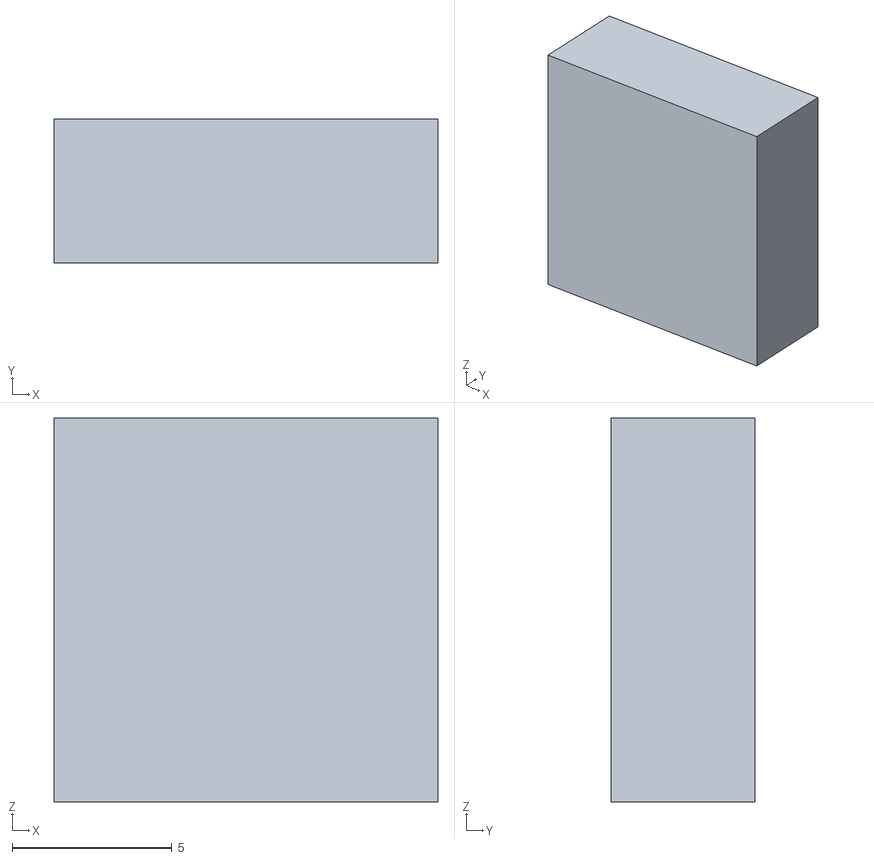
[picture p134: CAD file, 2026-10-03]
out/parts_in_place/sdr_usb.stl
12.0 x 4.50 x 12.0
