zedward856-spec/minideck/out/parts_in_place/gps_patch_antenna.stl

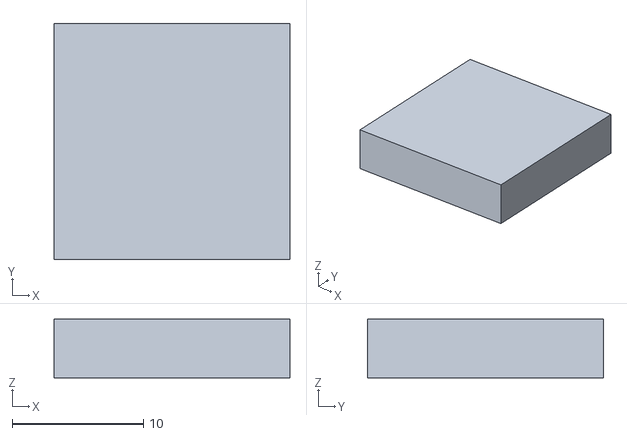
[picture p135: CAD file, 2026-10-03]
out/parts_in_place/gps_patch_antenna.stl
18.0 x 18.0 x 4.50
