zedward856-spec/minideck/out/parts_in_place/wires_lid_gnd.stl

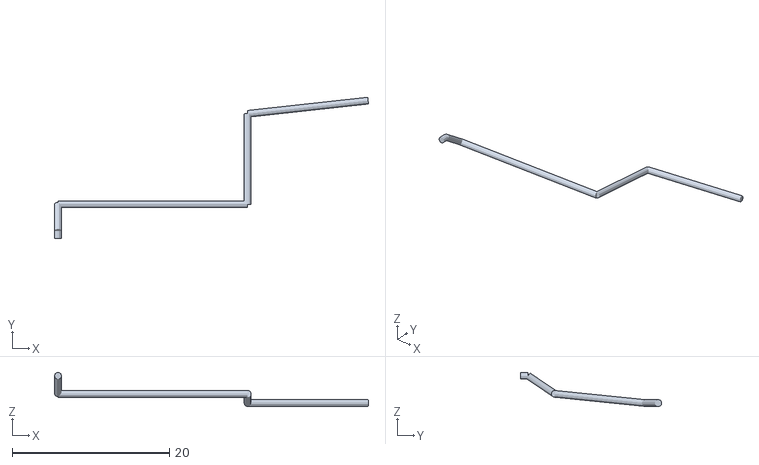
[picture p136: CAD file, 2026-10-03]
out/parts_in_place/wires_lid_gnd.stl
40.0 x 18.0 x 4.35
