zedward856-spec/minideck/out/parts_in_place/antenna_sdr.stl

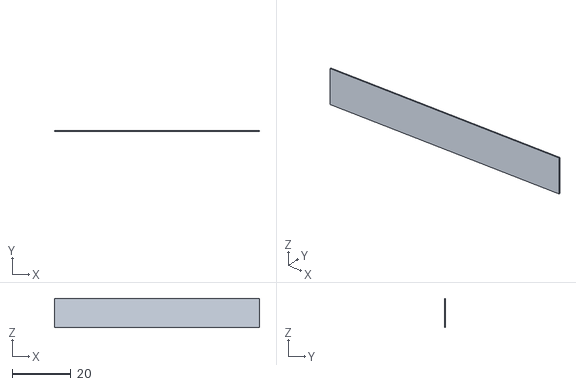
[picture p137: CAD file, 2026-10-03]
out/parts_in_place/antenna_sdr.stl
70.0 x 0.3 x 10.0
