zedward856-spec/minideck/out/parts_in_place/screen_panel.stl

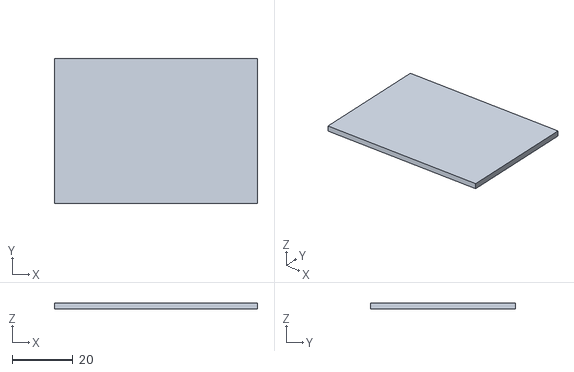
[picture p138: CAD file, 2026-10-03]
out/parts_in_place/screen_panel.stl
66.9 x 47.8 x 2.10
