zedward856-spec/minideck/out/parts_in_place/wires_lid_coax.stl

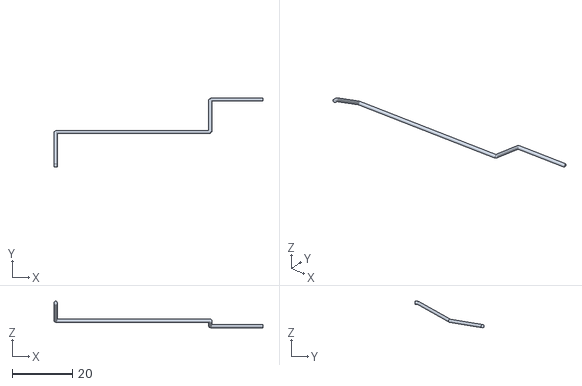
[picture p139: CAD file, 2026-10-03]
out/parts_in_place/wires_lid_coax.stl
69.4 x 23.0 x 8.86
