zedward856-spec/minideck/models/silicone/cardkb_mold.scad

<!DOCTYPE html>
<html
  lang="en"
  
  data-color-mode="auto" data-light-theme="light" data-dark-theme="dark"
  data-a11y-animated-images="system" data-a11y-link-underlines="true"
  
  >




  <head>
    <meta charset="utf-8">
  <link rel="dns-prefetch" href="https://github.githubassets.com">
  <link rel="dns-prefetch" href="https://avatars.githubusercontent.com">
  <link rel="dns-prefetch" href="https://github-cloud.s3.amazonaws.com">
  <link rel="dns-prefetch" href="https://user-images.githubusercontent.com/">
  <link rel="preconnect" href="https://github.githubassets.com" crossorigin>
  <link rel="preconnect" href="https://avatars.githubusercontent.com">

<script type="importmap">{"imports":{"react":"https://github.githubassets.com/assets/react-e27d1b3e03961e68.js","react-dom":"https://github.githubassets.com/assets/react-dom-e5fd46a22d5c4058.js","react-dom/client":"https://github.githubassets.com/assets/react-dom-client-1b4a3ee065998cea.js","react-is":"https://github.githubassets.com/assets/react-is-e0b593954b4706d8.js","react-reconciler":"https://github.githubassets.com/assets/react-reconciler-8e99e505c4429605.js","react/compiler-runtime":"https://github.githubassets.com/assets/react-compiler-runtime-4610bd6d3de9c049.js","react/jsx-dev-runtime":"https://github.githubassets.com/assets/react-jsx-dev-runtime-ea55d68667d559e5.js","react/jsx-runtime":"https://github.githubassets.com/assets/react-jsx-runtime-4915cb0f5b3aff04.js","scheduler":"https://github.githubassets.com/assets/scheduler-58b860b049ca307c.js"}}</script>
<meta name="react-profiling" content="0" data-turbo-transient="true" />
<meta name="react-import-map" content="react,react-dom,react-dom/client,react-dom/profiling,react-is,react-reconciler,react/compiler-runtime,react/jsx-dev-runtime,react/jsx-runtime,scheduler@777f63f87cd0" data-turbo-track="reload" />
<link crossorigin="anonymous" rel="modulepreload" href="https://github.githubassets.com/assets/react-e27d1b3e03961e68.js" />
<link crossorigin="anonymous" rel="modulepreload" href="https://github.githubassets.com/assets/react-compiler-runtime-4610bd6d3de9c049.js" />
<link crossorigin="anonymous" rel="modulepreload" href="https://github.githubassets.com/assets/scheduler-58b860b049ca307c.js" />
<link crossorigin="anonymous" rel="modulepreload" href="https://github.githubassets.com/assets/react-dom-e5fd46a22d5c4058.js" />
<link crossorigin="anonymous" rel="modulepreload" href="https://github.githubassets.com/assets/react-dom-client-1b4a3ee065998cea.js" />
<link crossorigin="anonymous" rel="modulepreload" href="https://github.githubassets.com/assets/react-is-e0b593954b4706d8.js" />
<link crossorigin="anonymous" rel="modulepreload" href="https://github.githubassets.com/assets/react-jsx-runtime-4915cb0f5b3aff04.js" />
<link crossorigin="anonymous" rel="modulepreload" href="https://github.githubassets.com/assets/react-reconciler-8e99e505c4429605.js" />

      <link crossorigin="anonymous" rel="preload" as="script" href="https://github.githubassets.com/assets/global-banner-disable-5554a5e94272b68a.js" />

    <link rel="preload" href="https://github.githubassets.com/assets/MonaSansVF-wdth-wght-opsz-902d64c7ad02.woff2" as="font" type="font/woff2" crossorigin>


  <link crossorigin="anonymous" media="all" rel="stylesheet" href="https://github.githubassets.com/assets/light-99f877e9ddfc0e51.css" /><link crossorigin="anonymous" media="all" rel="stylesheet" href="https://github.githubassets.com/assets/light_high_contrast-48fdd0811afbab3c.css" /><link crossorigi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

  <style type="text/css">
    :root {
      --tab-size-preference: 4;
    }

    pre, code {
      tab-size: var(--tab-size-preference);
    }
  </style>

    <link crossorigin="anonymous" media="all" rel="stylesheet" href="https://github.githubassets.com/assets/primer-primitives-ed9ca172356fd545.css" />
    <link crossorigin="anonymous" media="all" rel="stylesheet" href="https://github.githubassets.com/assets/primer-4136ede8b2650a2d.css" />
    <link crossorigin="anonymous" media="all" rel="stylesheet" href="https://github.githubassets.com/assets/global-54ba76e934a49d7c.css" />
    <link crossorigin="anonymous" media="all" rel="stylesheet" href="https://github.githubassets.com/assets/github-7338c07b3a07b8be.css" />
  <link crossorigin="anonymous" media="all" rel="stylesheet" href="https://github.githubassets.com/assets/repository-11ee8a031c040c1a.css" />

  

  <script type="application/json" id="client-env">{"locale":"en","featureFlags":["actions_enable_background_steps","actions_new_hosted_runner_image_select_sizes_and_versions","activity_diff_file_tree","activity_repos_file_tree","activity_repos_overview_header","activity_repos_overview_sidebar","agent_author_search_expansion","agent_author_search_expansion_ui_pulls","alternate_user_config_repo","async_conversion_coverage_enabled","billing_billable_licenses_cost_center_bucket_fix","billing_budget_expiration","billing_cost_center_list_assigned_resources","billing_discount_threshold_notification","code_quality_enablement_banner_targeting","code_quality_remove_preview","code_view_raf_sticky_lines","codespaces_prebuild_region_target_update","coding_agent_third_party_model_ui","copilot_agent_snippy","copilot_api_agentic_issue_marshal_yaml","copilot_automation_repo_mcp_servers","copilot_automations_pagination","copilot_base_model_policy_row","copilot_chat_auto_mode_v2","copilot_chat_clear_model_selection_for_default_change","copilot_chat_vision_dotcom_chat_ga_gate","copilot_css_textarea_autosize","copilot_custom_copilots","copilot_custom_copilots_feature_preview","copilot_duplicate_thread","copilot_extensions_removal_on_marketplace","copilot_fix_failed_workflows_all_skus","copilot_hide_hovercard","copilot_immersive_task_hyperlinking","copilot_mc_cli_resume_any_users_task","copilot_mission_control_agent_merge_fix_ci","copilot_mission_control_agent_merge_resolve_conflicts","copilot_mission_control_early_stop","copilot_mission_control_managed_sandbox_environments","copilot_mission_control_needs_attention","copilot_mission_control_reasoning_effort","copilot_mission_control_sandbox_remote_bypass","copilot_mission_control_task_alive_updates","copilot_mission_control_task_sharing","copilot_org_policy_page_focus_mode","copilot_share_active_subthread","copilot_spaces_ga","copilot_spaces_individual_policies_ga","copilot_swe_agent_authorization_status_ui","copilot_swe_agent_automation_resource_scoped_writes","copilot_swe_agent_hide_model_picker_if_only_auto","copilot_swe_agent_issue_comment_trigger","copilot_swe_agent_pr_comment_model_picker","copilot_swe_agent_pull_request_comment_trigger","copilot_swe_agent_pull_request_merged_trigger","copilot_swe_agent_pull_request_opened_trigger","copilot_swe_agent_pull_request_synchronize_trigger","copilot_swe_agent_use_subagents","copilot_task_api_github_rest_style","copilot_task_scoped_alive_channel","copilot_token_based_billing","copilot_unconfigured_is_inherited","copilot_user_can_upgrade_plan_field","copilot_workbench_sunset_redirect","dashboard_indexeddb_caching","dashboard_lists_max_age_filter","dashboard_universe_2025_feedback_dialog","fgpat_permissions_selector_redesign","glc_code_quality_repo_settings_workflow_config","hyperspace_2025_logged_out_batch_1","hyperspace_2025_logged_out_batch_2","hyperspace_2025_logged_out_batch_3","in_product_messaging_datadog_monitoring","ipm_ubb_individual_budget_banner","issue_fields_multi_select","issue_inline_avatars","issue_pinned_views","issue_pinned_views_team_vs_personal","issue_relative_time_micro","issues_dashboard_sso_structured_errors","issues_expanded_file_types","issues_hide_closed_sub_issues","issues_index_data_router","issues_lazy_load_comment_box_suggestions","issues_react_chrome_container_query_fix","labels_archiving","labels_archiving_info","landing_pages_ninetailed","lifecycle_label_name_updates","marketing_cookie_consent_banner","marketing_pages_search_explore_provider","memex_default_issue_create_repository","memex_live_update_hovercard","memex_mwl_filter_field_delimiter","memex_remove_deprecated_type_issue","merge_queue_restricted_pushers_warning","merge_status_header_feedback","mergeability_refetch_dedupe","milestone_closed_issues_prioritization","octocaptcha_origin_optimization","primer_react_css_anchor_positioning","primer_react_merged_forwarded_refs","prs_copilot_app_open_action","prs_css_anchor_positioning","prs_docked_comments_replies","prs_thread_reply_as_primary_action","pull_request_copilot_attribution_header","pull_request_overview_panel_edit_description","pull_request_persister","pull_request_stacks_feedback_dialog","pull_request_virtualization_image_estimate","pull_request_virtualization_loader_batching","pull_request_virtualization_scroll_compensation","pull_request_virtualization_scroll_intent","quick_search_lazy_suggestions","react_blob_isolate_code_lines","react_blob_ssr_content_visibility","react_data_router_tanstack_allowed","react_query_props_with_key","react_sandbox_future_tanstack","repo_app_turbo","repo_issues_sidebar_layout","repo_pulls_dashboard_declutter","repo_pulls_dashboard_ga","repo_pulls_dashboard_persistence","repo_pulls_dashboard_sidebar_links","repos_contributors_limited_default_range","review_involves_filter","rule_ignored_file_paths","rulesets_actor_list_editor","sample_network_conn_type","sanitize_preset_math_renderer","security_center_artifact_filters_popover","see_who_reacted","semantic_similarity_duplicate_issue_detection","session_logs_ungroup_reasoning_text","set_sha256_on_repo_creation_form","site_banner_desktop_copilot_app","site_ghca_pixel_mona","site_github_app_ga_page","site_github_app_ga_page_highlight","site_github_app_mobile_native_share","site_global_banner_dev_days_attendee","site_global_banner_learn_copilot_sdk","site_global_nav_spark_models_removed","speculation_rules_ui_service","suggest_custom_property_values_copilot","suppress_automated_browser_vitals","swp_forms_disable_octocaptcha","thread_resolution_reason","universe26_banners_septsession","update_issue_suggestions","viewscreen_sandbox","warn_inaccessible_attachments","webp_support","workstream_plugin_bootstrap"],"githubDomain":"https://github.com","copilotApiOverrideUrl":"https://api.githubcopilot.com","cmcApiUrl":"https://api.github.com/cmc_internal/api"}</script>
<script crossorigin="anonymous" type="module" src="https://github.githubassets.com/assets/high-contrast-cookie-375b8480a0db9429.js"></script>
<link crossorigin="anonymous" rel="modulepreload" href="https://github.githubassets.com/assets/wp-runtime-e352728dfb742452.js" />
<link crossorigin="anonymous" rel="modulepreload" href="https://github.githubassets.com/assets/app-foundation-69691b300d797200.js" />
<link crossorigin="anonymous" rel="modulepreload" href="https://github.githubassets.com/assets/app-runtime-9d34ae1c49571756.js" />
<link crossorigin="anonymous" rel="modulepreload" href="https://github.githubassets.com/assets/fetch-utilities-4b62182bc6e3c348.js" />
<link crossorigin="anonymous" rel="modulepreload" href="https://github.githubassets.com/assets/ser-91fba67ac4479923.js" />
<link crossorigin="anonymous" rel="modulepreload" href="https://github.githubassets.com/assets/tp-18fbcd3be071aa02.js" />
<script crossorigin="anonymous" type="module" src="https://github.githubassets.com/assets/environment-bb974dc7940605fe.js" defer="defer"></script>
<link crossorigin="anonymous" media="all" rel="stylesheet" href="https://github.githubassets.com/assets/app-runtime.c97ea7e7b9bd7544.module.css" />
<link crossorigin="anonymous" rel="modulepreload" href="https://github.githubassets.com/assets/catalyst-86a8f5de995615f8.js" />
<link crossorigin="anonymous" rel="modulepreload" href="https://github.githubassets.com/assets/selector-observer-e88088f989b27670.js" />
<link crossorigin="anonymous" rel="modulepreload" href="https://github.githubassets.com/assets/relative-time-element-fa0968675d128a19.js" />
<link crossorigin="anonymous" rel="modulepreload" href="https://github.githubassets.com/assets/by-6b3c07383371bf58.js" />
<link crossorigin="anonymous" rel="modulepreload" href="https://github.githubassets.com/assets/ja9-36f036c13c2e3a4c.js" />
<link crossorigin="anonymous" rel="modulepreload" href="https://github.githubassets.com/assets/kwb-985b266c34021458.js" />
<link crossorigin="anonymous" rel="modulepreload" href="https://github.githubassets.com/assets/r1-b075aab3204f32f9.js" />
<link crossorigin="anonymous" rel="modulepreload" href="https://github.githubassets.com/assets/jz5-7c5d1669717041f8.js" />
<link crossorigin="anonymous" rel="modulepreload" href="https://github.githubassets.com/assets/hj-5126390ff433704d.js" />
<link crossorigin="anonymous" rel="modulepreload" href="https://github.githubassets.com/assets/j05-1b324859b9512e2d.js" />
<script crossorigin="anonymous" type="module" src="https://github.githubassets.com/assets/github-elements-a0904ef76aa22906.js" defer="defer"></script>
<script crossorigin="anonymous" type="module" src="https://github.githubassets.com/assets/element-registry-4282c89e53d9b9d2.js" defer="defer"></script>
<link crossorigin="anonymous" rel="modulepreload" href="https://github.githubassets.com/assets/runtime-helpers-5ca1e1883536e092.js" />
<link crossorigin="anonymous" rel="modulepreload" href="https://github.githubassets.com/assets/aria-live-edd4f18194230d9e.js" />
<link crossorigin="anonymous" rel="modulepreload" href="https://github.githubassets.com/assets/hotkey-5109c77d7ac61078.js" />
<link crossorigin="anonymous" rel="modulepreload" href="https://github.githubassets.com/assets/react-core-682155419c984691.js" />
<link crossorigin="anonymous" rel="modulepreload" href="https://github.githubassets.com/assets/a9-059e9811745f26d7.js" />
<link crossorigin="anonymous" rel="modulepreload" href="https://github.githubassets.com/assets/ur-024971cb63acad59.js" />
<link crossorigin="anonymous" rel="modulepreload" href="https://github.githubassets.com/assets/4t-364e19c63d726e9a.js" />
<link crossorigin="anonymous" rel="modulepreload" href="https://github.githubassets.com/assets/6ny-c969fbae697a356f.js" />
<link crossorigin="anonymous" rel="modulepreload" href="https://github.githubassets.com/assets/yhq-3a209035a30b1a09.js" />
<link crossorigin="anonymous" rel="modulepreload" href="https://github.githubassets.com/assets/z1v-da5b33b877bfa358.js" />
<link crossorigin="anonymous" rel="modulepreload" href="https://github.githubassets.com/assets/wo-8044e1bac6e0c328.js" />
<link crossorigin="anonymous" rel="modulepreload" href="https://github.githubassets.com/assets/9y-cd2a0ff87351e9aa.js" />
<link crossorigin="anonymous" rel="modulepreload" href="https://github.githubassets.com/assets/j0-41a4cf04cbd99503.js" />
<link crossorigin="anonymous" rel="modulepreload" href="https://github.githubassets.com/assets/0p-81491ed0d9d666e2.js" />
<script crossorigin="anonymous" type="module" src="https://github.githubassets.com/assets/behaviors-a6f3e65faa52fd82.js" defer="defer"></script>
<link crossorigin="anonymous" media="all" rel="stylesheet" href="https://github.githubassets.com/assets/react-core.4a0933a4f8e47de3.module.css" />
  

  <title>Page not found · GitHub · GitHub</title>



  <meta name="route-pattern" content="/:user_id/:repository/raw/*name(/*path)" data-turbo-transient>
  <meta name="route-controller" content="blob" data-turbo-transient>
  <meta name="route-action" content="raw" data-turbo-transient>
  <meta name="fetch-nonce" content="v2:0fe8168c-b4ab-b8f3-c640-5169ab20221b">

    
  <meta name="current-catalog-service-hash" content="f3abb0cc802f3d7b95fc8762b94bdcb13bf39634c40c357301c4aa1d67a256fb">


  <meta name="request-id" content="4E14:3B4915:3A6E8:4FFC9:6ABE41E3" data-turbo-transient="true" /><meta name="html-safe-nonce" content="f2513dc9de273ce01a2670d3f18f100edb47d4fc6a85323b8b6138dc3c2d5ab5" data-turbo-transient="true" /><meta name="visitor-payload" content="eyJyZWZlcnJlciI6bnVsbCwicmVxdWVzdF9pZCI6IjRFMTQ6M0I0OTE1OjNBNkU4OjRGRkM5OjZBQkU0MUUzIiwidmlzaXRvcl9pZCI6IjU1MTA2MzI4MzcxNjM2NjM4NDMiLCJyZWdpb25fZWRnZSI6ImphcGFuZWFzdCIsInJlZ2lvbl9yZW5kZXIiOiJjZW50cmFsdXMifQ==" data-turbo-transient="true" /><meta name="visitor-hmac" content="3cb8c79462baf954f0f84bbabd497a1021993240b50763075a193bc8be9b09d3" data-turbo-transient="true" />


    <meta name="hovercard-subject-tag" content="repository:1055698943" data-turbo-transient>


  <meta name="github-keyboard-shortcuts" content="copilot" data-turbo-transient="true" />
  

  <meta name="selected-link" value="/volbil/cardkb-silicone-mold/raw/main/cardkb_mold.scad" data-turbo-transient>
  <link rel="assets" href="https://github.githubassets.com/">

    <meta name="google-site-verification" content="Apib7-x98H0j5cPqHWwSMm6dNU4GmODRoqxLiDzdx9I">

<meta name="octolytics-url" content="https://collector.github.com/github/collect" />

<meta name="octolytics-page-type" content="marketing" />



  

  




    <meta name="user-login" content="">

  

    <meta name="viewport" content="width=device-width">

    

      <meta name="description" content="GitHub is where people build software. More than 150 million people use GitHub to discover, fork, and contribute to over 420 million projects.">

      <link rel="search" type="application/opensearchdescription+xml" href="/opensearch.xml" title="GitHub">

    <link rel="fluid-icon" href="https://github.com/fluidicon.png" title="GitHub">
    <meta property="fb:app_id" content="1401488693436528">
    <meta name="apple-itunes-app" content="app-id=1477376905, app-argument=https://github.com/volbil/cardkb-silicone-mold/raw/main/cardkb_mold.scad" />

      <meta property="og:url" content="https://github.com">
  <meta property="og:site_name" content="GitHub">
  <meta property="og:title" content="Build software better, together">
  <meta property="og:description" content="GitHub is where people build software. More than 150 million people use GitHub to discover, fork, and contribute to over 420 million projects.">
  <meta property="og:image" content="https://github.githubassets.com/assets/github-logo-55c5b9a1fe52.png">
  <meta property="og:image:type" content="image/png">
  <meta property="og:image:width" content="1200">
  <meta property="og:image:height" content="1200">
  <meta property="og:image" content="https://github.githubassets.com/assets/github-mark-57519b92ca4e.png">
  <meta property="og:image:type" content="image/png">
  <meta property="og:image:width" content="1200">
  <meta property="og:image:height" content="620">
  <meta property="og:image" content="https://github.githubassets.com/assets/github-octocat-13c86b8b336d.png">
  <meta property="og:image:type" content="image/png">
  <meta property="og:image:width" content="1200">
  <meta property="og:image:height" content="620">

  <meta property="twitter:site" content="github">
  <meta property="twitter:site:id" content="13334762">
  <meta property="twitter:creator" content="github">
  <meta property="twitter:creator:id" content="13334762">
  <meta property="twitter:card" content="summary_large_image">
  <meta property="twitter:title" content="GitHub">
  <meta property="twitter:description" content="GitHub is where people build software. More than 150 million people use GitHub to discover, fork, and contribute to over 420 million projects.">
  <meta property="twitter:image" content="https://github.githubassets.com/assets/github-logo-55c5b9a1fe52.png">
  <meta property="twitter:image:width" content="1200">
  <meta property="twitter:image:height" content="1200">




      <meta name="hostname" content="github.com">



        <meta name="expected-hostname" content="github.com">


  <meta http-equiv="x-pjax-version" content="dfe8c95719159cad2f9eecac36454ad68c17cb34e2223c4b8eeb512d5ffe704b" data-turbo-track="reload">
  <meta http-equiv="x-pjax-csp-version" content="c4a65e47b0c850e1157ae8e66298070851d7e3b558038de5a3b4ff7a93e630ed" data-turbo-track="reload">
  <meta http-equiv="x-pjax-css-version" content="4e64a97e5e886e99bcf47a5adeecf4c238f1ab18ffbc37e890c65003e5c96056" data-turbo-track="reload">
  <meta http-equiv="x-pjax-js-version" content="e5968bebefdd043025e80f863b861577f1f41de92d19b06e58ccb8b3b33b49f3" data-turbo-track="reload">

  <meta name="turbo-cache-control" content="no-preview" data-turbo-transient="">

      <link crossorigin="anonymous" media="all" rel="stylesheet" href="https://github.githubassets.com/assets/site-c5780205a1c951aa.css" />
  <link crossorigin="anonymous" media="all" rel="stylesheet" href="https://github.githubassets.com/assets/error-b7f8462e4908b21b.css" />
  <meta name="is_logged_out_page" content="true">

  



      <link rel="canonical" href="https://github.com/volbil/cardkb-silicone-mold/raw/main/cardkb_mold.scad" data-turbo-transient>


    <meta name="turbo-body-classes" content="logged-out env-production page-responsive min-height-full d-flex flex-column">
  <meta name="disable-turbo" content="false">


  <meta name="browser-stats-url" content="https://api.github.com/_private/browser/stats">


  <meta name="browser-errors-url" content="https://api.github.com/_private/browser/errors">

  <meta name="release" content="374ff9a2ecd9b8e144f5cacb91570c875f1b46c7" data-turbo-track="reload">
  <meta name="ui-target" content="canary-2">

  <link rel="mask-icon" href="https://github.githubassets.com/assets/pinned-octocat-093da3e6fa40.svg" color="#000000">
  <link rel="alternate icon" class="js-site-favicon" type="image/png" href="https://github.githubassets.com/favicons/favicon.png">
  <link rel="icon" class="js-site-favicon" type="image/svg+xml" href="https://github.githubassets.com/favicons/favicon.svg" data-base-href="https://github.githubassets.com/favicons/favicon">

<meta name="theme-color" content="#1e2327">
<meta name="color-scheme" content="light dark" />


  <link rel="manifest" href="/manifest.json" crossOrigin="use-credentials">

  </head>

  <body class="logged-out env-production page-responsive min-height-full d-flex flex-column" style="word-wrap: break-word;" >
    <div data-turbo-body class="logged-out env-production page-responsive min-height-full d-flex flex-column" style="word-wrap: break-word;" >
      <div id="__primerPortalRoot__" style="z-index: 1000; position: absolute; width: 100%;" data-turbo-permanent></div>
      

    <div class="position-relative header-wrapper js-header-wrapper ">
      <a href="#start-of-content" data-skip-target-assigned="false" class="px-2 tmp-py-4 color-bg-accent-emphasis color-fg-on-emphasis show-on-focus js-skip-to-content">Skip to content</a>

      <span data-view-component="true" class="progress-pjax-loader Progress position-fixed width-full">
    <span style="width: 0%;" data-view-component="true" class="Progress-item progress-pjax-loader-bar left-0 top-0 color-bg-accent-emphasis"></span>
</span>      
      <link crossorigin="anonymous" rel="modulepreload" href="https://github.githubassets.com/assets/t7l-bf6f21d7e7a43c35.js" fetchpriority="low" />
<link crossorigin="anonymous" rel="modulepreload" href="https://github.githubassets.com/assets/l7j-2ddd8b435dadae28.js" fetchpriority="low" />
<link crossorigin="anonymous" rel="modulepreload" href="https://github.githubassets.com/assets/gzu-b0e631d87d54c83d.js" fetchpriority="low" />
<link crossorigin="anonymous" rel="modulepreload" href="https://github.githubassets.com/assets/bi0-a78ba744687848c2.js" fetchpriority="low" />
<link crossorigin="anonymous" rel="modulepreload" href="https://github.githubassets.com/assets/keyboard-shortcuts-dialog-c5ce28961ac88fda.js" fetchpriority="low" />
<link crossorigin="anonymous" media="all" rel="stylesheet" href="https://github.githubassets.com/assets/primer-react-css.46296dcf75e7a0b0.module.css" />
<link crossorigin="anonymous" media="all" rel="stylesheet" href="https://github.githubassets.com/assets/keyboard-shortcuts-dialog.7051237b9e2e554a.module.css" />

<react-partial
  partial-name="keyboard-shortcuts-dialog"
  data-ssr="false"
  data-attempted-ssr="false"
  data-react-profiling="false"
>
  
  <script type="application/json" data-target="react-partial.embeddedData">{"props":{"docsUrl":"https://docs.github.com/get-started/accessibility/keyboard-shortcuts"}}</script>
  <div data-target="react-partial.reactRoot"></div>
</react-partial>





      

          <link crossorigin="anonymous" rel="modulepreload" href="https://github.githubassets.com/assets/pw-4f91498888595802.js" fetchpriority="low" />
<link crossorigin="anonymous" rel="modulepreload" href="https://github.githubassets.com/assets/app-install-banner-partial-73dc4ef9fbb904f1.js" fetchpriority="low" />
<link crossorigin="anonymous" media="all" rel="stylesheet" href="https://github.githubassets.com/assets/primer-react-css.46296dcf75e7a0b0.module.css" />
<link crossorigin="anonymous" media="all" rel="stylesheet" href="https://github.githubassets.com/assets/app-install-banner-partial.24f0761e99e7816a.module.css" />

<react-partial
  partial-name="app-install-banner-partial"
  data-ssr="false"
  data-attempted-ssr="false"
  data-react-profiling="false"
>
  
  <script type="application/json" data-target="react-partial.embeddedData">{"props":{}}</script>
  <div data-target="react-partial.reactRoot"></div>
</react-partial>


          

                <link crossorigin="anonymous" rel="modulepreload" href="https://github.githubassets.com/assets/fz5-23f28c0f388769c9.js" fetchpriority="low" />
<link crossorigin="anonymous" rel="modulepreload" href="https://github.githubassets.com/assets/jag-4f408bf2b7f99c87.js" fetchpriority="low" />
<link crossorigin="anonymous" rel="modulepreload" href="https://github.githubassets.com/assets/p1-76a75a6081059b19.js" fetchpriority="low" />
<link crossorigin="anonymous" rel="modulepreload" href="https://github.githubassets.com/assets/tua-88f94f65812643db.js" fetchpriority="low" />
<link crossorigin="anonymous" rel="modulepreload" href="https://github.githubassets.com/assets/t1-6f4306b54886c418.js" fetchpriority="low" />
<link crossorigin="anonymous" rel="modulepreload" href="https://github.githubassets.com/assets/marketing-header-86308a74fd732675.js" fetchpriority="low" />
<link crossorigin="anonymous" media="all" rel="stylesheet" href="https://github.githubassets.com/assets/primer-react-css.46296dcf75e7a0b0.module.css" />
<link crossorigin="anonymous" media="all" rel="stylesheet" href="https://github.githubassets.com/assets/primer-react-brand-css.05b219cdb8e80c43.module.css" />
<link crossorigin="anonymous" media="all" rel="stylesheet" href="https://github.githubassets.com/assets/t1.7eb91edfb3032751.module.css" />

<react-partial
  partial-name="marketing-header"
  data-ssr="true"
  data-attempted-ssr="true"
  data-react-profiling="false"
>
  
  <script type="application/json" data-target="react-partial.embeddedData">{"props":{"color_mode":"dark","logged_in":false,"marketing_page":false,"home_path":"/","login_path":"/login?return_to=https%3A%2F%2Fgithub.com%2Fvolbil%2Fcardkb-silicone-mold%2Fraw%2Fmain%2Fcardkb_mold.scad","signup_path":"/signup?ref_cta=Sign+up\u0026ref_loc=header+logged+out\u0026ref_page=%2Fvolbil%2Fcardkb-silicone-mold%2Fraw%2Fmain%2Fcardkb_mold.scad\u0026source=header","signup_enabled":true,"is_signup_controller":false,"show_search_and_nav":true,"hide_search":false,"private_mode_enabled":false,"should_use_dotcom_links":true,"auth_hydro_click":"{\"event_type\":\"authentication.click\",\"payload\":{\"location_in_page\":\"site header menu\",\"repository_id\":null,\"auth_type\":\"SIGN_UP\",\"originating_url\":\"https://github.com/volbil/cardkb-silicone-mold/raw/main/cardkb_mold.scad\",\"user_id\":null}}","auth_hydro_click_hmac":"d1963ccc83ff007b378eaa7e673af92a0edaa166d2de6f49600a2c5b4b5d774a","overlay":false,"fixed":false}}</script>
  <div data-target="react-partial.reactRoot"><div data-color-mode="dark" data-light-theme="light" data-dark-theme="dark"><header class="MarketingHeader-module__root__Tk7n3 HeaderMktg header-logged-out" role="banner" data-marketing-header="true" data-color-mode="dark" data-light-theme="light" data-da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
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
