zedward856-spec/minideck/(list of files, cad)

Other CAD files:
models/silicone/membrane_no_text.3mf
print/charcoal/hinge_box_hatch.stl
models/components/m5stack_cardkb/printables_793686_cardkb-v3.3mf
models/silicone/cardkb_mold.stl
out/parts_in_place/switch_knob.stl
out/switch_knob.stl
out/bottom.stl
out/parts_in_place/box_hatch.stl
out/parts_in_place/bottom.stl
out/screen_back.stl
out/screen_front.stl
out/hinge_axle.stl
out/hinge_cap.stl
out/keyboard_top.stl
out/battery_strip_test.stl
out/battery_door.stl
out/battery_lock_slider.stl
out/parts_in_place/screen_back.stl
out/parts_in_place/hinge_axle.stl
out/parts_in_place/screen_front.stl
out/parts_in_place/keyboard_top.stl
out/parts_in_place/hinge_cap.stl
out/parts_in_place/sd_guide.stl
out/parts_in_place/battery_door.stl
out/parts_in_place/radxa.stl
out/parts_in_place/keyboard.stl
out/parts_in_place/door_lock.stl
models/components/cell_18650/18650_dummy_printables284397_CC-BY.3mf
models/components/heatset_insert_m2/cnckitchen_M2_Short.stl
models/components/tp4056_usbc/tp4056_usbc_printables553096_CC-BY-SA.f3d
out/assembly_with_parts.stl
out/parts_in_place/18650.stl
out/parts_in_place/screws_base.stl
out/parts_in_place/screws_lid.stl
