zedward856-spec/minideck/assembly_report.md

# Assembly check

Parts go in one by one in the build-guide order, each against the case + everything already installed, voxelised at 0.3 mm. 'clear' = it also goes in when grown by 0.3 mm; 'tight' = it only just passes. Wires are flexible and not included.

## Base

| Step | Result | How it goes in |
|---|---|---|
| PN532 into its floor pocket (snaps under its front clips) | OK, drops straight in and snaps under its 2 front corner clips (lips overhang 0.6 mm by design) |  |
| LoRa FPC antenna onto the box's back wall | OK, flexible sticker, bends into place |  |
| SDR FPC antenna onto the box's back wall | OK, flexible sticker, bends into place |  |
| Wi-Fi FPC antenna onto the box roof | OK, flexible sticker, bends into place |  |
| E22 LoRa module | OK, clear | straight in along (0, 0, -1) |
| PCM5102 DAC, jack into the front | OK, **tight** (< 0.3 mm room) | in along (0, 0, -1), then 3.6 mm along (0, -1, 0) |
| Radxa ZERO 3W, upside down, ports to the front | **snap / press fit** (0.3-0.6 mm) | in along (0, 0, -1), then 0.9 mm along (0, -1, 0), then the last 1.2 mm along (0, 0, -1) |
| Pololu U3V40F5 boost, under the charger | OK, clear | straight in along (0, 0, -1) |
| TP4056 charger, USB-C into the front | OK, **tight** (< 0.3 mm room) | in along (0, 0, -1), then 3.6 mm along (0, -1, 0) |
| GPS board, standing on its edge | OK, **tight** (< 0.3 mm room) | straight in along (0, 0, -1) |
| power switch knob (from inside) | OK, **tight** (< 0.3 mm room) | in along (0, 0, -1), then 1.8 mm along (-1, 0, 0) |
| SS12D00 switch, lever into the knob | OK, **tight** (< 0.3 mm room) | in along (0, 0, -1), then 0.3 mm along (-1, 0, 0) |
| NESDR Nano 2+ into the hinge box | OK, clear | straight in along (0, 0, 1) |
| finished lid lowered onto the hinge, between the cheeks | OK, sliding contact (rubs, <= 0.3 mm) | in along (0, 0, -1), then 0.9 mm along (0, 1, 0), then the last 0.6 mm along (0, 0, -1) |
| torque hinge into the left cheek (D-shaft into the lid) | **snap / press fit** (0.3-0.6 mm) | straight in along (1, 0, 0) |
| hollow axle in from the right | **snap / press fit** (0.3-0.6 mm) | straight in along (-1, 0, 0) |
| hinge cap over the torque hinge | OK, clear | straight in along (1, 0, 0) |
| CardKB | OK, clear | straight in along (0, 0, -1) |
| keyboard plate | OK, **tight** (< 0.3 mm room) | straight in along (0, 0, -1) |
| plate screw (front left) | OK, **tight** (< 0.3 mm room) | straight in along (0, 0, -1) |
| plate screw (back left) | OK, sliding contact (rubs, <= 0.3 mm) | straight in along (0, 0, -1) |
| plate screw (front right) | OK, sliding contact (rubs, <= 0.3 mm) | straight in along (0, 0, -1) |
| plate screw (back right) | OK, sliding contact (rubs, <= 0.3 mm) | straight in along (0, 0, -1) |
| 18650 in through the door opening (door still off) | **snap / press fit** (0.3-0.6 mm) | straight in along (1, 0, 0) |
| battery door (hinge pin from the top) | OK, clear | straight in along (1, 0, 0) |
| C-clip lock onto its rail | OK, snap-on C-clip by design: spreads over the rail (fit suite: lips hook 0.4 mm behind it) |  |
| hinge-box hatch (from below) | OK, clear | straight in along (0, 0, 1) |
| hatch screw | OK, sliding contact (rubs, <= 0.3 mm) | straight in along (0, 0, 1) |
| hatch screw | OK, **tight** (< 0.3 mm room) | straight in along (0, 0, 1) |
| hatch screw | OK, sliding contact (rubs, <= 0.3 mm) | straight in along (0, 0, 1) |
| hatch screw | OK, sliding contact (rubs, <= 0.3 mm) | straight in along (0, 0, 1) |

## Lid

| Step | Result | How it goes in |
|---|---|---|
| GPS patch into the lid shell | OK, clear | straight in along (0, 0, 1) |
| screen driver board | OK, clear | straight in along (0, 0, 1) |
| screen panel | OK, clear | straight in along (0, 0, 1) |
| screen bezel | OK, clear | straight in along (0, 0, 1) |
| bezel screw | OK, **tight** (< 0.3 mm room) | straight in along (0, 0, 1) |
| bezel screw | OK, clear | straight in along (0, 0, 1) |
| bezel screw | OK, clear | straight in along (0, 0, 1) |
| bezel screw | OK, clear | straight in along (0, 0, 1) |
