zedward856-spec/minideck/printability_report.md

# Printability audit

nozzle 0.4, layer 0.2, bed 256; parts in their print orientation

## bottom - 8 issue(s)
size [93.7, 81.5, 39.5] mm

- **thin wall (<0.6 mm, min 0.01) x34.5-59.2 y12.7-24.4 z0.1-0.3 (369 samples)**
- **thin wall (<0.6 mm, min 0.01) x34.8-39.4 y27.6-32.2 z0.1-0.3 (66 samples)**
- **thin wall (<0.6 mm, min 0.01) x49.9-58.3 y12.6-15.5 z0.1-0.3 (50 samples)**
- **thin wall (<0.6 mm, min 0.01) x28.5-32.7 y5.6-10.0 z0.3-0.3 (47 samples)**
- **thin wall (<0.6 mm, min 0.01) x28.5-33.1 y35.4-40.0 z0.3-0.3 (47 samples)**
- **thin wall (<0.6 mm, min 0.01) x60.7-65.2 y5.6-10.1 z0.3-0.3 (42 samples)**
- **gap narrower than 0.3 mm (will fuse) x2.0-3.6 y1.9-3.3 z22.1-22.4 (12 samples)**
- **gap narrower than 0.3 mm (will fuse) x90.1-91.7 y1.9-3.3 z22.1-22.4 (11 samples)**
- bridge ~6 mm at z=1.2 (x4-10 y65-78) - fine
- bridge ~6 mm at z=1.2 (x84-90 y65-78) - fine
- bridge ~12 mm at z=22.9 (x2-92 y64-80) - fine
- bridge ~6 mm at z=20.4 (x2-75 y44-52) - fine

## keyboard_top - 10 issue(s)
size [93.7, 64.1, 1.4] mm

- **thin wall (<0.6 mm, min 0.01) x10.7-23.8 y32.9-43.7 z0.0-1.1 (204 samples)**
- **thin wall (<0.6 mm, min 0.01) x89.8-93.6 y60.2-64.0 z1.4-1.4 (48 samples)**
- **thin wall (<0.6 mm, min 0.01) x89.8-93.6 y0.1-3.9 z1.4-1.4 (48 samples)**
- **thin wall (<0.6 mm, min 0.01) x0.1-3.9 y0.1-3.9 z1.4-1.4 (48 samples)**
- **thin wall (<0.6 mm, min 0.01) x0.1-3.9 y60.2-64.0 z1.4-1.4 (48 samples)**
- **thin wall (<0.6 mm, min 0.01) x11.4-11.9 y45.6-46.2 z0.5-0.9 (20 samples)**
- **gap narrower than 0.3 mm (will fuse) x89.8-93.6 y60.2-64.0 z1.4-1.4 (48 samples)**
- **gap narrower than 0.3 mm (will fuse) x89.8-93.6 y0.1-3.9 z1.4-1.4 (48 samples)**
- **gap narrower than 0.3 mm (will fuse) x0.1-3.9 y0.1-3.9 z1.4-1.4 (48 samples)**
- **gap narrower than 0.3 mm (will fuse) x0.1-3.9 y60.2-64.0 z1.4-1.4 (48 samples)**

## screen_front - 3 issue(s)
size [91.1, 61.5, 3.0] mm

- **thin wall (<0.6 mm, min 0.45) x1.6-4.1 y1.6-4.0 z0.0-0.6 (33 samples)**
- **thin wall (<0.6 mm, min 0.45) x89.6-92.1 y1.6-4.0 z0.0-0.6 (33 samples)**
- **flat overhang ~40 mm across at z=0.5 (x17-77 y9-55) - too wide to bridge cleanly**

## screen_back - 5 issue(s)
size [93.7, 79.5, 15.0] mm

- **thin wall (<0.6 mm, min 0.01) x31.2-33.5 y-0.6--0.0 z4.4-6.0 (71 samples)**
- **thin wall (<0.6 mm, min 0.01) x41.2-44.7 y-0.6--0.0 z4.0-8.0 (61 samples)**
- **thin wall (<0.6 mm, min 0.01) x37.3-39.2 y-0.6--0.0 z4.2-7.2 (59 samples)**
- **thin wall (<0.6 mm, min 0.01) x49.2-49.8 y-0.6--0.0 z4.8-7.5 (58 samples)**
- **gap narrower than 0.3 mm (will fuse) x69.8-71.0 y-67.8--67.5 z4.6-9.0 (13 samples)**
- bridge ~6 mm at z=9.7 (x60-71 y-68--62) - fine

## battery_door - 2 issue(s)
size [3.2, 24.2, 21.0] mm

- **thin wall (<0.6 mm, min 0.40) x0.1-3.3 y35.6-38.8 z11.6-11.6 (195 samples)**
- **thin wall (<0.6 mm, min 0.40) x0.1-3.3 y35.6-38.8 z8.2-8.2 (194 samples)**

## battery_lock_slider - 2 issue(s)
size [11.8, 9.3, 4.5] mm

- **thin wall (<0.6 mm, min 0.32) x-14.7--13.5 y63.2-64.5 z0.4-0.4 (124 samples)**
- **thin wall (<0.6 mm, min 0.32) x-10.3--9.1 y63.2-64.5 z0.4-0.4 (124 samples)**

## switch_knob - OK
size [3.4, 12.0, 2.0] mm

## box_hatch - 4 issue(s)
size [85.3, 12.8, 1.2] mm

- **thin wall (<0.6 mm, min 0.56) x85.5-88.0 y74.3-76.7 z0.8-0.8 (126 samples)**
- **thin wall (<0.6 mm, min 0.56) x85.5-88.0 y67.1-69.5 z0.8-0.8 (126 samples)**
- **thin wall (<0.6 mm, min 0.56) x5.8-8.2 y67.1-69.5 z0.8-0.8 (126 samples)**
- **thin wall (<0.6 mm, min 0.56) x5.8-8.2 y74.3-76.7 z0.8-0.8 (126 samples)**

## hinge_axle - OK
size [11.9, 13.0, 15.2] mm

## hinge_cap - OK
size [10.9, 10.8, 1.2] mm
