zedward856-spec/minideck/reports/print_layers_report.md

# Weak-spot check on the sliced parts

From the G-code of `cad/print_sim.py`, each layer drawn as a 0.06 mm pixel image. **Thin bridge carrying a feature** = an area printed over air (not over the layer below or sparse infill) whose roof is only 1-2 layers thick with more structure standing on it. **Thin wall** = a single extrusion line wide and taller than 1 mm. Positions are on the print bed (mm, the part centred at 128, 128).

## battery_door

105 layers of 0.20 mm.

No weak spots.

## battery_door_fit_test

114 layers of 0.20 mm.

No weak spots.

## battery_lock_clip

37 layers of 0.12 mm.

No weak spots.

## case_bottom

198 layers of 0.20 mm.

No weak spots.

## hinge_axle

126 layers of 0.12 mm.

No weak spots.

## hinge_box_hatch

16 layers of 0.20 mm.

No weak spots.

## keyboard_plate

11 layers of 0.12 mm.

No weak spots.

## lid_shell

75 layers of 0.20 mm.

No weak spots.

## screen_bezel

24 layers of 0.12 mm.

No weak spots.

## switch_knob

28 layers of 0.12 mm.

No weak spots.

## torque_hinge_cap

9 layers of 0.12 mm.

No weak spots.
