zedward856-spec/minideck/out/print_sim/battery_door.ini

bed_shape = 0x0,256x0,256x256,0x256
max_print_height = 250
nozzle_diameter = 0.4
filament_diameter = 1.75
printer_technology = FFF
gcode_flavor = marlin2
use_relative_e_distances = 1
temperature = 220
first_layer_temperature = 220
bed_temperature = 55
first_layer_bed_temperature = 55
filament_density = 1.24
filament_cost = 20
filament_type = PLA
perimeters = 2
top_solid_layers = 5
bottom_solid_layers = 3
fill_density = 15%
fill_pattern = grid
top_fill_pattern = monotonic
bottom_fill_pattern = monotonic
infill_anchor = 0
first_layer_height = 0.2
extrusion_width = 0.42
first_layer_extrusion_width = 0.5
perimeter_speed = 200
external_perimeter_speed = 150
infill_speed = 250
solid_infill_speed = 180
top_solid_infill_speed = 120
bridge_speed = 50
gap_fill_speed = 100
first_layer_speed = 50
travel_speed = 500
small_perimeter_speed = 100
support_material_speed = 150
default_acceleration = 10000
perimeter_acceleration = 5000
infill_acceleration = 10000
first_layer_acceleration = 500
travel_acceleration = 10000
bridge_acceleration = 2000
machine_limits_usage = time_estimate_only
machine_max_acceleration_x = 20000
machine_max_acceleration_y = 20000
machine_max_acceleration_extruding = 20000
machine_max_feedrate_x = 500
machine_max_feedrate_y = 500
machine_max_feedrate_z = 20
machine_max_jerk_x = 9
machine_max_jerk_y = 9
support_material = 0
brim_width = 5
skirts = 0
gcode_comments = 0
gcode_label_objects = firmware
layer_gcode = G92 E0
layer_height = 0.2
