zedward856-spec/minideck/(commit log)

2026-10-03 Minideck finished v1: parametric clamshell cyberdeck case
    Case, lid, battery door/lock, hinge parts, wiring plan, checks, viewer with 6 palettes and README renders.
2026-10-03 Site: microSD card, battery swap data, dependency-aware teardown timing
2026-10-03 Build guide (BUILD.md), component model sources; site lives only in minideck-site; 8 inserts; full-length 18650 wrap
2026-10-03 microSD: card-sized slot in the LEFT wall + printed guide sleeve to the socket (it's at the board's left end); right wall closed; checks 50/50
2026-10-03 Remove microSD slot + guide sleeve: both side walls closed, card swapped with the keyboard plate off
2026-10-03 Viewer: restore missing comma so the hinge axle cover and plate-logo fill get their palette colour
2026-10-03 print/: all print files by filament colour, bed-ready, with a print README
2026-10-03 Power switch: SS12D00 in the left wall beside the TP4056, printed pill knob (taller centre), wire routed through it; checks 52/52
2026-10-03 Flush power switch: knob with a thin vertical fin level with the case, 1.4 mm recess with snap lips; charger moved 0.9 mm toward the Radxa for room; checks 53/53
2026-10-04 Switch knob fits from inside only: plate in a pocket on the wall's inner side, thin fin flush through a small slot; checks 53/53
2026-10-04 NFC mark under the PN532 (outline, coil, NFC, 13.56 MHz, ISO 14443 A/B, TAP HERE); switch + knob fit from inside (access channel, lever groove, open-top socket); stripes closer to the switch; checks 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
2026-10-04 PN532 + NFC mark centred left-right (moved 2.37 mm); checks 54/54
2026-10-04 Power: Pololu U3V40F5 boost fed from TP4056 B+/B- via the switch (protected high-drain cell), 47uF input cap, 20-22 AWG; 70 mm chamber for protected cells, GPS stands on edge; Obsidian canvas wiring 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
2026-10-04 Audit: fix LoRa pin note (UART4 = pins 16/18), knob note; NFC small text printable (no sub-0.4 mm slivers); left-side switch image in README; fresh renders, print audit; checks 55/55
2026-10-04 Assembly simulation (assembly_check.py): every part fitted in build order; fixes: Radxa pegs 3.0 -> 1.3 mm (slides in under the front ledge, drops on), battery tube opened into a cradle over the PN53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
2026-10-04 Thermal results on GitHub: README section with table + heat maps, link to the interactive thermal lab; thermal_export.py
2026-10-04 SDR on hatch ribs (17 mm2 contact instead of 192), SDR antenna coax, sharp logo tips
    - SDR lifted 0.35 mm onto two thin hatch ribs with locating posts, moved 1 mm back
    - SDR model: MCX jack on the left end, USB (wired) end toward the bay; MCX-to-u.FL coax to the SDR FPC
    - logo: chevron tips nudged off the frame instead of a round bridge (kept sharp)
    - thermal sim: sub-mm gap correction around the SDR; report + lab data regenerated
    - build guide: hatch goes on over the SDR
2026-10-04 README: link the wiring canvases, viewer/AR, thermal lab and reports
2026-10-04 Organise the repo: scripts in cad/, reports in reports/, Android app backed up in app/
    - cad/: all build123d / check / simulation / export scripts; cad/_here.py makes them run from the repo root
    wherever they're launched
    - reports/: fit, assembly, thermal and printability reports (scripts write there now)
    - app/: the offline Android viewer (com.zedward.minideck), build output ignored
    - README: layout map, app + wiring canvas entries; docs updated to the new paths
2026-10-04 Assembly check rerun after the SDR move: 39/39 fit, 0 blocked, 7 tight
2026-10-04 Cosmetic engravings: port labels, switch | / O, lock arrow, underside plates, lid hex texture
    - cad/marks.py: PWR / PWR / DATA + headphones over the front ports (checked against Radxa's v1.11 silkscreen:
    USB_OTG left, USB3.0 right); a rounded bar (ON) and ring (OFF) right beside the switch slot, 0.2 mm deep on
    the knob pocket's 0.7 mm skin; open arrow by the battery lock; underside battery outline under the cell
    (+/- at the right ends), ID plate (sl01220) and radio plate either side of the NFC mark; lid hex texture
    - every mark clipped to where >= 0.45 mm of wall stays (0.5 mm on the switch skin)
    - stripes run over the knob pocket at 0.2 mm, so they come right up to the switch marks
    -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
2026-10-05 Stripes by the switch: one depth per bar (no seam where the knob pocket starts)
    Bars that reach the knob pocket's 0.7 mm skin are cut 0.2 mm along their whole length; the wall test samples
    just past the existing 0.6 mm stripe floors. (Source only; outputs regenerate on the next full build.)
2026-10-05 Hatch lip, wiring fixes, wiring page data, fresh snapshots
    - hatch: stepped edge - a 0.6 mm flange under a 0.8 mm ledge all round (no straight gap to look or dust
    through, supported on every edge) + 1.6 mm stiffening rims; new check (57/57 pass); assembly 0 blocked
    - SDR 0.5 mm further back so its front posts sit on the hatch's raised part
    - wiring: 3D routes now land on the right pads (pin 1 at the microSD = left end); battery leads 20-22 AWG
    (whole load); SDR VBUS from the 5 V splice in the notes; CardKB 3.3 V and MAX17048 battery-gauge notes
    - cad/site_wiring.py + out/wiring_site.json feed the site's new wiring page
    - PC viewer: labels / underside plates follow each palette's main acc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
2026-10-05 Web model: meshopt-compressed with baked creased normals (0.86 MB instead of 2.35 MB)
    - cad/site_export.py: normals creased at export (35 deg), raw copy in out/web/ (gitignored), gltfpack -cc
    quantized 14/8 bit -> site; plan_explode reads the raw copy
    - app: MeshoptDecoder vendored, skips runtime creasing when normals are baked
2026-10-05 Print simulation + weak-spot check; knob, hatch and recess fixes; RTL-SDR on the radio plate
    - cad/print_sim.py: slices every print file with PrusaSlicer (Bambu-like PLA setup) and renders each part
    (3D by line type, layer-by-layer GIF, layer slices) + times / filament -> docs/print-sim/ (~4.5 h, ~86 g)
    - cad/print_layers_check.py: weak spots from the G-code (thin bridges carrying a feature, single-line walls)
    -> reports/print_layers_report.md; all parts clean
    - switch knob: was a fin on one bridged 0.15 mm layer; lever trimmed to 0.6 mm (solid backbone) and the
    knob prints on its edge so fin and plate share every layer
    - hatch: rims 1.0 mm, SDR posts 1.0, end stops 1.2 (were single-li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
